cbkiyanda/AR/Documents/Capstone 2017-18/Design Proposal and Feasibility Study/12 MINI_PDM_V1.pdf

CAPSTONE MiniPDM | Page 1 of 1
Year | 2017
Team | Group #9
Device | AR Headset
| | | | | CASH | CASH | CAPCOIN | CAPCOIN | SPONSOR
CODE | Item Description | Drawing#/Part# | MNF/OEM/SPL | QTY | Material [$] | Labour [$] | CODE | Capcoin$ | In Kind
1 | Screen | SC-01 | | 1 | | - | - | - | Dr. Kiyanda
2 | Adafruit BNO 055 (motion sensor) | MS-01 | | 1 | | - | - | - | Dr. Kiyanda
3 | Intel realsense camera R200 | IR-01 | TO BE PURCHASED | 1 | 100 | - | - | -
4 | Odroid XU4 | XU4-01 | TO BE PURCHASED | 1 | 107 | - | - | -
5 | Headset | HS-01 | STUDENT (3D PRINT) | 1 | | - | - | -
6 | Top cover | TC-01 | STUDENT (3D PRINT) | 1 | | - | - | -
7 | Back cover | BC-01 | STUDENT (3D PRINT) | 1 | | - | - | -
8 | Back piece | BP-01 | STUDENT (3D PRINT) | 1 | | - | - | -
9 | Screen viewer | SV-01 | | 1 | | - | - | -
10
SUBTOTALS | 207 | 0 | 0 | 0 | 0

CON-M490-295.20/09/2012
