cbkiyanda/AR/Documents/Capstone 2017-18/FFF/TSPCD  (1).pdf

CAPSTONE TEST SPECIFICATION | Page 1 of 1 TEAM xx
Team | #9
Device | Augmented Reality Headset
Test date | TBD | | VERSION
Location | Concordia University | Program Manager | 1.0
Test LEAD | Faraz Yunus | Professor
Test co-lead | Nicholas Cierson
Test STAFF | TBD

Observers

## ENGINEERING VALIDATION TESTS

## HAZARD and MISHAP ANALYSIS

Hazard types
(ref 2)
Name of analysis | Description of test | Expected | Observed | Date | Movement | stored energy sharp edges electricity substancesradiation physical agents | Severity Probability Corrective or Control ActionAction verified Implementation Date
VAL1 | Drop Test | Drop the AR headset at different heights and observe whether device failure
| occurs
No Failure Occurs | No | Yes | Yes | No | No | No | Danger of flying objects | Medium | High | Proper protective equipment worn during test. Fire extinguisher is nearby.
| No | No | Yes | No | No | No | Danger of Fire | Medium | Low
| No | No | Yes | No | No | No | Danger of flying objects and burning yourself | Medium | Low
No Hardware comes Loose | No | No | Yes | No | No | No | Danger of flying objects | Medium | Medium
VAL2 | Thermal Test Part A | The AR headset will be run to its maximum capacity to demonstrate its baseline temperature
VAL3 | Thermal Test Part B | The AR headset will be placed in the wind tunnel to find the optimal air speed required to bring the temperature to 30C
VAL4 | Vibration Test | Vibrate the AR headset in a vibration machine and observe whether the
harware comes loose

## PREOPERATION CHECKS FOR VAL 1

SAFETY
Name of Task | Description | Checked | Initials | Date
SFT1 | Test Brief | Inform everyone of the test taking place
SFT2 | Personal Protective Equipment | Ensure all test personnel are wearing the appropriate protective equipment (Safety Glasses)
SFT3 | Projectile | Ensure a barrier is placed to limit the movement of projectiles

DEVICE INTEGRITY

DEV1 | Structural | Ensure that the AR headset is free from structural damage
DEV2 | Assembly - BOM | Assembly is complete - no missing components.

INSPECTION

INS1 | Device Inspection | Engineer or Staff signature :

## PREOPERATION CHECKS FOR VAL 2

SAFETY
Name of Task | Description | Checked | Initials | Date
SFT1 | Test Brief | Inform everyone of the test taking place
SFT2 | Fire | Ensure a fire extinguisher is near by in case of a fire

DEVICE INTEGRITY

DEV1 | Structural | Ensure that the AR headset is free from structural damage
DEV2 | Assembly - BOM | Assembly is complete - no missing components.

SYSTEM INTEGRITY

SYS1 | Temperature | Ensure a thermocouple is placed inside of the AR headset

INSPECTION
INS1 | Device Inspection | Engineer or Staff signature :

## PREOPERATION CHECKS FOR VAL 3

SAFETY
Name of Task | Description | Checked | Initials | Date
SFT1 | Test Brief | Inform everyone of the test taking place

DEVICE INTEGRITY

DEV1 | Structural | Ensure that the AR headset is free from structural damage
DEV2 | Assembly - BOM | Assembly is complete - no missing components.
DEV3 | Fasteners | Ensure that the AR headset is properly fastened to the windtunnel

SYSTEM INTEGRITY

SYS1 | Temperature | Ensure a thermocouple is placed inside of the AR headset
SYS2 | Wind Tunnel | Ensure that the Wind tunnel is working
SYS3 | Kill Switch | Ensure that the kill switch for the wind tunnel is free of obstruction and operational. TEST

INSPECTION
INS1 | Device Inspection | Engineer or Staff signature :

## PREOPERATION CHECKS FOR VAL 4

SAFETY
Name of Task | Description | Checked | Initials | Date
SFT1 | Test Brief | Inform everyone of the test taking place
SFT2 | Personal protective equipment | Ensure all test personnel are wearing the appropriate protective equipment (Safety Glasses)

DEVICE INTEGRITY

DEV1 | Structural | Ensure that the AR headset is free from structural damage
DEV2 | Assembly - BOM | Assembly is complete - no missing components.
DEV3 | Fasteners | Ensure that the AR headset is properly fastened to the vibration machine

SYSTEM INTEGRITY

SYS1 | Vibration | Ensure that the vibration machine is woking
SYS2 | Kill Switch | Ensure that the kill switch for the vibration machine is free of obstruction and operational. TEST

INSPECTION
INS1 | Device Inspection | Engineer or Staff signature :

## PRE-TEST

Objective | Description of Test | Checked | Initials | Date
OPS1 | Baseline Temperature | Bring the AR headset to its baseline temperature, required for "Thermal Test
| Part B"

COMMENTS

References
1 | MIL-STD-882D
2 | Safey with Machinery, John Ridley and Dick Pearce, 2006

Approvals for testing

Description

CON M490-285.04/03/2014
