cbkiyanda/AR/Documents/Capstone 2017-18/Final Report/Final Gantt Chart.xlsx

AUGMENTED REALITY HEADSET
TEAM 9
 |  | September |  |  |  | October |  |  |  | November |  |  |  | December |  |  |  | January |  |  |  | February |  |  |  | March |  |  |  | April
TASK | ASSIGNED TO | 1899-12-31 | 1900-01-01 | 1900-01-02 | 1900-01-03 | 1899-12-31 | 1900-01-01 | 1900-01-02 | 1900-01-03 | 1899-12-31 | 1900-01-01 | 1900-01-02 | 1900-01-03 | 1899-12-31 | 1900-01-01 | 1900-01-02 | 1900-01-03 | 1899-12-31 | 1900-01-01 | 1900-01-02 | 1900-01-03 | 1899-12-31 | 1900-01-01 | 1900-01-02 | 1900-01-03 | 1899-12-31 | 1900-01-01 | 1900-01-02 | 1900-01-03 | 1899-12-31 | 1900-01-01 | 1900-01-02 | 1900-01-03
Preliminary Design Ideas, Brainstorming and Planning
Project Choice | All
Project Planning and Deadline Setting | Rahul
Initial Capstone Professor Meeting | All
Setting Design Criterias and Scope of Project | Rahul
Letter of Intent/Team Engineering | All
Audit 1 | All
Conceptual Design
Initial Design (V1) | Amir
Updating Design Revisions (V2-5) | Amir, Michael
Design Proposal and Feasibility Study | All
Audit 2 | All
FFF Completion | All
Manufacturing, Sourcing and Assembly
3D Printing Revisions 1-5 | Haseb
Component Sourcing | Kostas
Audit 3 | All
Audit 4 Package | Rahul
Midterm Progress Report + Pres | All
Final Manufacturing Drawing | All
Hardware/Software Integration
BNO055 Integration | Nicholas
Libreal Sense Integration | Nicholas
Pyreal Sense Integration | Nicholas
Coding Demos | Nicholas
Debugging | Nicholas
Testing and Engineering Analysis (FEA)
TSPCD | Faraz, Rahul
Steady force and Impact Test | Haseb, Faraz
Thermal and Vibration Test | Michael, Haseb
Screen Angle Test | Michael, Haseb
Drop Test | Kostas
FEA Engineering Analysis (Structural, Drop, Thermal) | Amir, Rahul
Final Project Documentation and Presentation
Prototype Demonstration Preparation | All
Audit 5 Preparation | All
Workbook and Doc Control | All
Final Capstone Report | All
Poster Session Preperation | All
