cbkiyanda/AR/Documents/Capstone 2017-18/Audit 4/IMG_3721.JPG

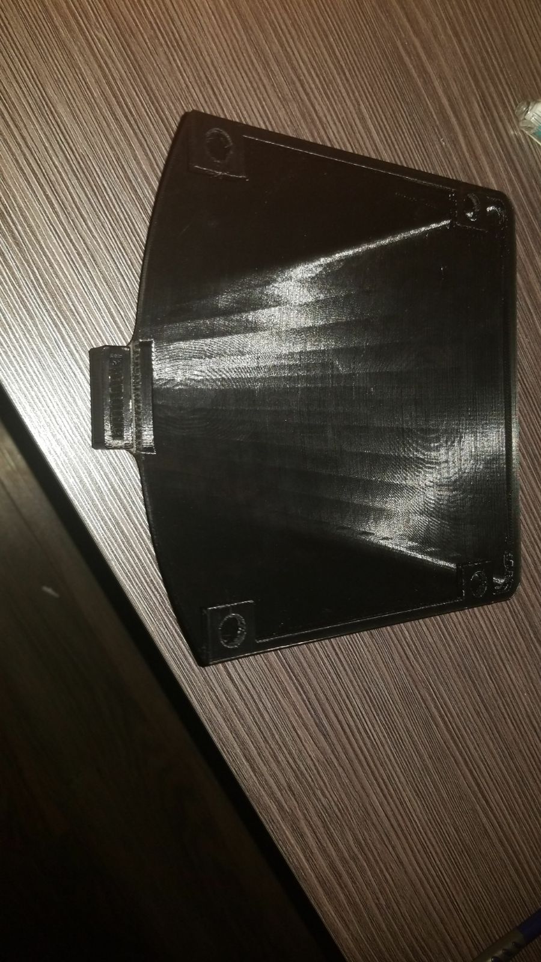
Documents/Capstone 2017-18/Audit 4/IMG_3721.JPG
