cbkiyanda/AR/Documents/Capstone 2017-18/Engineering Drawings/V5/Screenshot 1.png

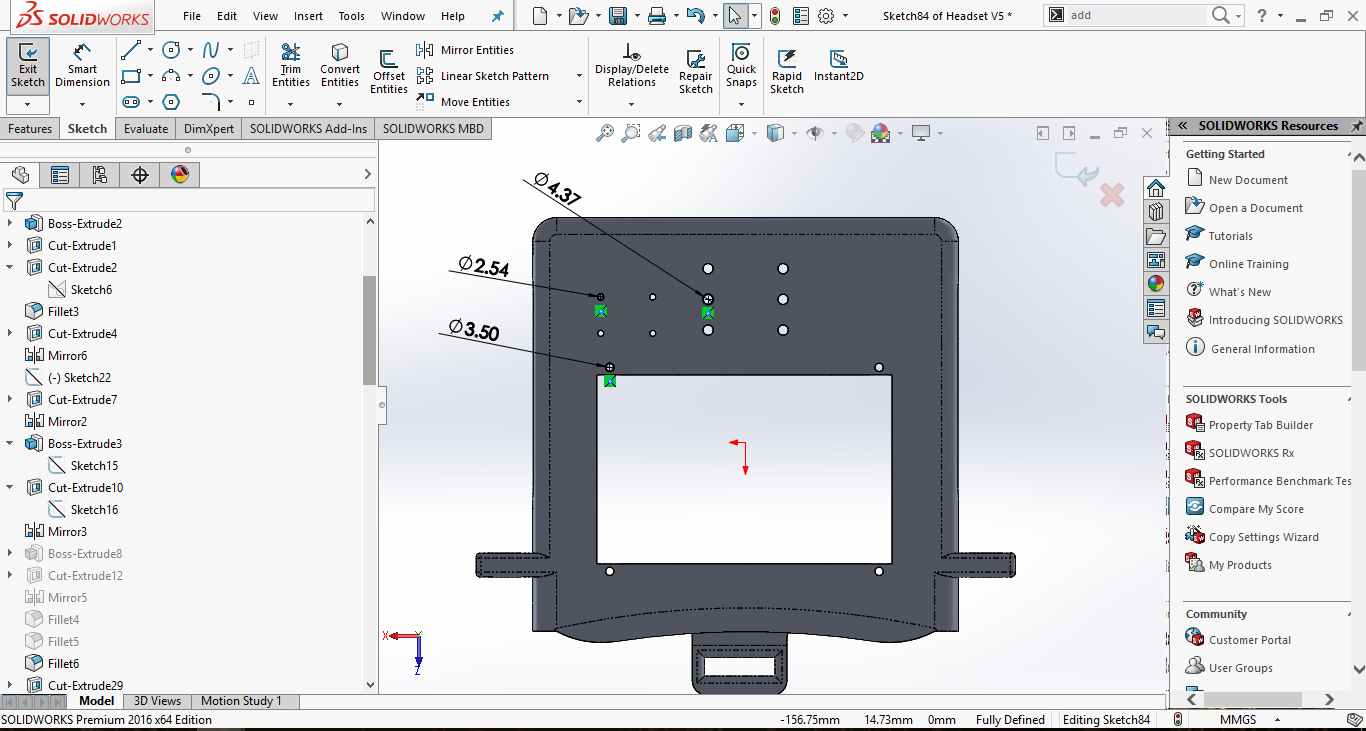
Documents/Capstone 2017-18/Engineering Drawings/V5/Screenshot 1.png
