cbkiyanda/AR/Documents/Capstone 2017-18/Engineering Drawings/V5/Screenshot 2.png

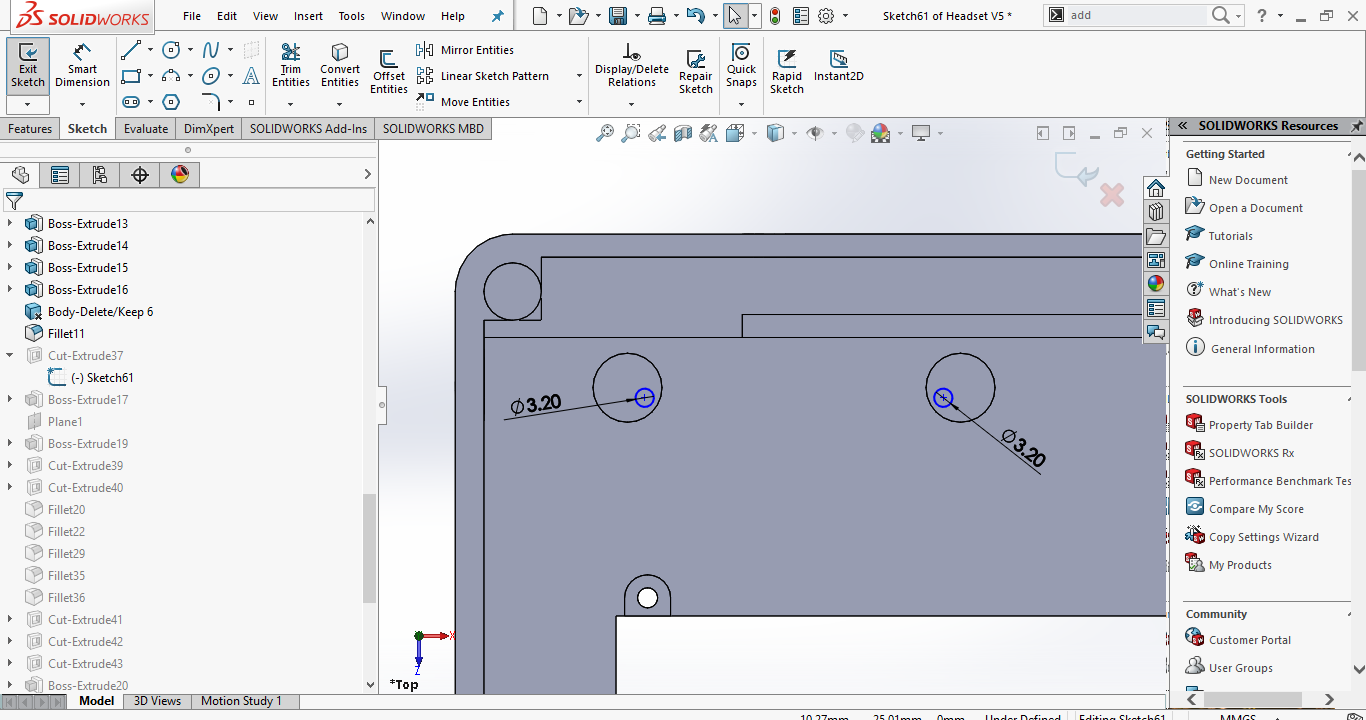
Documents/Capstone 2017-18/Engineering Drawings/V5/Screenshot 2.png
