cbkiyanda/AR/Documents/Capstone 2017-18/Final Report/4a936c2b-bbe0-454d-a4c9-a7ad5c63fba5.jpg

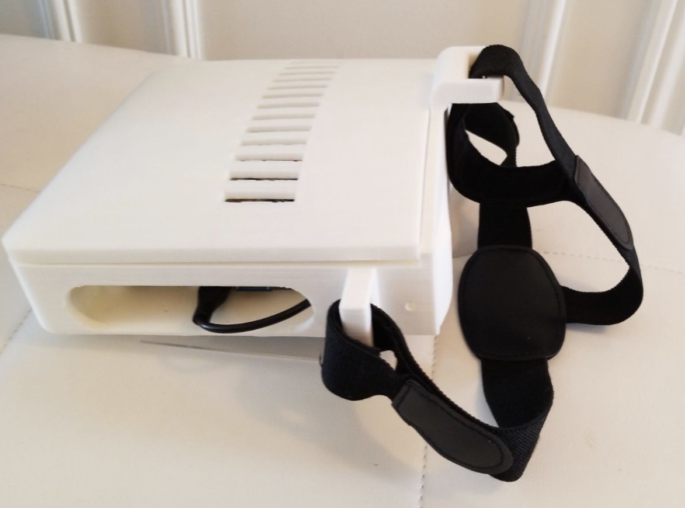
Documents/Capstone 2017-18/Final Report/4a936c2b-bbe0-454d-a4c9-a7ad5c63fba5.jpg
