cbkiyanda/AR/Documents/Capstone 2017-18/Final Report/4e1723fa-922e-4120-b9d4-401a825bd13e.jpg

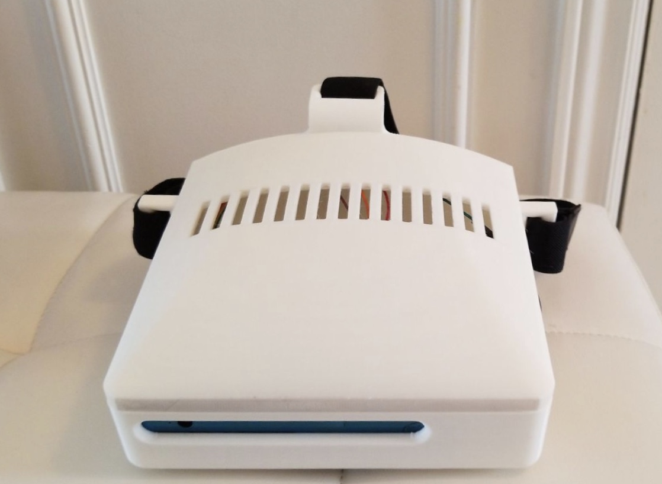
Documents/Capstone 2017-18/Final Report/4e1723fa-922e-4120-b9d4-401a825bd13e.jpg
