cbkiyanda/AR/Documents/Capstone 2017-18/Final Report/cc905d96-fdc8-4c7b-92a6-f9114a60a53a.jpg

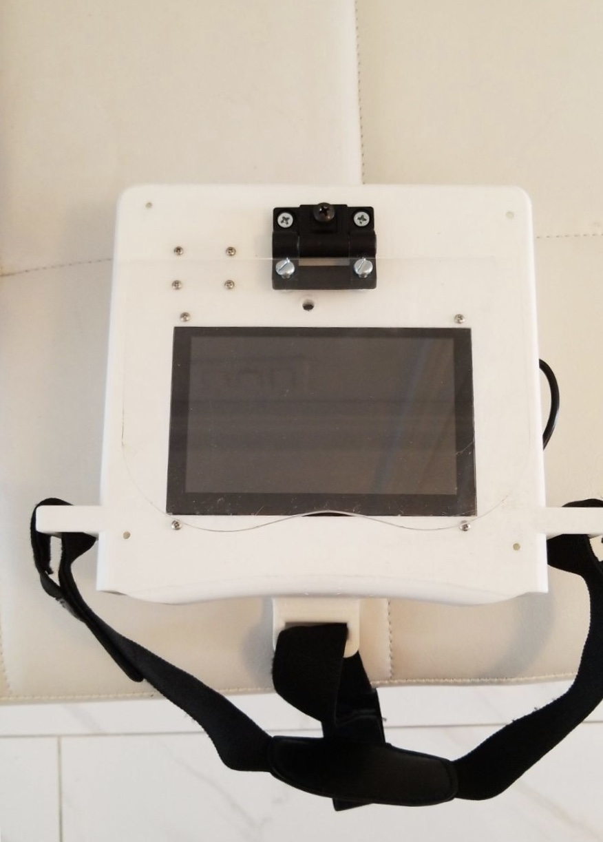
Documents/Capstone 2017-18/Final Report/cc905d96-fdc8-4c7b-92a6-f9114a60a53a.jpg
