cbkiyanda/AR/Documents/Capstone 2017-18/Final Report/cost analysis-V7.xlsx

AR Headset Cost Analysis
Itemized Components | Purchased/Manufactured/Sponsor | Labour Hours | Cost ($)
Display
5 in HDMI screen | Purchased |  | 100.46
Heads Up Display | Sponsor
Heads Up Display Hinge | Purchased |  | 36.83
Headset
Headset | Manufactured - External |  | 35.5
Headband cushion and padding | Sponsor
Headstrap | Sponsor
Headset top cover | Manufactured - External |  | 20.84
Sensors
Adafruit BNO055 Orientation sensor | Purchased |  | 63.74
Intel RealSense R200 Depth Sensor | Purchased |  | 153.36
Processors
Raspberry pi 3 | Sponsor
Odroid - XU4 (Heat sink + Fan incl.) | Purchased |  | 163.02
Hardware
Pan Head Phillips, #8-32 Thread, 1/2" LG, Zinc-Pltd Stl | Purchased |  | 4.07
Pan Head Phillips, #8-32 Thread, 7/8" LG, Zinc-Pltd Stl | Purchased |  | 6.46
Flat Head Phillips, #2-56 Thread, 1/2" LG, Zinc-Pltd Stl | Purchased |  | 5.78
Flat Head Phillips, #6-32 Thread, 5/8" LG, Zinc-Pltd Stl | Purchased |  | 4.97
Flat Head Phillips, #4-48 Thread, 3/8"LG, 18-8 SS | Purchased |  | 18.1
#8-32 Hex Nut, Low-Strength Steel | Purchased |  | 2.07
#2-56 Hex Nut, Low-Strength Steel | Purchased |  | 1.26
#6-32 Hex Nut, Low-Strength Steel | Purchased |  | 1.61
Power and Connectivity
Odroid Wifi Module Adapter | Purchased |  | 26.68
Four Port USB 3.0 Hub | Purchased |  | 42.56
MicroSD 16GB USH-1 | Purchased |  | 12.64
Male 90 degree USB Connector | Purchased |  | 8.97
90 degree 0.2m HDMI Cable | Purchased |  | 11.38
Other
 |  | Total Cost ($) | 720.3
