cbkiyanda/AR/Documents/Capstone 2017-18/MiniPDM/CON-M490-295_MiniPDM_TEAM9 _Version4_v2cad.xlsx

Sheet: GENERIC
 |  |  |  |  |  |  |  |  |  | Year | 2017
 |  |  |  |  |  |  |  |  |  | Team | Group #9
 |  |  |  |  |  |  |  |  |  | Device | AR Headset
 |  |  |  |  |  | CASH | CASH | TIME | CAPCOIN | CAPCOIN | SPONSOR
CODE | Item | Description | Drawing#/Part# | MNF/OEM/SPL | QTY | Material [$] | Labour [$] | Time[hr] | CODE | Capcoin$ | In Kind
 | 1 | HEADSET V2 | 11709101 | EXTERNAL - 3D HUB | 1 | 44.9 | - |  | - | -
 | 2 | TOP COVER V2 | 11709102 | EXTERNAL - 3D HUB | 1 | 24.07 | - |  | - | -
 | 3 | BACK COVER V2 | 11709103 | EXTERNAL - 3D HUB | 1 | 8.32 | - |  | - | -
 | 4 | BACK PIECE | 11709104 | STUDENT - Kostas - 3D print | 1 |  | - |  | - | -
 | 5 | HEAD STRAP | 11709105 |  | 2 |  | - |  | - | -
 | 6 | SCREEN V3 | 11709201 |  | 1 |  | - |  | - | - | Dr. Charles Kiyanda
 | 7 | ADAFRUIT BNO 055 (motion sensor) V2 | ADA2472 |  | 1 |  | - |  | - | - | Dr. Charles Kiyanda
 | 8 | INTEL REALSENSE CAMERA R200 | MM#939143 | INTEL REALSENSE | 1 | 153.36 | - |  | - | -
 | 9 | ODROID XU4 | 0007A | AMERIDROID.COM | 1 | 120.57 | - |  | - | -
 | 10 | FASTENER, FLAT, M3.5 X 0.6mm | 91420A173 | MCMASTER | 100 | 3.02 | - |  | - | -
 | 11 | FASTENER, FLAT, M2.5 X 0.45mm | 92010A016 | MCMASTER | 100 | 4.99 | - |  | - | -
 | 12 | HEX NUT, M3.5 | 90592A010 | MCMASTER | 100 | 2.28 | - |  | - | -
 | 13 | HEX NUT, M2.5 | 90592A006 | MCMASTER | 100 | 1.37 | - |  | - | -
 |  | SUBTOTALS |  |  |  | 362.88 | 0 |  | 0 | 0 | 0

Sheet: EXPLANATIONS
 |  |  |  |  |  |  |  |  |  | Presenting year | 9999
 |  |  |  |  |  |  |  |  |  | Team | 55
 |  |  |  |  |  |  |  |  |  | Device | WIDGET THING
 |  |  |  |  |  | CASH | CASH | CAPCOIN | CAPCOIN | SPONSOR
code | Item | Description | Drawing#/Part# | MNF/OEM/SPL | QTY | Material [$] | Labour [$] | CODE | Capcoin$ | In Kind
999955 | 1 | BRACKET | 11215001 | STUDENT | 1 | 5 |  | MIKEY1 | 50
999955 | 2 | CASING | 11215002 | EDML A | 2 | 50 |  | JALFR2 | 200
999955 | 3 | GEAR, DRIVE, CUSTOM | 11215003 | MMINUTE GEARMAKER INC | 4 | 200 | 450
999955 | 4.1 | GEAR, 18 PA, 18 PD, 24 TOOTH | BR2342tnG-243 | BOSTON GEAR | 4 | 200
999955 | 4.2 | GEAR, DRIVEN, CUSTOM | 11215004 | STUDENT |  |  |  | MIKEY1 | 150
999955 | 4.3 |  | 11215004 | EDML A |  |  |  | JALFR1 | 200
999955 | 5.1 | GEAR, 18 PA, 18 PD, 24 TOOTH | BR2342tnG-243 | BOSTON GEAR | 3 | 150
999955 | 5.2 |  | 11215005 | EDML A |  |  |  | JALFR1 | 125
999955 | 6 | MOD, CLAMP | 23452623 | MCMASTER / STUDENT | 3 | 50 |  | MIKEY1 | 75
999955 | 7 | PAINT RED | BEHR 345123 | EDML C | 1 | 25 |  | EDMLC | 25
999955 | 8 | MOTOR, DC, 0.5 HP | MM23452 | EDML C | 1 |  |  |  |  | 250
999955 | 9 | MOTOR, AC, 1 HP | SDFJK125 | BROWNING |  |  |  |  |  | 500
 |  | SUBTOTALS |  |  |  | 680 | 450 |  | 825 | 750
 | 1 | You design a part and expect to manufacture it yourself in EDML B - material from EDML
 | 2 | You design a part and expect EDML A [juan] to manufacture it for you
 | 3 | You design a part and expect to have it manufactured externally
 | 4 | Your part will take multiple manufacturers to produce
 | 5 | Modification of OEM
 | 6 | Modification of Supplier
 | 7 | Process after assembly
 | 8 | oem part supplied by EDML
 | 9 | oem part sponsored by BROWNING
