cbkiyanda/AR/Documents/Capstone 2017-18/MiniPDM/MiniPDM_TEAM9 _Version5_v3cadnotprinted.xlsx

Sheet: GENERIC
 |  |  |  |  |  |  |  |  |  |  | Year | 2017
 |  |  |  |  |  |  |  |  |  |  | Team | Group #9
 |  |  |  |  |  |  |  |  |  |  | Device | AR Headset
 |  |  |  |  |  |  | CASH | CASH | TIME | CAPCOIN | CAPCOIN | SPONSOR
CODE | Item | Description | Drawing#/Part# | MNF/OEM/SPL | QTY | Volume [in3] | Material [$] | Labour [$] | Time[hr] | CODE | Capcoin$ | In Kind
 |  | VERSION 3
 | 1 | HEADSET | 11709001 | EXTERNAL | 1 | 17.16
 | 2 | TOP COVER | 11709002 | EXTERNAL | 1 | 7.1
 | 3 | BACK COVER | 11709003 | EXTERNAL | 1 | 3.94
 | 4 | BACK PIECE | 11709004 | STUDENT - Kostas - 3D print | 1 | 1.39
 | 5 | HEAD STRAP | 11709005 | STUDENT - Kostas | 2
 | 6 | HEADS UP DISPLAY | 11709006 | AMAZON | 1
 | 7 | HEADS UP DISPLAY HINGE | 11709007 | EXTERNAL | 1
 | 8 | SCREEN | 11709011 | AMERIDROID.COM | 1
 | 9 | ADAFRUIT BNO 055 MOTION SENSOR | ADA2472 | ADAFRUIT | 1
 | 10 | INTEL REALSENSE CAMERA R200 | MM#939143 | INTEL REALSENSE | 1 |  | 153.36
 | 11 | ODROID XU4 | 0007A | AMERIDROID.COM | 1 |  | 120.57
 | 12 | PAN HEAD PHILLIPS, #6-32 THREAD | 90272A152 | MCMASTER | 4
 | 13 | ROUND HEAD PHILLIPS, #4-40 THREAD | 90279A108 | MCMASTER | 4
 | 14 | ROUND HEAD PHILLIPS, 1/4"-20 THREAD | 90279A542 | MCMASTER | 2
 | 15 | ROUND HEAD PHILLIPS, #6-32 THREAD | 91773A146 | MCMASTER | 4
 | 16 | HEX NUT, #4-40 THREAD | 90480A005 | MCMASTER | 4
 | 17 | HEX NUT, #6-32 THREAD | 90480A007 | MCMASTER | 8
 | 18 | NARROW HEX NUT, #6-32 THREAD | 90760A007 | MCMASTER | 2
 | 19 | CAP NUT, 1/4"-20 THREAD, 1/4" THREAD DEPTH | 91875A130 | MCMASTER | 2
 | 20 | THREADED STUD, 6-32 THREAD | 95475A244 | MCMASTER | 1
 | 21 | MALE 90 DEGREE RIGHT ANGLE CABLE CORD |  | AMAZON | 1 |  | 8.97
 | 22 | LARRITS 0.5M HIGH SPEED V2.0 HDMI CABLE |  | AMAZON | 1 |  | 8.39
 | 23 | SanDisk ULTRA 32GB microSDHC |  | AMAZON | 1 |  | 19.98
 | 24 | HEADS-UP DISPLAY - ACRYLIC SHEET |  |  |  |  |  |  |  |  |  | TECHNOLOGY SANDBOX
 |  | VERSION 2
 | 1 | HEADSET V2 | 11709101 | EXTERNAL - 3D HUB | 1 | 20.97 | 44.9 | - |  | - | -
 | 2 | TOP COVER V2 | 11709102 | EXTERNAL - 3D HUB | 1 | 8.17 | 24.07 | - |  | - | -
 | 3 | BACK COVER V2 | 11709103 | EXTERNAL - 3D HUB | 1 | 3.85 | 8.32 | - |  | - | -
 | 4 | BACK PIECE | 11709104 | STUDENT - Kostas - 3D print | 1 | 1.39 |  | - |  | - | -
 | 5 | HEAD STRAP | 11709105 |  | 2 |  |  | - |  | - | -
 | 6 | SCREEN V3 | 11709201 |  | 1 |  |  | - |  | - | -
 | 7 | ADAFRUIT BNO 055 (motion sensor) V2 | ADA2472 |  | 1 |  |  | - |  | - | -
 | 8 | INTEL REALSENSE CAMERA R200 | MM#939143 | INTEL REALSENSE | 1 |  |  | - |  | - | -
 | 9 | ODROID XU4 | 0007A | AMERIDROID.COM | 1 |  |  | - |  | - | -
 | 10 | FASTENER, FLAT, M3.5 X 0.6mm | 91420A173 | MCMASTER | 100 |  |  | - |  | - | -
 | 11 | FASTENER, FLAT, M2.5 X 0.45mm | 92010A016 | MCMASTER | 100 |  |  | - |  | - | -
 | 12 | HEX NUT, M3.5 | 90592A010 | MCMASTER | 100 |  |  | - |  | - | -
 | 13 | HEX NUT, M2.5 | 90592A006 | MCMASTER | 100 |  |  | - |  | - | -
 |  | VERSION 1
 | 1 | HEADSET V1 | HS-01 | EXTERNAL - 3D HUB | 1 |  | 22
 | 2 | TOP COVER V1 | TC-01 | TECHNOLOGY SANDBOX | 2
 | 3 | BACK COVER V1 | BC-01 | STUDENT - Kostas | 1
 | 4 | BACK PIECE | BP-02 | STUDENT - Kostas | 1
 | 5 | SCREEN V1 | SC-01 |  | 1 |  |  |  |  |  |  | Dr. Charles Kiyanda
 | 6 | ADAFRUIT BNO 055 (motion sensor) V1 | MS-01 |  | 1 |  |  |  |  |  |  | Dr. Charles Kiyanda
 | 7 | INTEL REALSENSE CAMERA R200 | MM#939143 | INTEL REALSENSE | 1
 | 8 | ODRIOID XU4 | 0007A | AMERIDROID.COM | 1
 |  | SUBTOTALS |  |  |  |  | 410.56 | 0 |  | 0 | 0 | 0

Sheet: EXPLANATIONS
 |  |  |  |  |  |  |  |  |  | Presenting year | 9999
 |  |  |  |  |  |  |  |  |  | Team | 55
 |  |  |  |  |  |  |  |  |  | Device | WIDGET THING
 |  |  |  |  |  | CASH | CASH | CAPCOIN | CAPCOIN | SPONSOR
code | Item | Description | Drawing#/Part# | MNF/OEM/SPL | QTY | Material [$] | Labour [$] | CODE | Capcoin$ | In Kind
999955 | 1 | BRACKET | 11215001 | STUDENT | 1 | 5 |  | MIKEY1 | 50
999955 | 2 | CASING | 11215002 | EDML A | 2 | 50 |  | JALFR2 | 200
999955 | 3 | GEAR, DRIVE, CUSTOM | 11215003 | MMINUTE GEARMAKER INC | 4 | 200 | 450
999955 | 4.1 | GEAR, 18 PA, 18 PD, 24 TOOTH | BR2342tnG-243 | BOSTON GEAR | 4 | 200
999955 | 4.2 | GEAR, DRIVEN, CUSTOM | 11215004 | STUDENT |  |  |  | MIKEY1 | 150
999955 | 4.3 |  | 11215004 | EDML A |  |  |  | JALFR1 | 200
999955 | 5.1 | GEAR, 18 PA, 18 PD, 24 TOOTH | BR2342tnG-243 | BOSTON GEAR | 3 | 150
999955 | 5.2 |  | 11215005 | EDML A |  |  |  | JALFR1 | 125
999955 | 6 | MOD, CLAMP | 23452623 | MCMASTER / STUDENT | 3 | 50 |  | MIKEY1 | 75
999955 | 7 | PAINT RED | BEHR 345123 | EDML C | 1 | 25 |  | EDMLC | 25
999955 | 8 | MOTOR, DC, 0.5 HP | MM23452 | EDML C | 1 |  |  |  |  | 250
999955 | 9 | MOTOR, AC, 1 HP | SDFJK125 | BROWNING |  |  |  |  |  | 500
 |  | SUBTOTALS |  |  |  | 680 | 450 |  | 825 | 750
 | 1 | You design a part and expect to manufacture it yourself in EDML B - material from EDML
 | 2 | You design a part and expect EDML A [juan] to manufacture it for you
 | 3 | You design a part and expect to have it manufactured externally
 | 4 | Your part will take multiple manufacturers to produce
 | 5 | Modification of OEM
 | 6 | Modification of Supplier
 | 7 | Process after assembly
 | 8 | oem part supplied by EDML
 | 9 | oem part sponsored by BROWNING
