cbkiyanda/AR/Documents/Capstone 2017-18/MiniPDM/MiniPDM_TEAM9 _Version7_v5cad.xlsx

Sheet: GENERIC
 |  |  |  |  |  |  |  |  |  |  | Year | 2018
 |  |  |  |  |  |  |  |  |  |  | Team | Group #9
 |  |  |  |  |  |  |  |  |  |  | Device | AR Headset
 |  |  |  |  |  |  | CASH | CASH | TIME | CAPCOIN | CAPCOIN | SPONSOR | SPONSOR
CODE | Item | Description | Drawing#/Part# | MNF/OEM/SPL | QTY | Volume [in3] | Material [$] | Labour [$] | Time[hr] | CODE | Capcoin$ | In Kind | Amount [$/pack]
 |  | VERSION 5
 | 1 | HEADSET | 11809001 | EXTERNAL - 3D HUBS | 1 | 18.169 | 35.5
 | 2 | TOP COVER | 11809002 | EXTERNAL - 3D HUBS | 1 | 8.07 | 21.27
 |  | *STARTUP COST |  |  |  |  | 1
 |  | *BULK DISCOUNT |  |  |  |  | -1.43
 | 3 | HEAD STRAP | 11809005 | STUDENT - Amir | 1 |  |  |  |  |  |  | STUDENT - Amir Shawwa
 | 4 | HEADS-UP DISPLAY | 11809006 | STUDENT - Kostas | 3 |  |  |  |  |  |  | STUDENT - Kostas Zoitakis
 | 5 | ADJUSTABLE-FRICTION HINGE | 1791A440 | MCMASTER | 2 |  | 36.83
 | 6 | ODROID V5 - SCREEN | 11809011 | AMAZON | 1
 | 7 | ADAFRUIT BNO 055 MOTION SENSOR | ADA 2472 | ADAFRUIT | 1
 | 8 | INTEL REALSENSE CAMERA R200 | MM#939143 | INTEL REALSENSE | 1
 | 9 | ORDOID XU4 -V2 | 0007A | AMERIDROID.COM | 1
 | 10 | PAN HEAD PHILLIPS, #8-32 THREAD, 1/2" LG, ZINC-PLTD STL | 90272A194 | MCMASTER | 2 |  |  |  |  |  |  | STUDENT - Kostas Zoitakis | $4.07/100
 | 11 | PAN HEAD PHILLIPS, #8-32 THREAD, 7/8" LG, ZINC-PLTD STL | 90272A198 | MCMASTER | 2 |  |  |  |  |  |  | STUDENT - Kostas Zoitakis | $6.46/100
 | 12 | FLAT HEAD PHILLIPS, #2-56 THREAD, 1/2" LG, ZINC-PLTD STL | 90273A070 | MCMASTER | 4 |  |  |  |  |  |  | STUDENT - Kostas Zoitakis | $5.78/100
 | 13 | FLAT HEAD PHILLIPS, #6-32 THREAD, 5/8" LG, ZINC-PLTD STL | 90273A150 | MCMASTER | 4 |  |  |  |  |  |  | STUDENT - Kostas Zoitakis | $4.97/100
 | 14 | FLAT HEAD PHILLIPS, #4-48 THREAD, 3/8"LG, 18-8 SS | 91771A742 | MCMASTER | 2 |  |  |  |  |  |  | STUDENT - Kostas Zoitakis | $18.10/100
 | 15 | #8-32 HEX NUT, LOW-STRENGTH STEEL | 90480A009 | MCMASTER | 4 |  |  |  |  |  |  | STUDENT - Kostas Zoitakis | $2.07/100
 | 16 | #2-56 HEX NUT, LOW-STRENGTH STEEL | 90480A003 | MCMASTER | 4 |  |  |  |  |  |  | STUDENT - Kostas Zoitakis | $1.26/100
 | 17 | #6-32 HEX NUT, LOW-STRENGTH STEEL | 90480A007 | MCMASTER | 4 |  |  |  |  |  |  | STUDENT - Kostas Zoitakis | $1.61/100
 |  | VERSION 4
 | 1 | HEADSET | 11809001 | EXTERNAL - 3D HUBS | 1 | 13.51 | 25.17
 | 2 | TOP COVER | 11809002 | EXTERNAL - 3D HUBS | 1 | 10.76 | 22.36
 | 3 | BACK COVER | 11809003 | EXTERNAL - 3D HUBS | 1 | 3.51 | 6.3
 |  | *STARTUP COST |  |  |  |  | 1
 |  | *BULK DISCOUNT |  |  |  |  | -1.34
 | 4 | BACK PIECE | 11709004 | STUDENT - Kostas - 3D print | 1
 | 5 | HEAD STRAP | 11709005 | STUDENT - Kostas | 2
 | 6 | HEADS UP DISPLAY - ACRYLIC SHEET |  | STUDENT - Kostas | 1
 | 7 | HEADS UP DISPLAY HINGE |  | STUDENT - Amir | 1
 | 8 | ODROID V5 - SCREEN | 11809011 | AMAZON | 1 |  | 100.46
 | 9 | ADAFRUIT BNO 055 MOTION SENSOR | ADA 2472 | ADAFRUIT | 1 |  | 63.74
 | 10 | INTEL REALSENSE CAMERA R200 | MM#939143 | INTEL REALSENSE | 1
 | 11 | ODROID XU4 - V2 | 0007A | AMERIDROID.COM | 1 |  | 163.02
 | 12 | ROUND HEAD PHILIPS #4-40 THREAD, 3/8" LONG | 90279A108 | MCMASTER | 4
 | 13 | HEX NUT #4-40 THREAD | 90480A005 | MCMASTER | 4
 | 14 | HEX NUT #6-32 THREAD | 90480A007 | MCMASTER | 4
 | 15 | PAN HEAD PHILIPS #6-32 THREAD, 9/16" LONG | 91772A162 | MCMASTER | 4
 | 16 | PAN HEAD PHILIPS #6-32 THREAD, 7/16" LONG | 91772A149 | MCMASTER | 2
 | 17 | ODROID WIFI MODULE |  | DIIGIIT ROBOTICS | 1 |  | 26.68
 | 18 | 4 PORT USB HUB |  | AMAZON | 1 |  | 42.56
 | 19 | 16GB microSD |  | AMAZON | 1 |  | 12.64
 | 20 | 9V Battery - Pile Energizer |  | PHARMAPRIX | 1 |  | 8.15
 |  | VERSION 3
 | 1 | HEADSET | 11709001 | EXTERNAL | 1 | 17.16
 | 2 | TOP COVER | 11709002 | EXTERNAL | 1 | 7.1
 | 3 | BACK COVER | 11709003 | EXTERNAL | 1 | 3.94
 | 4 | BACK PIECE | 11709004 | STUDENT - Kostas - 3D print | 1 | 1.39
 | 5 | HEAD STRAP | 11709005 | STUDENT - Kostas | 2
 | 6 | HEADS UP DISPLAY | 11709006 | AMAZON | 1
 | 7 | HEADS UP DISPLAY HINGE | 11709007 | EXTERNAL | 1
 | 8 | SCREEN | 11709011 | AMERIDROID.COM | 1
 | 9 | ADAFRUIT BNO 055 MOTION SENSOR | ADA2472 | ADAFRUIT | 1
 | 10 | INTEL REALSENSE CAMERA R200 | MM#939143 | INTEL REALSENSE | 1 |  | 153.36
 | 11 | ODROID XU4 | 0007A | AMERIDROID.COM | 1 |  | 120.57
 | 12 | PAN HEAD PHILLIPS, #6-32 THREAD | 90272A152 | MCMASTER | 4
 | 13 | ROUND HEAD PHILLIPS, #4-40 THREAD | 90279A108 | MCMASTER | 4
 | 14 | ROUND HEAD PHILLIPS, 1/4"-20 THREAD | 90279A542 | MCMASTER | 2
 | 15 | ROUND HEAD PHILLIPS, #6-32 THREAD | 91773A146 | MCMASTER | 4
 | 16 | HEX NUT, #4-40 THREAD | 90480A005 | MCMASTER | 4
 | 17 | HEX NUT, #6-32 THREAD | 90480A007 | MCMASTER | 8
 | 18 | NARROW HEX NUT, #6-32 THREAD | 90760A007 | MCMASTER | 2
 | 19 | CAP NUT, 1/4"-20 THREAD, 1/4" THREAD DEPTH | 91875A130 | MCMASTER | 2
 | 20 | THREADED STUD, 6-32 THREAD | 95475A244 | MCMASTER | 1
 | 21 | MALE 90 DEGREE RIGHT ANGLE CABLE CORD |  | AMAZON | 1 |  | 8.97
 | 22 | LARRITS 0.5M HIGH SPEED V2.0 HDMI CABLE |  | AMAZON | 1 |  | 11.38
 | 23 | SanDisk ULTRA 32GB microSDHC |  | AMAZON | 1 |  | 19.98
 | 24 | HEADS-UP DISPLAY - ACRYLIC SHEET |  |  |  |  |  |  |  |  |  | TECHNOLOGY SANDBOX
 |  | VERSION 2
 | 1 | HEADSET V2 | 11709101 | EXTERNAL - 3D HUB | 1 | 20.97 | 44.9 | - |  | - | -
 | 2 | TOP COVER V2 | 11709102 | EXTERNAL - 3D HUB | 1 | 8.17 | 24.07 | - |  | - | -
 | 3 | BACK COVER V2 | 11709103 | EXTERNAL - 3D HUB | 1 | 3.85 | 8.32 | - |  | - | -
 |  | *STARTUP COST |  |  |  |  | 1
 |  | *BULK DISCOUNT |  |  |  |  | -10.24
 | 4 | BACK PIECE | 11709104 | STUDENT - Kostas - 3D print | 1 | 1.39 |  | - |  | - | -
 | 5 | HEAD STRAP | 11709105 |  | 2 |  |  | - |  | - | -
 | 6 | SCREEN V3 | 11709201 |  | 1 |  |  | - |  | - | -
 | 7 | ADAFRUIT BNO 055 (motion sensor) V2 | ADA2472 |  | 1 |  |  | - |  | - | -
 | 8 | INTEL REALSENSE CAMERA R200 | MM#939143 | INTEL REALSENSE | 1 |  |  | - |  | - | -
 | 9 | ODROID XU4 | 0007A | AMERIDROID.COM | 1 |  |  | - |  | - | -
 | 10 | FASTENER, FLAT, M3.5 X 0.6mm | 91420A173 | MCMASTER | 100 |  |  | - |  | - | -
 | 11 | FASTENER, FLAT, M2.5 X 0.45mm | 92010A016 | MCMASTER | 100 |  |  | - |  | - | -
 | 12 | HEX NUT, M3.5 | 90592A010 | MCMASTER | 100 |  |  | - |  | - | -
 | 13 | HEX NUT, M2.5 | 90592A006 | MCMASTER | 100 |  |  | - |  | - | -
 |  | VERSION 1
 | 1 | HEADSET V1 | HS-01 | EXTERNAL - 3D HUB | 1 |  | 24.2
 | 2 | TOP COVER V1 | TC-01 | TECHNOLOGY SANDBOX | 2
 | 3 | BACK COVER V1 | BC-01 | STUDENT - Kostas | 1
 |  | *STARTUP COST |  |  |  |  | 1
 |  | *BULK DISCOUNT |  |  |  |  | -2.28
 | 4 | BACK PIECE | BP-02 | STUDENT - Kostas | 1
 | 5 | SCREEN V1 | SC-01 |  | 1 |  |  |  |  |  |  | Dr. Charles Kiyanda
 | 6 | ADAFRUIT BNO 055 (motion sensor) V1 | MS-01 |  | 1 |  |  |  |  |  |  | Dr. Charles Kiyanda
 | 7 | INTEL REALSENSE CAMERA R200 | MM#939143 | INTEL REALSENSE | 1
 | 8 | ODRIOID XU4 | 0007A | AMERIDROID.COM | 1
 |  | SUBTOTALS |  |  |  |  | 969.14 | 0 |  | 0 | 0 | 0

Sheet: EXPLANATIONS
 |  |  |  |  |  |  |  |  |  | Presenting year | 9999
 |  |  |  |  |  |  |  |  |  | Team | 55
 |  |  |  |  |  |  |  |  |  | Device | WIDGET THING
 |  |  |  |  |  | CASH | CASH | CAPCOIN | CAPCOIN | SPONSOR
code | Item | Description | Drawing#/Part# | MNF/OEM/SPL | QTY | Material [$] | Labour [$] | CODE | Capcoin$ | In Kind
999955 | 1 | BRACKET | 11215001 | STUDENT | 1 | 5 |  | MIKEY1 | 50
999955 | 2 | CASING | 11215002 | EDML A | 2 | 50 |  | JALFR2 | 200
999955 | 3 | GEAR, DRIVE, CUSTOM | 11215003 | MMINUTE GEARMAKER INC | 4 | 200 | 450
999955 | 4.1 | GEAR, 18 PA, 18 PD, 24 TOOTH | BR2342tnG-243 | BOSTON GEAR | 4 | 200
999955 | 4.2 | GEAR, DRIVEN, CUSTOM | 11215004 | STUDENT |  |  |  | MIKEY1 | 150
999955 | 4.3 |  | 11215004 | EDML A |  |  |  | JALFR1 | 200
999955 | 5.1 | GEAR, 18 PA, 18 PD, 24 TOOTH | BR2342tnG-243 | BOSTON GEAR | 3 | 150
999955 | 5.2 |  | 11215005 | EDML A |  |  |  | JALFR1 | 125
999955 | 6 | MOD, CLAMP | 23452623 | MCMASTER / STUDENT | 3 | 50 |  | MIKEY1 | 75
999955 | 7 | PAINT RED | BEHR 345123 | EDML C | 1 | 25 |  | EDMLC | 25
999955 | 8 | MOTOR, DC, 0.5 HP | MM23452 | EDML C | 1 |  |  |  |  | 250
999955 | 9 | MOTOR, AC, 1 HP | SDFJK125 | BROWNING |  |  |  |  |  | 500
 |  | SUBTOTALS |  |  |  | 680 | 450 |  | 825 | 750
 | 1 | You design a part and expect to manufacture it yourself in EDML B - material from EDML
 | 2 | You design a part and expect EDML A [juan] to manufacture it for you
 | 3 | You design a part and expect to have it manufactured externally
 | 4 | Your part will take multiple manufacturers to produce
 | 5 | Modification of OEM
 | 6 | Modification of Supplier
 | 7 | Process after assembly
 | 8 | oem part supplied by EDML
 | 9 | oem part sponsored by BROWNING
