cbkiyanda/AR/Documents/Capstone 2017-18/Engineering Drawings/V5/Assembly V5.SLDASM

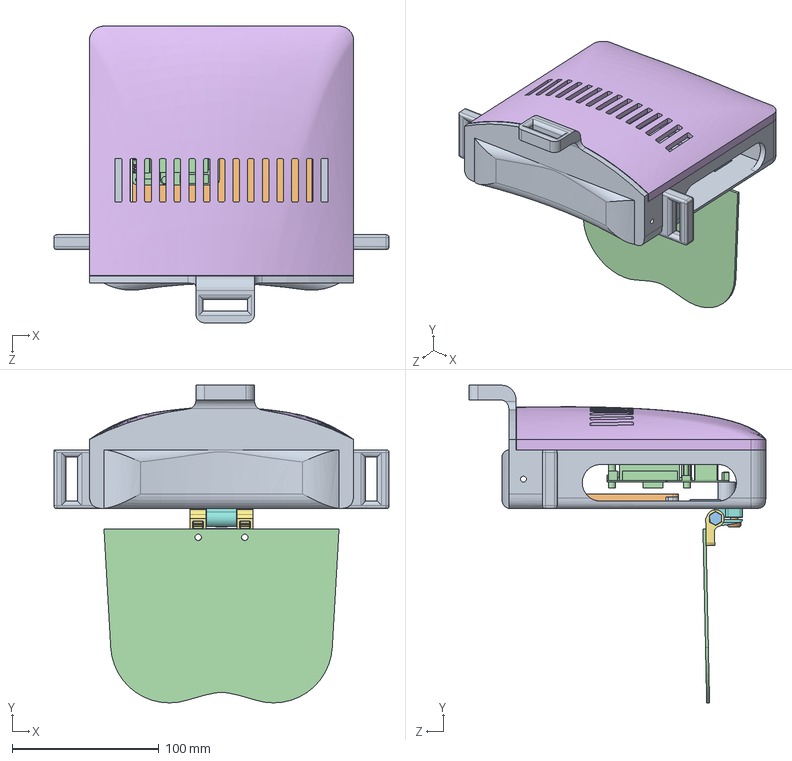
[picture p203: CAD file, 2018-04-01]
Documents/Capstone 2017-18/Engineering Drawings/V5/Assembly V5.SLDASM
228.0 x 216.3 x 202.0 mm
Headset V5
Screen V4
Adafruit BNO055 motion sensor v2
Intel real sense camera R200
Top Cover V5
DeleteFace7
E6_300_SERIES_ADJUSTMENT_NUT_FREE_RUNNING_CLF1-1-solid1
E6_STANDARD_PAN_HEAD_SCREW_CLF1-1-solid1
HUD
