cbkiyanda/AR/Documents/Capstone 2017-18/Engineering Drawings/V5/V5 FINAL Assembly _Report/Hinge.SLDASM

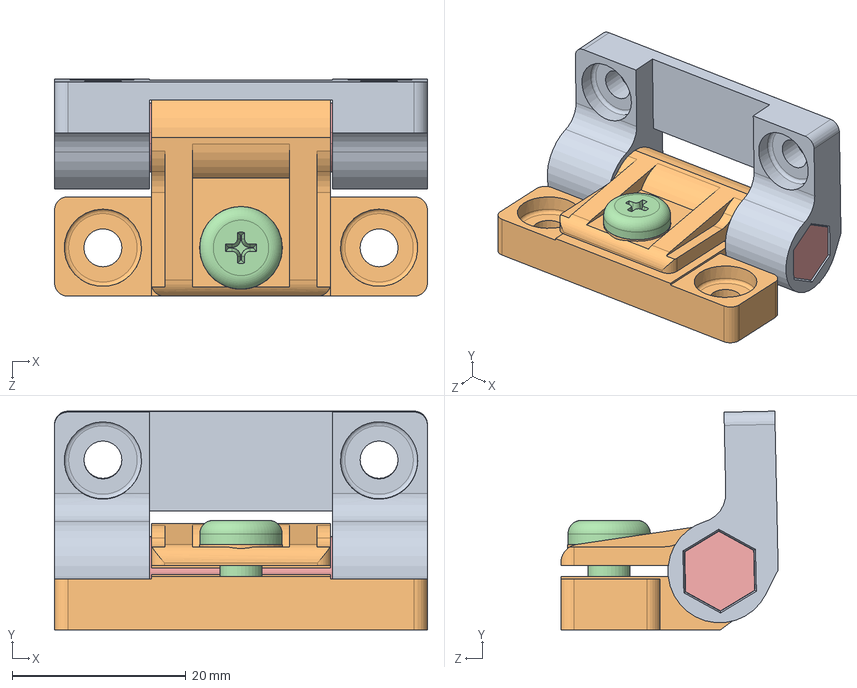
[picture p204: CAD file, 2018-04-01]
Documents/Capstone 2017-18/Engineering Drawings/V5/V5 FINAL Assembly _Report/Hinge.SLDASM
42.9 x 25.1 x 25.0 mm
DeleteFace7
E6_300_SERIES_ADJUSTMENT_NUT_FREE_RUNNING_CLF1-1-solid1
E6_STANDARD_PAN_HEAD_SCREW_CLF1-1-solid1
