cbkiyanda/AR/Documents/Capstone 2017-18/Engineering Drawings/V5/Top Cover V5.SLDPRT

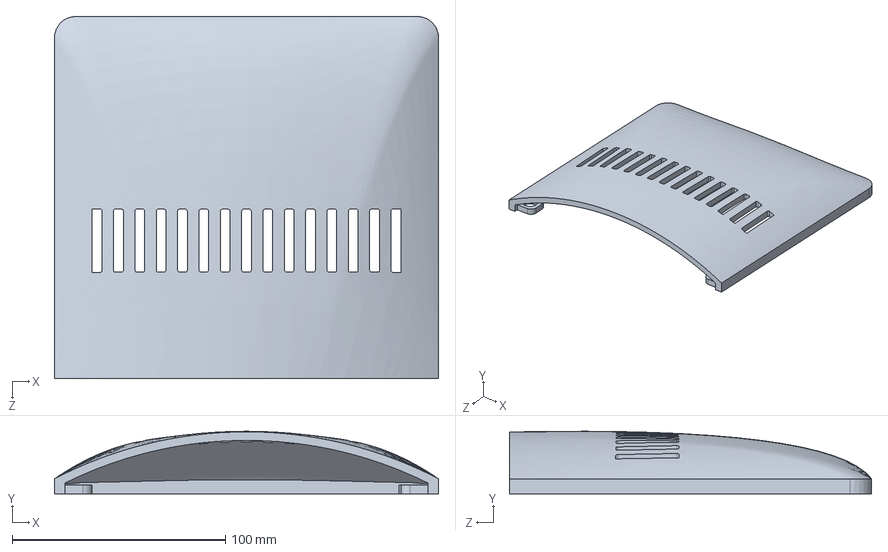
[picture p205: CAD file, 2018-04-01]
Documents/Capstone 2017-18/Engineering Drawings/V5/Top Cover V5.SLDPRT
180.0 x 29.3 x 169.6 mm
