cbkiyanda/AR/Documents/Capstone 2017-18/Engineering Drawings/V5/V5 FINAL Assembly _Report/Hinge components/Body1.sldprt

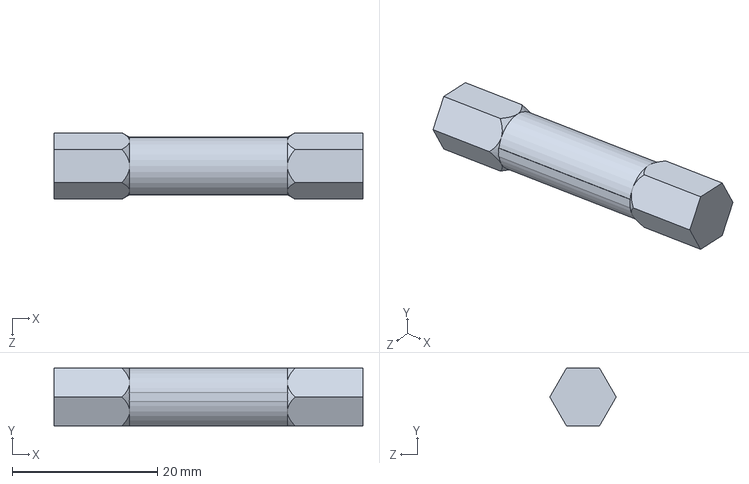
[picture p206: CAD file, 2018-04-01]
Documents/Capstone 2017-18/Engineering Drawings/V5/V5 FINAL Assembly _Report/Hinge components/Body1.sldprt
42.5 x 7.92 x 9.15 mm
