cbkiyanda/AR/Documents/Capstone 2017-18/Engineering Drawings/V5/HUD.SLDPRT

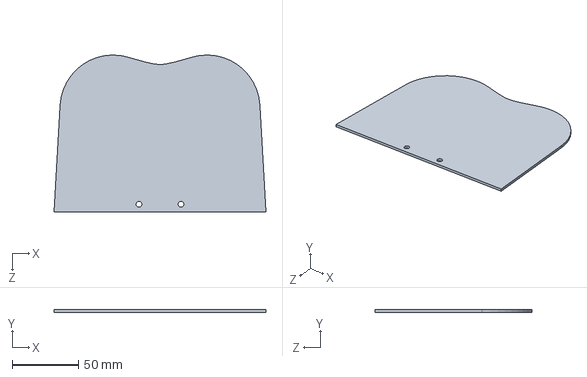
[picture p207: CAD file, 2018-04-01]
Documents/Capstone 2017-18/Engineering Drawings/V5/HUD.SLDPRT
160.0 x 2.00 x 118.5 mm
