cbkiyanda/AR/Documents/Capstone 2017-18/Engineering Drawings/V5/Headset V5.SLDPRT

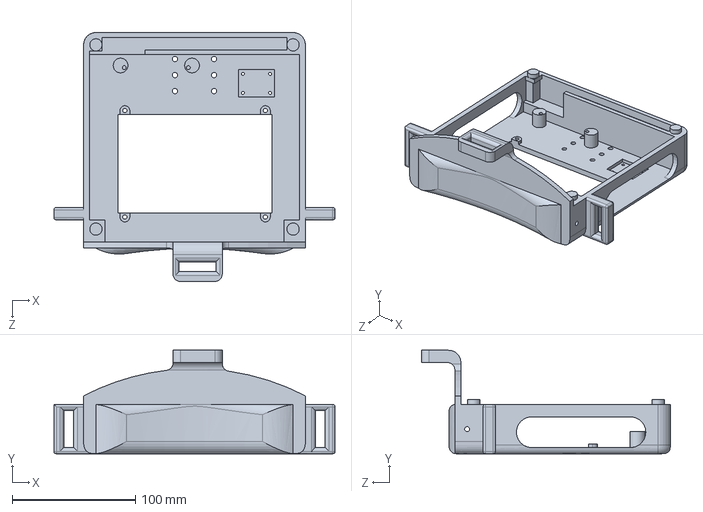
[picture p208: CAD file, 2018-04-01]
Documents/Capstone 2017-18/Engineering Drawings/V5/Headset V5.SLDPRT
228.0 x 84.0 x 202.0 mm
