cbkiyanda/AR/Documents/Capstone 2017-18/Engineering Drawings/V5/V5 FINAL Assembly _Report/11809301_Assembly V5.SLDASM

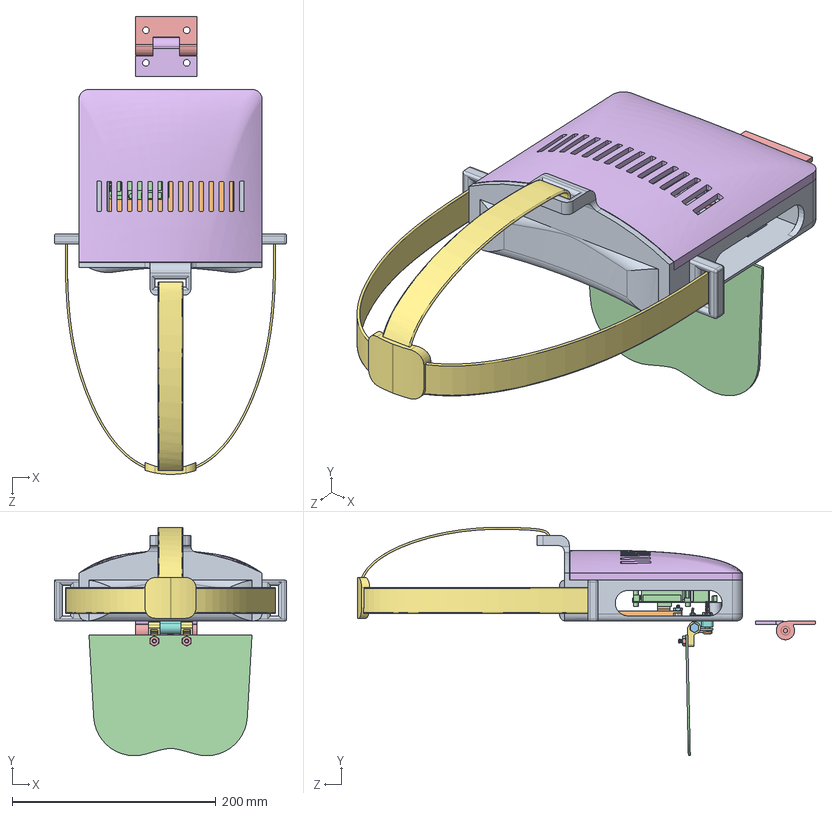
[picture p209: CAD file, 2018-04-01]
Documents/Capstone 2017-18/Engineering Drawings/V5/V5 FINAL Assembly _Report/11809301_Assembly V5.SLDASM
228.0 x 224.3 x 449.5 mm
Headset V5
Screen V4
Adafruit BNO055 motion sensor v2
Odroid XU4
Intel real sense camera R200
Top Cover V5
DeleteFace7
E6_300_SERIES_ADJUSTMENT_NUT_FREE_RUNNING_CLF1-1-solid1
E6_STANDARD_PAN_HEAD_SCREW_CLF1-1-solid1
HUD
90273A150_ZINC-PLATED STL FLAT HEAD PHIL MACHINE SCREW x 4
90480A007_LOW-STRENGTH STEEL HEX NUT (1) x 4
91771A742_18-8 SS FLAT HEAD PHILLIPS MACHINE SCREW x 2
90273A070_ZINC-PLATED STL FLAT HEAD PHIL MACHINE SCREW x 4
90480A003_LOW-STRENGTH STEEL HEX NUT x 4
90272A198_ZINC-PLTD STL PAN HEAD PHILLIPS MACHINE SCREW x 2
90480A009_LOW-STRENGTH STEEL HEX NUT x 4
90272A194_ZINC-PLTD STL PAN HEAD PHILLIPS MACHINE SCREW x 2
Head Strap
