cbkiyanda/AR/Documents/Capstone 2017-18/Engineering Drawings/V5/V5 FINAL Assembly _Report/11809011_Screen V4.SLDPRT

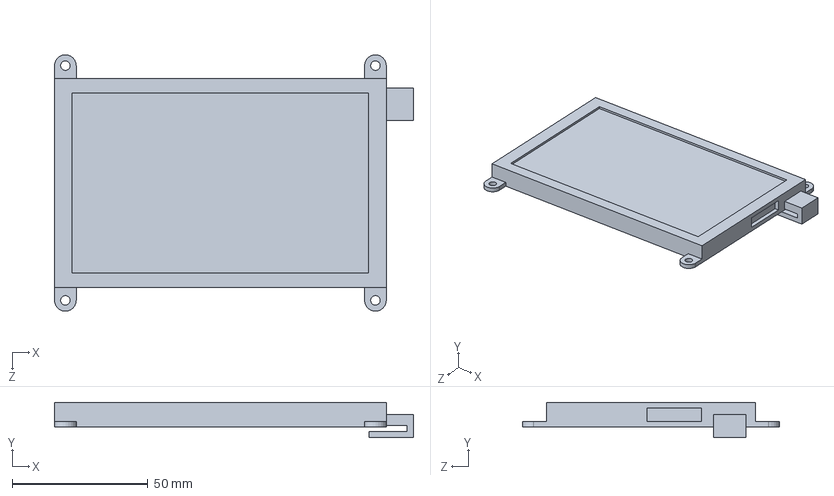
[picture p210: CAD file, 2018-04-01]
Documents/Capstone 2017-18/Engineering Drawings/V5/V5 FINAL Assembly _Report/11809011_Screen V4.SLDPRT
132.0 x 13.0 x 94.3 mm
