cbkiyanda/AR/Documents/Capstone 2017-18/Engineering Drawings/V5/V5 FINAL Assembly _Report/Fasteners/90273A150_ZINC-PLATED STL FLAT HEAD PHIL MACHINE SCREW.SLDPRT

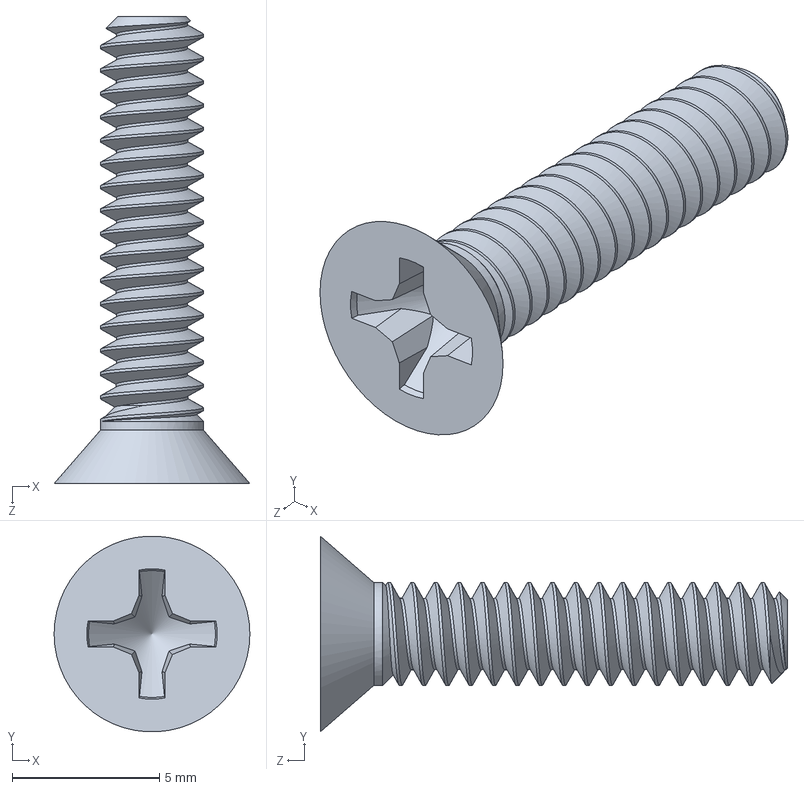
[picture p211: CAD file, 2018-04-01]
Documents/Capstone 2017-18/Engineering Drawings/V5/V5 FINAL Assembly _Report/Fasteners/90273A150_ZINC-PLATED STL FLAT HEAD PHIL MACHINE SCREW.SLDPRT
6.65 x 6.64 x 15.9 mm
