cbkiyanda/AR/Documents/Capstone 2017-18/Engineering Drawings/V5/V5 FINAL Assembly _Report/11809005_Head Strap V5.SLDPRT

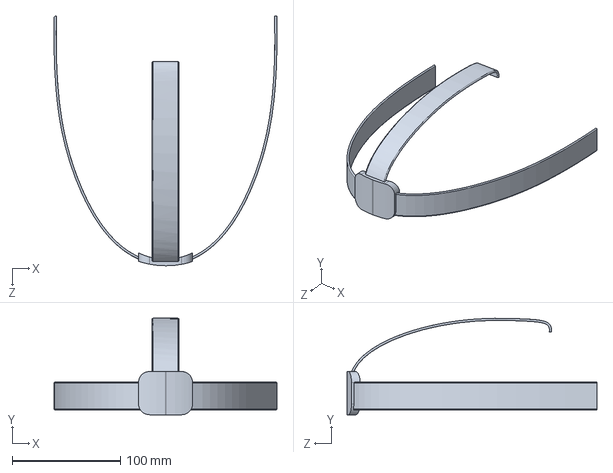
[picture p212: CAD file, 2018-04-01]
Documents/Capstone 2017-18/Engineering Drawings/V5/V5 FINAL Assembly _Report/11809005_Head Strap V5.SLDPRT
206.4 x 89.3 x 231.0 mm
