cbkiyanda/AR/Documents/Capstone 2017-18/Engineering Drawings/V5/V5 FINAL Assembly _Report/Fasteners/90272A198_ZINC-PLTD STL PAN HEAD PHILLIPS MACHINE SCREW.SLDPRT

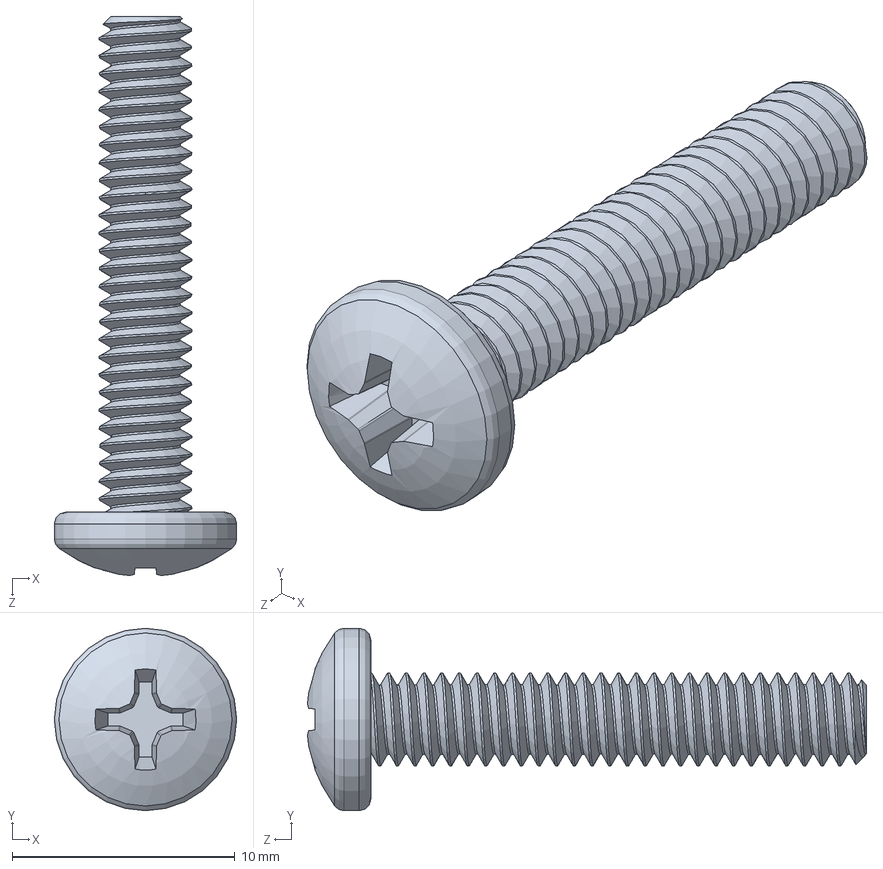
[picture p213: CAD file, 2018-04-01]
Documents/Capstone 2017-18/Engineering Drawings/V5/V5 FINAL Assembly _Report/Fasteners/90272A198_ZINC-PLTD STL PAN HEAD PHILLIPS MACHINE SCREW.SLDPRT
8.18 x 8.18 x 25.1 mm
