cbkiyanda/AR/Documents/Capstone 2017-18/Engineering Drawings/V5/V5 FINAL Assembly _Report/Fasteners/90480A003_LOW-STRENGTH STEEL HEX NUT.SLDPRT

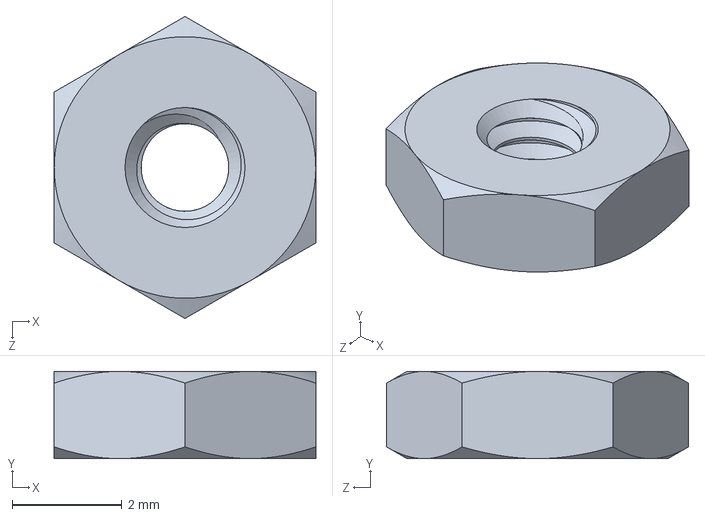
[picture p214: CAD file, 2018-04-01]
Documents/Capstone 2017-18/Engineering Drawings/V5/V5 FINAL Assembly _Report/Fasteners/90480A003_LOW-STRENGTH STEEL HEX NUT.SLDPRT
4.76 x 1.59 x 5.50 mm
