cbkiyanda/AR/(list of files, cad)

Other CAD files:
Documents/Capstone 2017-18/Engineering Drawings/V5/V5 FINAL Assembly _Report/Hinge components/Body5.sldprt
Documents/Capstone 2017-18/Engineering Drawings/V5/V5 FINAL Assembly _Report/Hinge components/DeleteFace7.sldprt
Documents/Capstone 2017-18/Engineering Drawings/V5/V5 FINAL Assembly _Report/Hinge components/E6_300_SERIES_ADJUSTMENT_NUT_FREE_RUNNING_CLF1-1-solid1.sldprt
Documents/Capstone 2017-18/Engineering Drawings/V5/V5 FINAL Assembly _Report/Hinge components/E6_STANDARD_PAN_HEAD_SCREW_CLF1-1-solid1.sldprt
Documents/Capstone 2017-18/Engineering Drawings/V5/V5 FINAL Assembly _Report/11809001_Headset V5.SLDPRT
Documents/Capstone 2017-18/Engineering Drawings/V5/V5 FINAL Assembly _Report/11809002_Top Cover V5.SLDPRT
Documents/Capstone 2017-18/Engineering Drawings/V1/STL/V1/Back Cover V2.SLDPRT
Documents/Capstone 2017-18/Engineering Drawings/V1/STL/V1/Back Cover V2.STL
Documents/Capstone 2017-18/Engineering Drawings/V1/STL/V1/Back piece.SLDPRT
Documents/Capstone 2017-18/Engineering Drawings/V1/STL/V1/Back piece.STL
Documents/Capstone 2017-18/Engineering Drawings/V1/STL/V1/Copy of Back Cover V2.STL
Documents/Capstone 2017-18/Engineering Drawings/V1/STL/V1/Headset.SLDPRT
Documents/Capstone 2017-18/Engineering Drawings/V1/STL/V1/Headset.STL
Documents/Capstone 2017-18/Engineering Drawings/V1/STL/V1/Top Cover V2.SLDPRT
Documents/Capstone 2017-18/Engineering Drawings/V1/STL/V1/Top Cover V2.STL
Documents/Capstone 2017-18/Engineering Drawings/V1/STL/V1/V1.2/Headset1.STL
Documents/Capstone 2017-18/Engineering Drawings/V1/STL/V1/V1.2/Headset2.STL
Documents/Capstone 2017-18/Engineering Drawings/V1/V0/AR_Headset_BottomPart.SLDPRT
Documents/Capstone 2017-18/Engineering Drawings/V1/V0/Amber tinted visor for the SIMPSON CARBON VUDO PRO HELMET.SLDPRT
Documents/Capstone 2017-18/Engineering Drawings/V1/V0/Headset bottom part v1 v1.step
Documents/Capstone 2017-18/Engineering Drawings/V1/V0/Intel real sense camera R200.SLDPRT
Documents/Capstone 2017-18/Engineering Drawings/V1/V0/Part1.SLDPRT
Documents/Capstone 2017-18/Engineering Drawings/V1/V0/Screen viewer.SLDPRT
Documents/Capstone 2017-18/Engineering Drawings/V1/V0/Screen.SLDPRT
Documents/Capstone 2017-18/Engineering Drawings/V1/V1.1/Adafruit BNO055 motion sensor.SLDPRT
Documents/Capstone 2017-18/Engineering Drawings/V1/V1.1/Back Cover.SLDPRT
Documents/Capstone 2017-18/Engineering Drawings/V1/V1.1/Back piece.SLDPRT
Documents/Capstone 2017-18/Engineering Drawings/V1/V1.1/DRAWINGS/Adafruit BNO055 motion sensor.SLDDRW
Documents/Capstone 2017-18/Engineering Drawings/V1/V1.1/DRAWINGS/Back Cover.SLDDRW
Documents/Capstone 2017-18/Engineering Drawings/V1/V1.1/DRAWINGS/Back piece.SLDDRW
Documents/Capstone 2017-18/Engineering Drawings/V1/V1.1/DRAWINGS/Headset Assembly.SLDDRW
Documents/Capstone 2017-18/Engineering Drawings/V1/V1.1/DRAWINGS/Headset.SLDDRW
Documents/Capstone 2017-18/Engineering Drawings/V1/V1.1/DRAWINGS/Intel real sense camera R200.SLDDRW
Documents/Capstone 2017-18/Engineering Drawings/V1/V1.1/DRAWINGS/Odroid XU4.SLDDRW
Documents/Capstone 2017-18/Engineering Drawings/V1/V1.1/DRAWINGS/Screen viewer.SLDDRW
Documents/Capstone 2017-18/Engineering Drawings/V1/V1.1/DRAWINGS/Screen.SLDDRW
Documents/Capstone 2017-18/Engineering Drawings/V1/V1.1/DRAWINGS/Top Cover.SLDDRW
Documents/Capstone 2017-18/Engineering Drawings/V1/V1.1/Headset Assembly.SLDASM
Documents/Capstone 2017-18/Engineering Drawings/V1/V1.1/Headset.SLDPRT
Documents/Capstone 2017-18/Engineering Drawings/V1/V1.1/Intel real sense camera R200.SLDPRT
Documents/Capstone 2017-18/Engineering Drawings/V1/V1.1/Odroid XU4.SLDPRT
Documents/Capstone 2017-18/Engineering Drawings/V1/V1.1/Screen viewer.SLDPRT
Documents/Capstone 2017-18/Engineering Drawings/V1/V1.1/Screen.SLDPRT
Documents/Capstone 2017-18/Engineering Drawings/V1/V1.1/Top Cover.SLDPRT
Documents/Capstone 2017-18/Engineering Drawings/V1/V1.3/Adafruit BNO055 motion sensor.SLDPRT
Documents/Capstone 2017-18/Engineering Drawings/V1/V1.3/Assembly V3.SLDASM
Documents/Capstone 2017-18/Engineering Drawings/V1/V1.3/Back Cover V2.SLDPRT
Documents/Capstone 2017-18/Engineering Drawings/V1/V1.3/Back piece.SLDPRT
Documents/Capstone 2017-18/Engineering Drawings/V1/V1.3/Drawings/Adafruit BNO055 motion sensor.SLDDRW
Documents/Capstone 2017-18/Engineering Drawings/V1/V1.3/Drawings/Assembly V3+BOM.SLDDRW
Documents/Capstone 2017-18/Engineering Drawings/V1/V1.3/Drawings/Assembly V3.SLDDRW
Documents/Capstone 2017-18/Engineering Drawings/V1/V1.3/Drawings/Back Cover V2.SLDDRW
Documents/Capstone 2017-18/Engineering Drawings/V1/V1.3/Drawings/Back piece.SLDDRW
Documents/Capstone 2017-18/Engineering Drawings/V1/V1.3/Drawings/Headset.SLDDRW
Documents/Capstone 2017-18/Engineering Drawings/V1/V1.3/Drawings/Intel real sense camera R200.SLDDRW
Documents/Capstone 2017-18/Engineering Drawings/V1/V1.3/Drawings/Odroid XU4.SLDDRW
Documents/Capstone 2017-18/Engineering Drawings/V1/V1.3/Drawings/Screen v2.SLDDRW
Documents/Capstone 2017-18/Engineering Drawings/V1/V1.3/Drawings/Screen viewer.SLDDRW
Documents/Capstone 2017-18/Engineering Drawings/V1/V1.3/Drawings/Strap v1.SLDDRW
Documents/Capstone 2017-18/Engineering Drawings/V1/V1.3/Drawings/Top Cover V3.SLDDRW
Documents/Capstone 2017-18/Engineering Drawings/V1/V1.3/Headset.SLDPRT
Documents/Capstone 2017-18/Engineering Drawings/V1/V1.3/Intel real sense camera R200.SLDPRT
Documents/Capstone 2017-18/Engineering Drawings/V1/V1.3/Odroid XU4.SLDPRT
Documents/Capstone 2017-18/Engineering Drawings/V1/V1.3/Screen v2.SLDPRT
Documents/Capstone 2017-18/Engineering Drawings/V1/V1.3/Screen viewer.SLDPRT
Documents/Capstone 2017-18/Engineering Drawings/V1/V1.3/Screen.SLDPRT
Documents/Capstone 2017-18/Engineering Drawings/V1/V1.3/Strap v1.SLDPRT
Documents/Capstone 2017-18/Engineering Drawings/V1/V1.3/Top Cover V3.SLDPRT
Documents/Capstone 2017-18/Engineering Drawings/V1/V1.3/Top Strap v1.SLDPRT
Documents/Capstone 2017-18/Engineering Drawings/V2/Adafruit BNO055 motion sensor v2.SLDPRT
Documents/Capstone 2017-18/Engineering Drawings/V2/AssemblyV2.SLDASM
Documents/Capstone 2017-18/Engineering Drawings/V2/Back Cover V2.SLDPRT
Documents/Capstone 2017-18/Engineering Drawings/V2/DRAWINGS (1)/Adafruit BNO055 motion sensor v2.SLDDRW
Documents/Capstone 2017-18/Engineering Drawings/V2/DRAWINGS (1)/Back Cover V2.SLDDRW
Documents/Capstone 2017-18/Engineering Drawings/V2/DRAWINGS (1)/Back piece.SLDDRW
Documents/Capstone 2017-18/Engineering Drawings/V2/DRAWINGS (1)/Headset V2.SLDDRW
Documents/Capstone 2017-18/Engineering Drawings/V2/DRAWINGS (1)/Intel real sense camera R200.SLDDRW
Documents/Capstone 2017-18/Engineering Drawings/V2/DRAWINGS (1)/Odroid XU4.SLDDRW
Documents/Capstone 2017-18/Engineering Drawings/V2/DRAWINGS (1)/Screen v3.SLDDRW
Documents/Capstone 2017-18/Engineering Drawings/V2/DRAWINGS (1)/Strap v1.SLDDRW
Documents/Capstone 2017-18/Engineering Drawings/V2/DRAWINGS (1)/Top Cover V2.SLDDRW
Documents/Capstone 2017-18/Engineering Drawings/V2/Headset V2.SLDPRT
Documents/Capstone 2017-18/Engineering Drawings/V2/STL/Back Cover V2.STL
Documents/Capstone 2017-18/Engineering Drawings/V2/STL/Headset V2.STL
Documents/Capstone 2017-18/Engineering Drawings/V2/STL/Top Cover V2.STL
Documents/Capstone 2017-18/Engineering Drawings/V2/Screen v3.SLDPRT
Documents/Capstone 2017-18/Engineering Drawings/V2/Top Cover V2.SLDPRT
Documents/Capstone 2017-18/Engineering Drawings/V3/Back Cover V3.SLDPRT
Documents/Capstone 2017-18/Engineering Drawings/V3/DRWS/Back Cover V3.SLDDRW
Documents/Capstone 2017-18/Engineering Drawings/V3/DRWS/FINAL DRAWINGS/Adafruit BNO055 motion sensor v2.SLDDRW
Documents/Capstone 2017-18/Engineering Drawings/V3/DRWS/FINAL DRAWINGS/Assembly (balloon + BOM) V3.SLDDRW
Documents/Capstone 2017-18/Engineering Drawings/V3/DRWS/FINAL DRAWINGS/Assembly V3.SLDDRW
Documents/Capstone 2017-18/Engineering Drawings/V3/DRWS/FINAL DRAWINGS/Back Cover V3.SLDDRW
Documents/Capstone 2017-18/Engineering Drawings/V3/DRWS/FINAL DRAWINGS/Back piece.SLDDRW
Documents/Capstone 2017-18/Engineering Drawings/V3/DRWS/FINAL DRAWINGS/Headset V3.SLDDRW
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
