cbkiyanda/AR/Documents/Capstone 2017-18/Experiment Videos and Pictures/Steady Force Test/Setup2.jpg

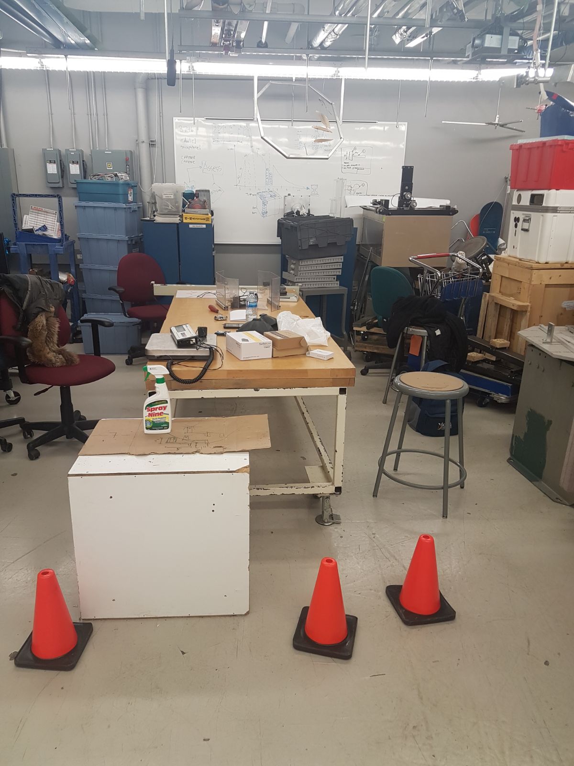
Documents/Capstone 2017-18/Experiment Videos and Pictures/Steady Force Test/Setup2.jpg
