cbkiyanda/AR/Documents/Capstone 2017-18/Experiment Videos and Pictures/Vibration Test/V4_12Hz_post-test.jpg

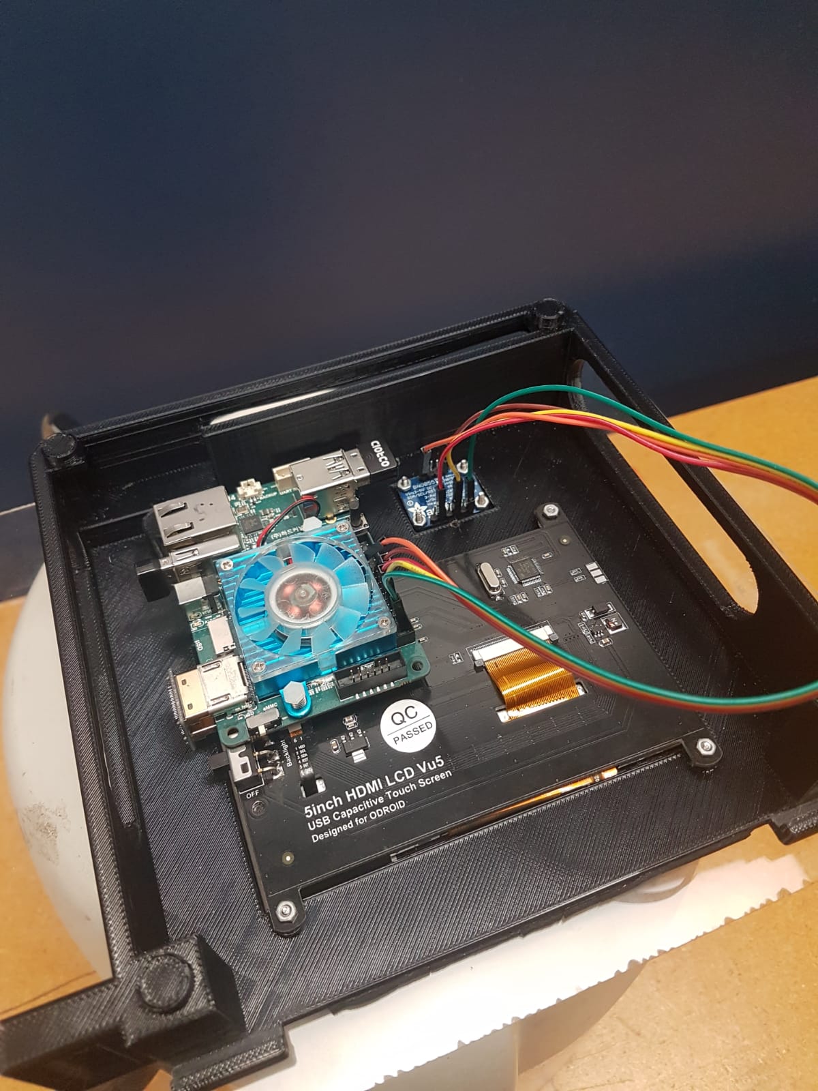
Documents/Capstone 2017-18/Experiment Videos and Pictures/Vibration Test/V4_12Hz_post-test.jpg
