cbkiyanda/AR/Documents/Capstone 2017-18/Final Report/Engineering Drawings.pdf

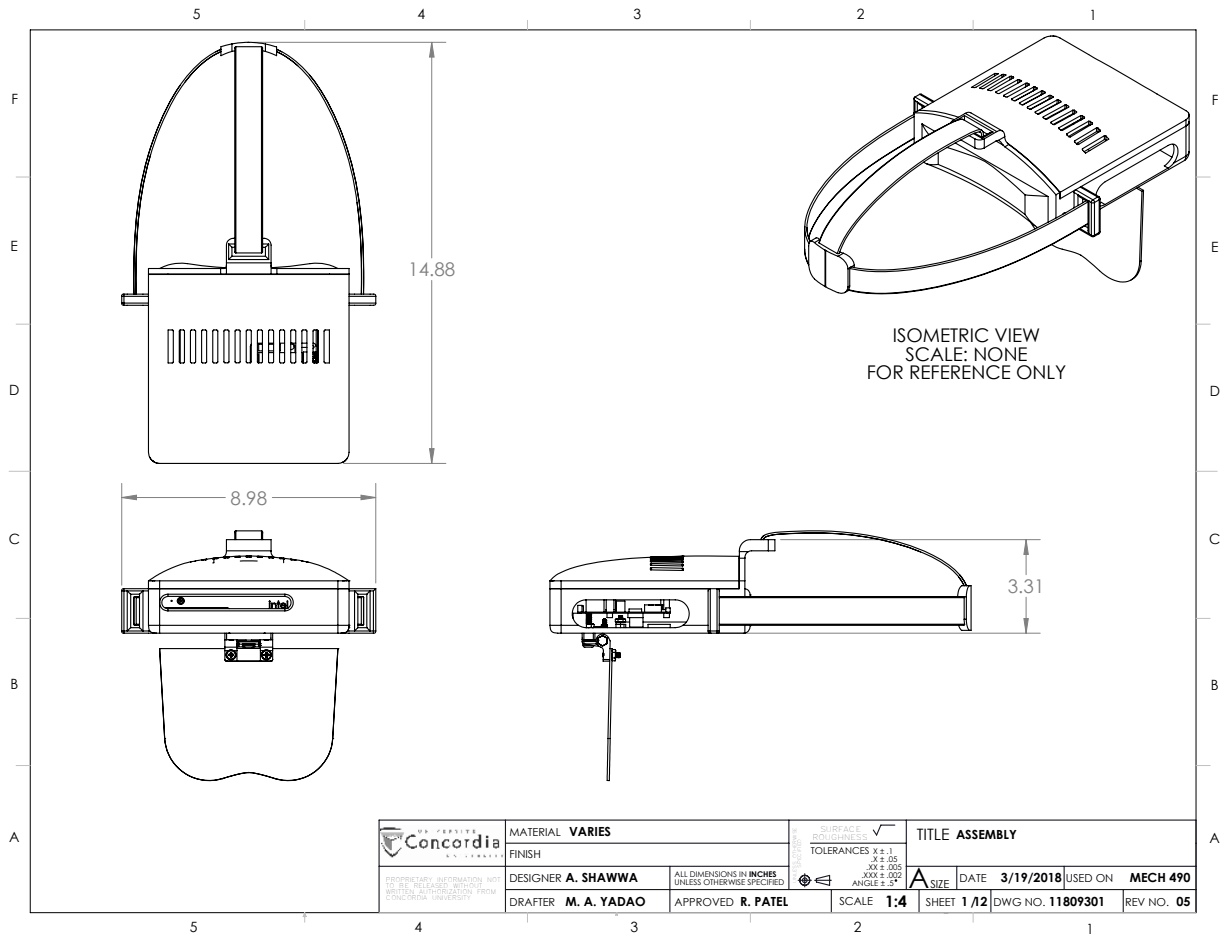
[picture p262: page 1]
M. A. YADAO; R. PATEL; PROPRIETARY INFORMATION NOT; A. SHAWWA TO BE RELEASED WITHOUT; VARIES; UNLESS OTHERWISE; SPECIFIED; SURFACE ROUGHNESS; DWG NO.; FINISH; ASIZE; TOLERANCES X ± .1 .X ± .05 .XX ± .005 .XXX ± .002 ANGLE ± .5; DRAFTER; APPROVED; SCALE 1:4; ASSEMBLY; SHEET 1 /12; REV NO.; DATE 3/19/2018; MATERIAL; DESIGNER; TITLE

ISOMETRIC VIEW
SCALE: NONE
FOR REFERENCE ONLY

ALL DIMENSIONS IN INCHES
UNLESS OTHERWISE SPECIFIED

USED ON MECH 490

WRITTEN AUTHORIZATION FROM
CONCORDIA UNIVERSITY

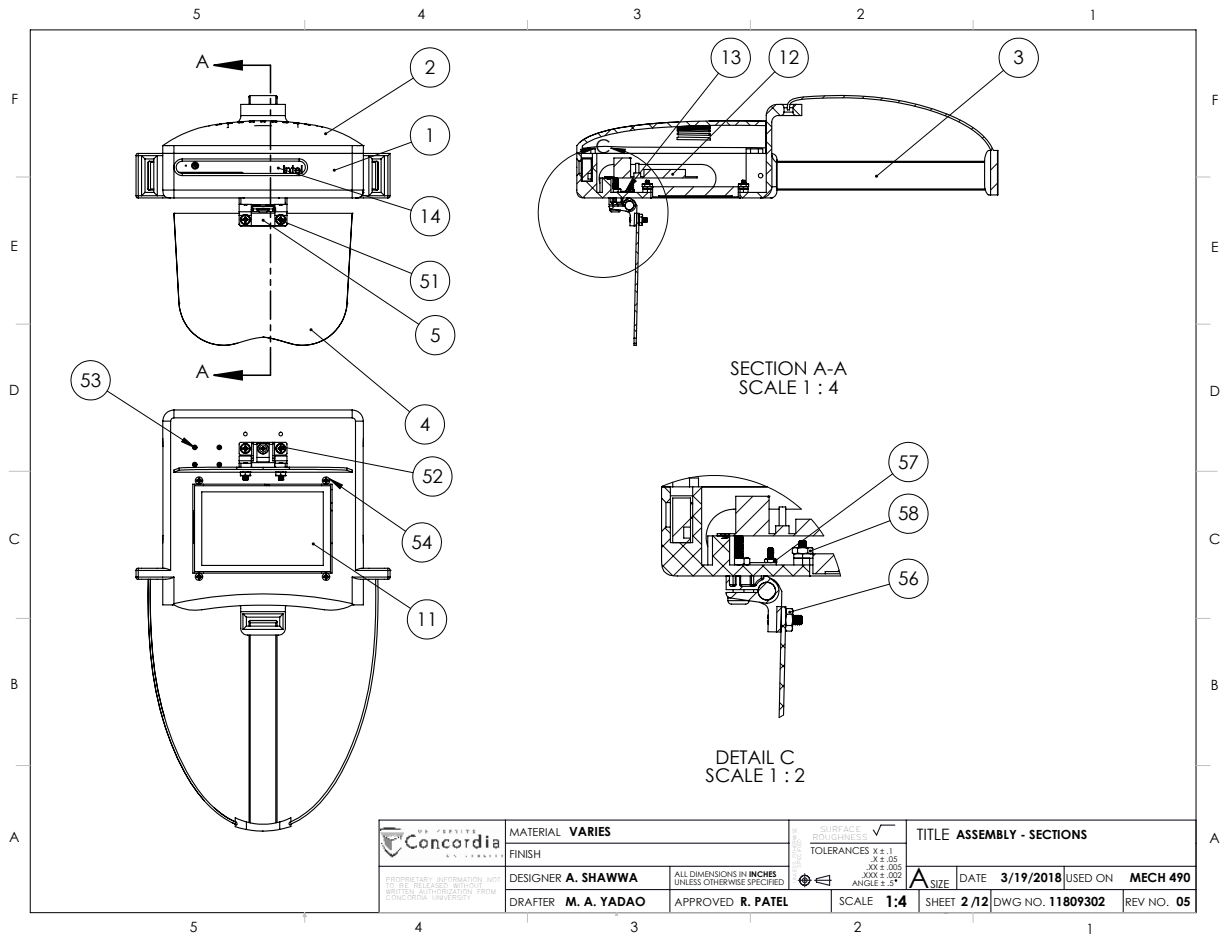
[picture p263: page 2]
SECTION A-A SCALE 1 : 4; DETAIL C SCALE 1 : 2; M. A. YADAO; R. PATEL; PROPRIETARY INFORMATION NOT; A. SHAWWA TO BE RELEASED WITHOUT; VARIES; UNLESS OTHERWISE; SPECIFIED; SURFACE ROUGHNESS; FINISH; ASIZE; TOLERANCES X ± .1 .X ± .05 .XX ± .005 .XXX ± .002; ASSEMBLY - SECTIONS; SHEET 2 /12; REV NO.; DATE 3/19/2018; MATERIAL; TITLE

ALL DIMENSIONS IN INCHES

USED ON MECH 490

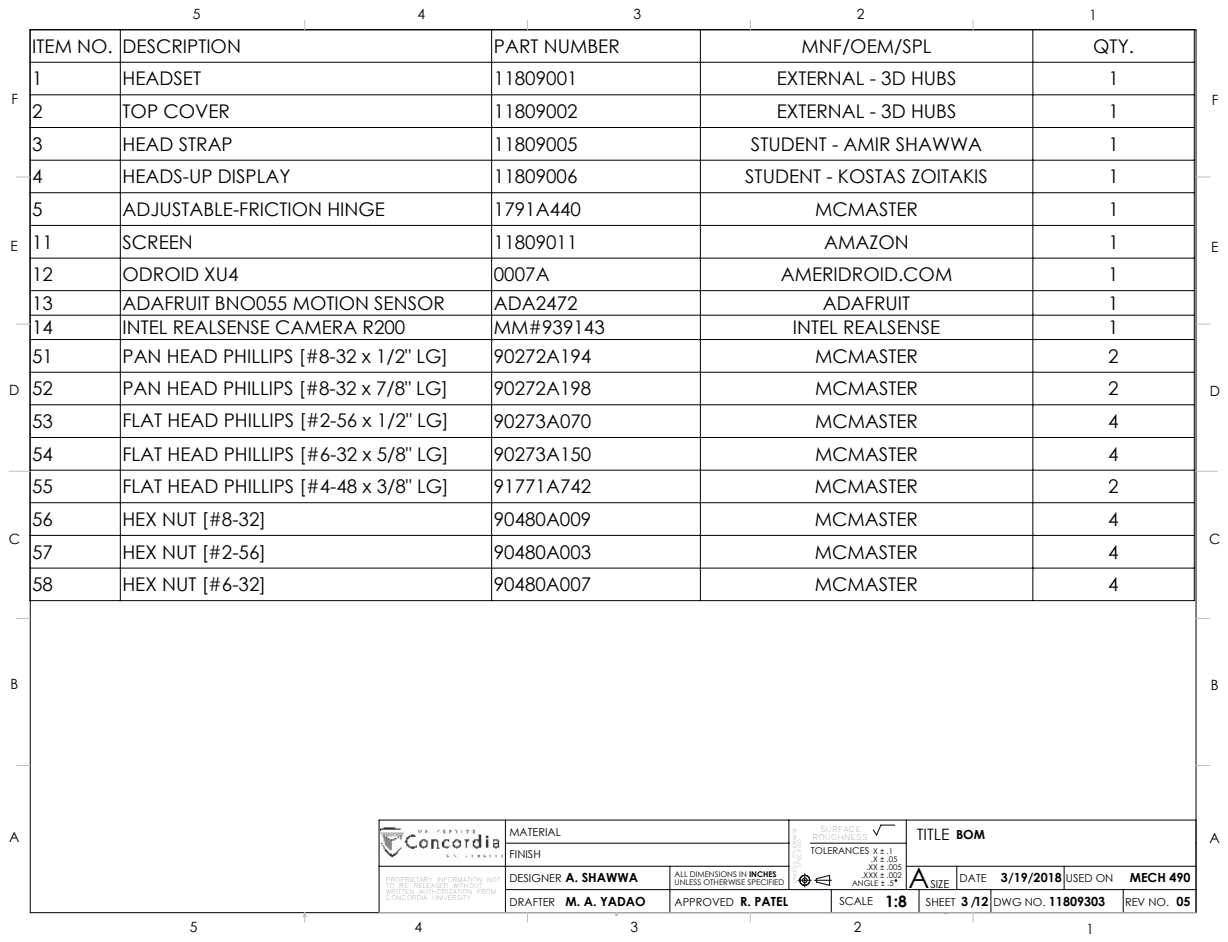
[picture p264: page 3]
M. A. YADAO; R. PATEL; PROPRIETARY INFORMATION NOT; A. SHAWWA TO BE RELEASED WITHOUT; UNLESS OTHERWISE; SPECIFIED; SURFACE ROUGHNESS; FINISH; ASIZE; TOLERANCES X ± .1 .X ± .05 .XX ± .005 .XXX ± .002; BOM; SHEET 3 /12; REV NO.; DATE 3/19/2018; MATERIAL; TITLE

ITEM NO. | DESCRIPTION | PART NUMBER | MNF/OEM/SPL | QTY.
1 | HEADSET | 11809001 | EXTERNAL - 3D HUBS | 1
2 | TOP COVER | 11809002 | EXTERNAL - 3D HUBS | 1
3 | HEAD STRAP | 11809005 | STUDENT - AMIR SHAWWA | 1
4 | HEADS-UP DISPLAY | 11809006 | STUDENT - KOSTAS ZOITAKIS | 1
5 | ADJUSTABLE-FRICTION HINGE | 1791A440 | MCMASTER | 1
11 | SCREEN | 11809011 | AMAZON | 1
12 | ODROID XU4 | 0007A | AMERIDROID.COM | 1
13 | ADAFRUIT BNO055 MOTION SENSOR | ADA2472 | ADAFRUIT | 1
14 | INTEL REALSENSE CAMERA R200 | MM#939143 | INTEL REALSENSE | 1
51 | PAN HEAD PHILLIPS [#8-32 x 1/2" LG] | 90272A194 | MCMASTER | 2
52 | PAN HEAD PHILLIPS [#8-32 x 7/8" LG] | 90272A198 | MCMASTER | 2
53 | FLAT HEAD PHILLIPS [#2-56 x 1/2" LG] | 90273A070 | MCMASTER | 4
54 | FLAT HEAD PHILLIPS [#6-32 x 5/8" LG] | 90273A150 | MCMASTER | 4
55 | FLAT HEAD PHILLIPS [#4-48 x 3/8" LG] | 91771A742 | MCMASTER | 2
56 | HEX NUT [#8-32] | 90480A009 | MCMASTER | 4
57 | HEX NUT [#2-56] | 90480A003 | MCMASTER | 4
58 | HEX NUT [#6-32] | 90480A007 | MCMASTER | 4

ALL DIMENSIONS IN INCHES

USED ON MECH 490

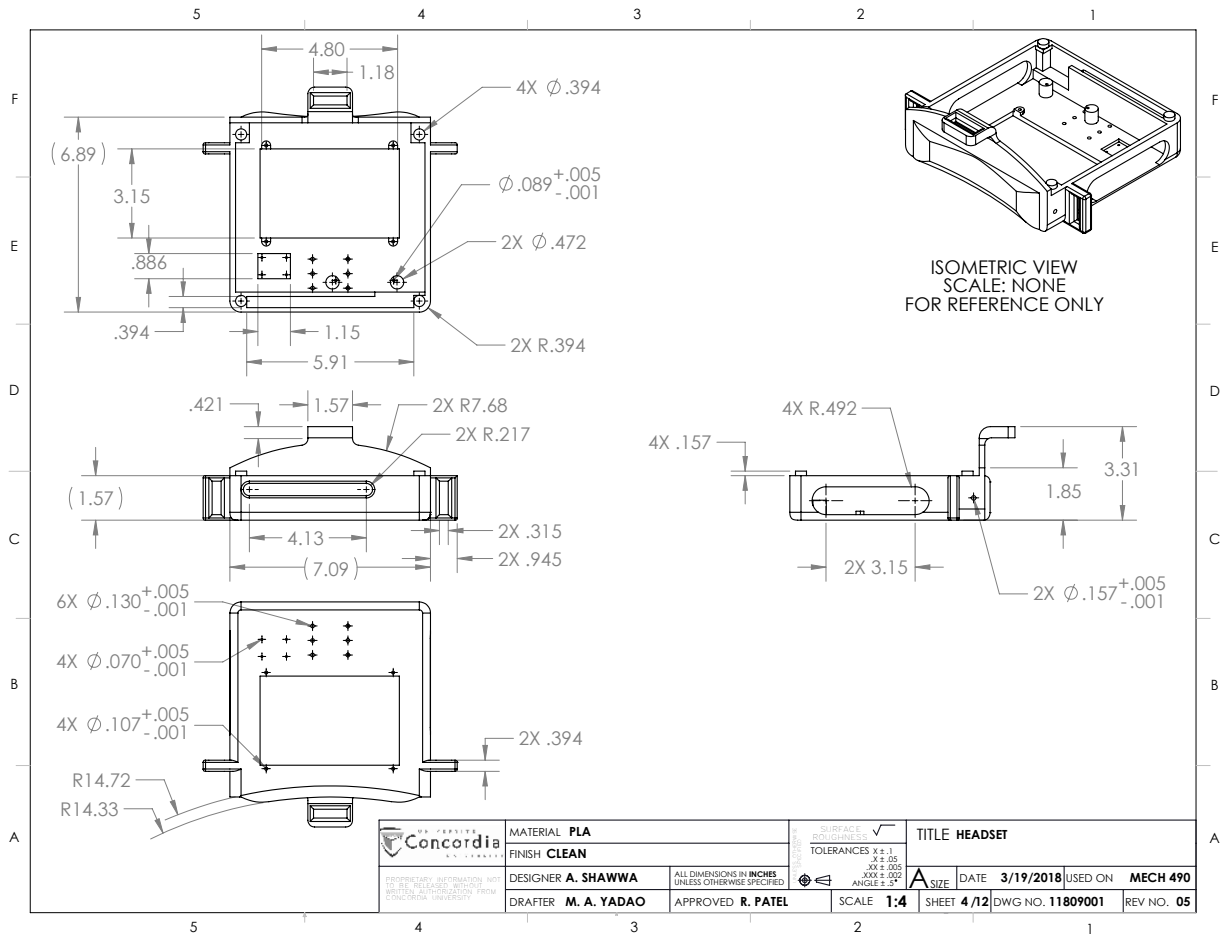
[picture p265: page 4]
M. A. YADAO; R. PATEL; PROPRIETARY INFORMATION NOT; A. SHAWWA TO BE RELEASED WITHOUT; CLEAN; PLA; UNLESS OTHERWISE; SPECIFIED; SURFACE ROUGHNESS; FINISH; ASIZE; TOLERANCES X ± .1 .X ± .05 .XX ± .005 .XXX ± .002; HEADSET; SHEET 4 /12; REV NO.; DATE 3/19/2018; MATERIAL; TITLE

ISOMETRIC VIEW
SCALE: NONE
FOR REFERENCE ONLY

ALL DIMENSIONS IN INCHES

USED ON MECH 490

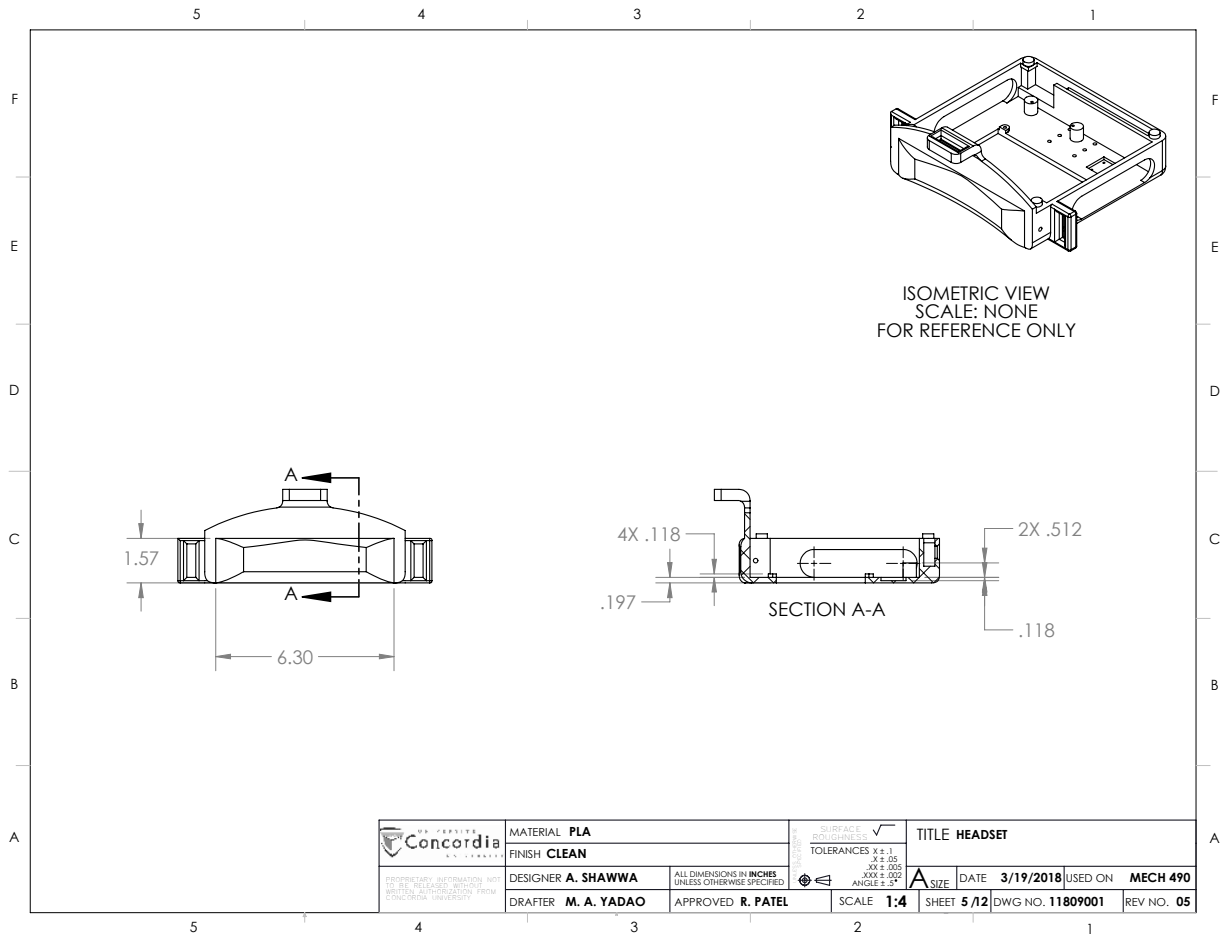
[picture p266: page 5]
SECTION A-A; M. A. YADAO; R. PATEL; PROPRIETARY INFORMATION NOT; A. SHAWWA TO BE RELEASED WITHOUT; CLEAN; PLA; UNLESS OTHERWISE; SPECIFIED; SURFACE ROUGHNESS; FINISH; ASIZE; TOLERANCES X ± .1 .X ± .05 .XX ± .005 .XXX ± .002; HEADSET; SHEET 5 /12; REV NO.; DATE 3/19/2018; MATERIAL; TITLE

ISOMETRIC VIEW
SCALE: NONE
FOR REFERENCE ONLY

ALL DIMENSIONS IN INCHES

USED ON MECH 490

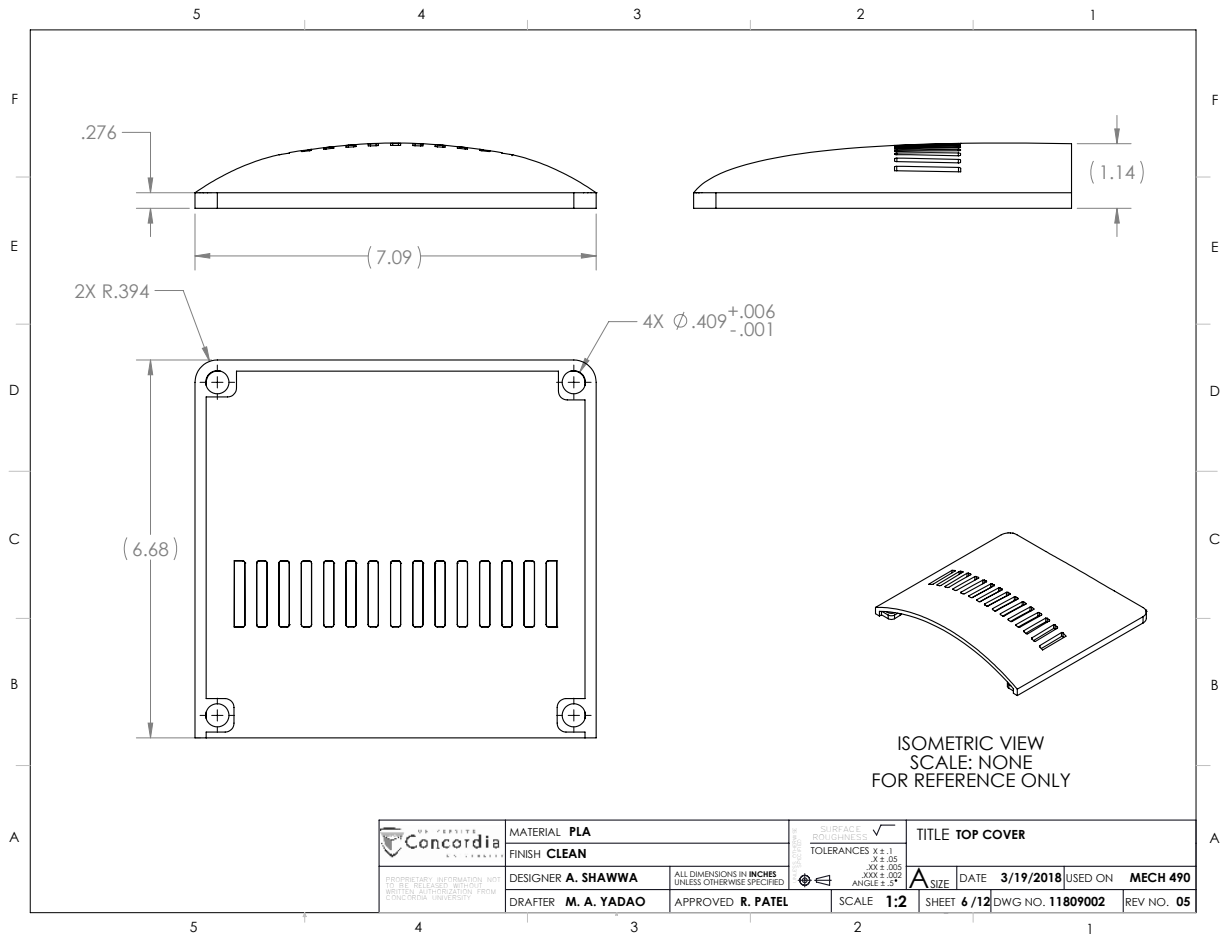
[picture p267: page 6]
M. A. YADAO; R. PATEL; PROPRIETARY INFORMATION NOT; A. SHAWWA TO BE RELEASED WITHOUT; CLEAN; PLA; UNLESS OTHERWISE; SPECIFIED; SURFACE ROUGHNESS; FINISH; ASIZE; TOLERANCES X ± .1 .X ± .05 .XX ± .005 .XXX ± .002; TOP COVER; SHEET 6 / 12; REV NO.; DATE 3/19/2018; MATERIAL; TITLE

ISOMETRIC VIEW
SCALE: NONE
FOR REFERENCE ONLY

ALL DIMENSIONS IN INCHES

USED ON MECH 490

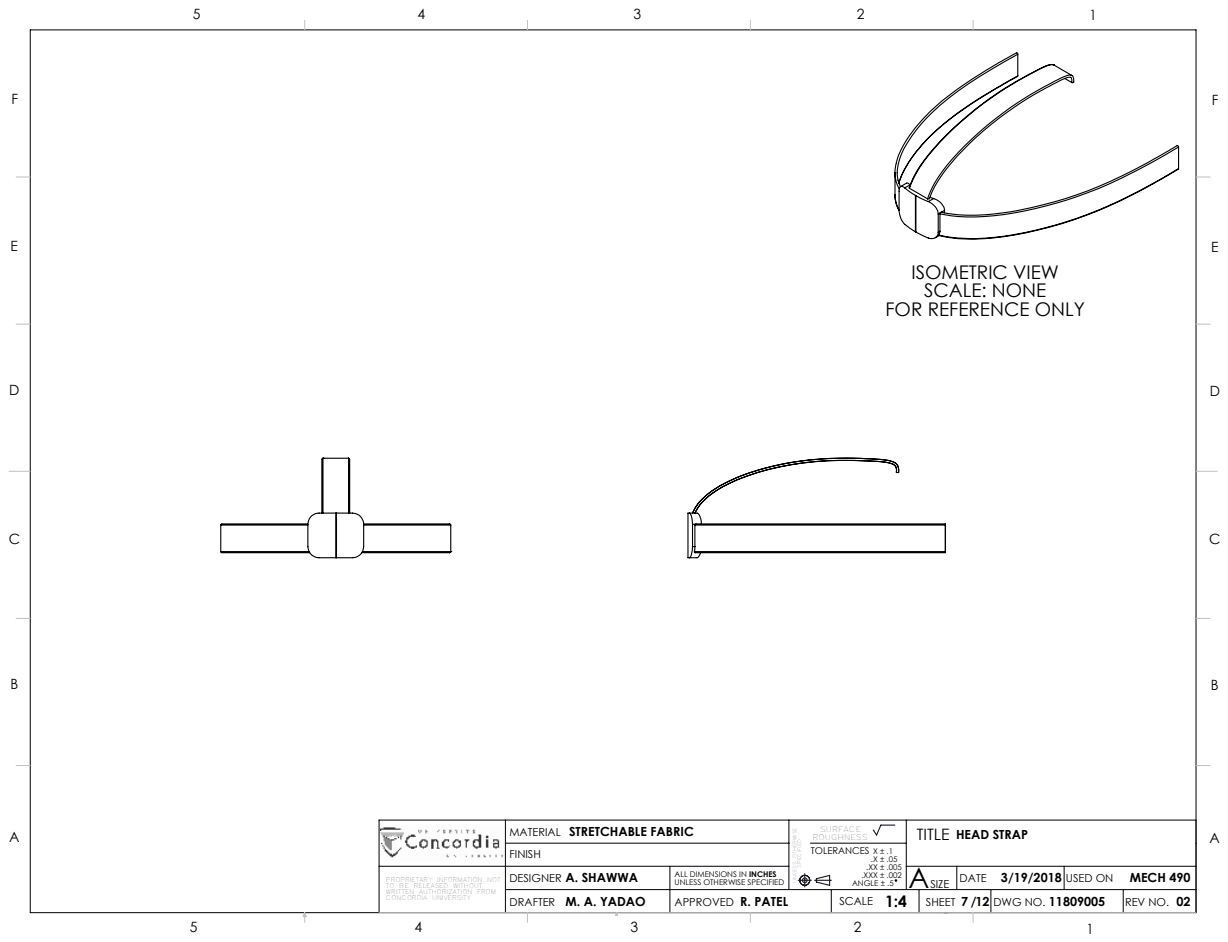
[picture p268: page 7]
M. A. YADAO; R. PATEL; PROPRIETARY INFORMATION NOT; A. SHAWWA TO BE RELEASED WITHOUT; STRETCHABLE FABRIC; UNLESS OTHERWISE; SPECIFIED; SURFACE ROUGHNESS; FINISH; ASIZE; TOLERANCES X ± .1 .X ± .05 .XX ± .005 .XXX ± .002; HEAD STRAP; SHEET 7 /12; REV NO.; DATE 3/19/2018; MATERIAL; TITLE

ISOMETRIC VIEW
SCALE: NONE
FOR REFERENCE ONLY

ALL DIMENSIONS IN INCHES

USED ON MECH 490

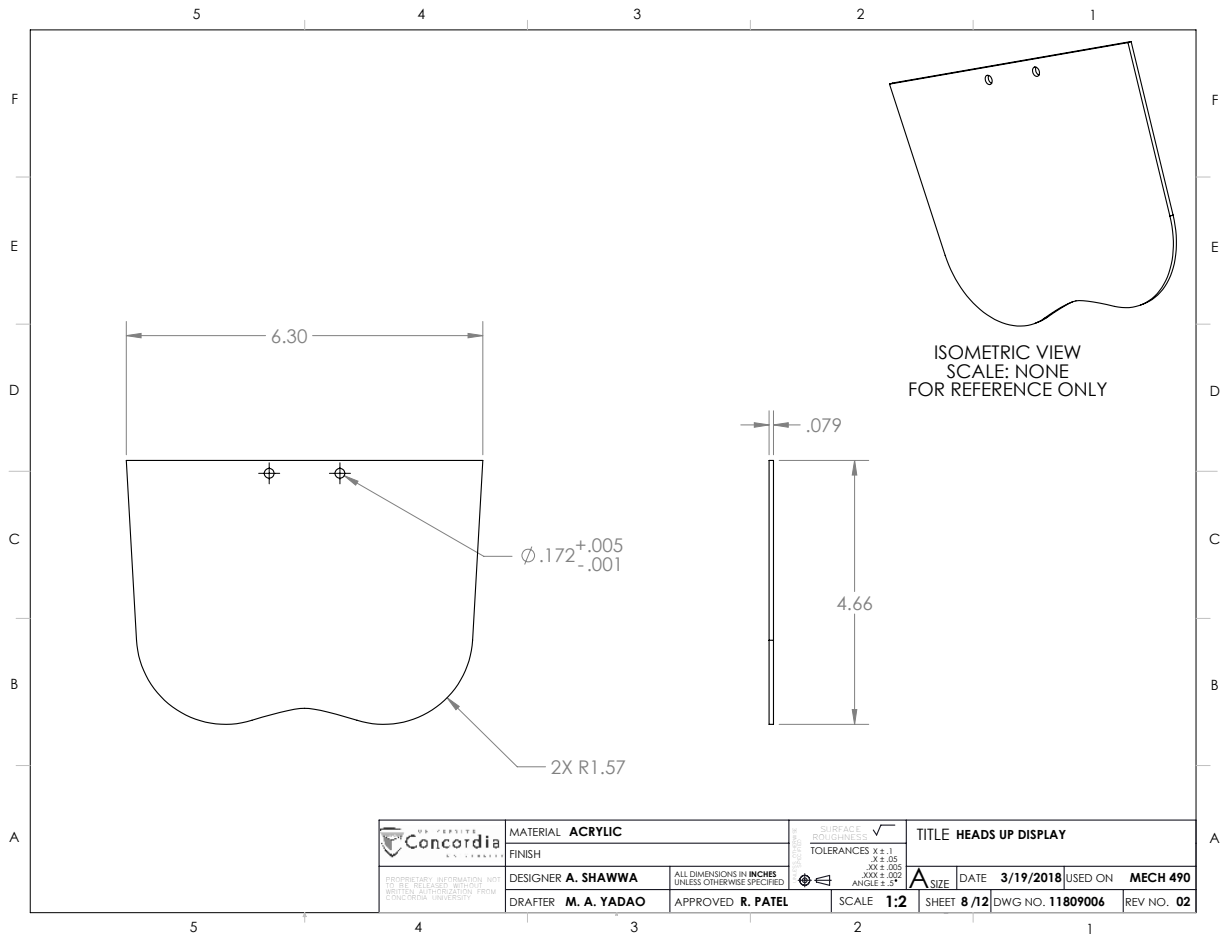
[picture p269: page 8]
M. A. YADAO; R. PATEL; PROPRIETARY INFORMATION NOT; A. SHAWWA TO BE RELEASED WITHOUT; ACRYLIC; UNLESS OTHERWISE; SPECIFIED; SURFACE ROUGHNESS; FINISH; ASIZE; TOLERANCES X ± .1 .X ± .05 .XX ± .005 .XXX ± .002; SHEET 8 /12; REV NO.; DATE 3/19/2018; MATERIAL

ISOMETRIC VIEW
SCALE: NONE
FOR REFERENCE ONLY

TITLE
HEADS UP DISPLAY

ALL DIMENSIONS IN INCHES

USED ON MECH 490

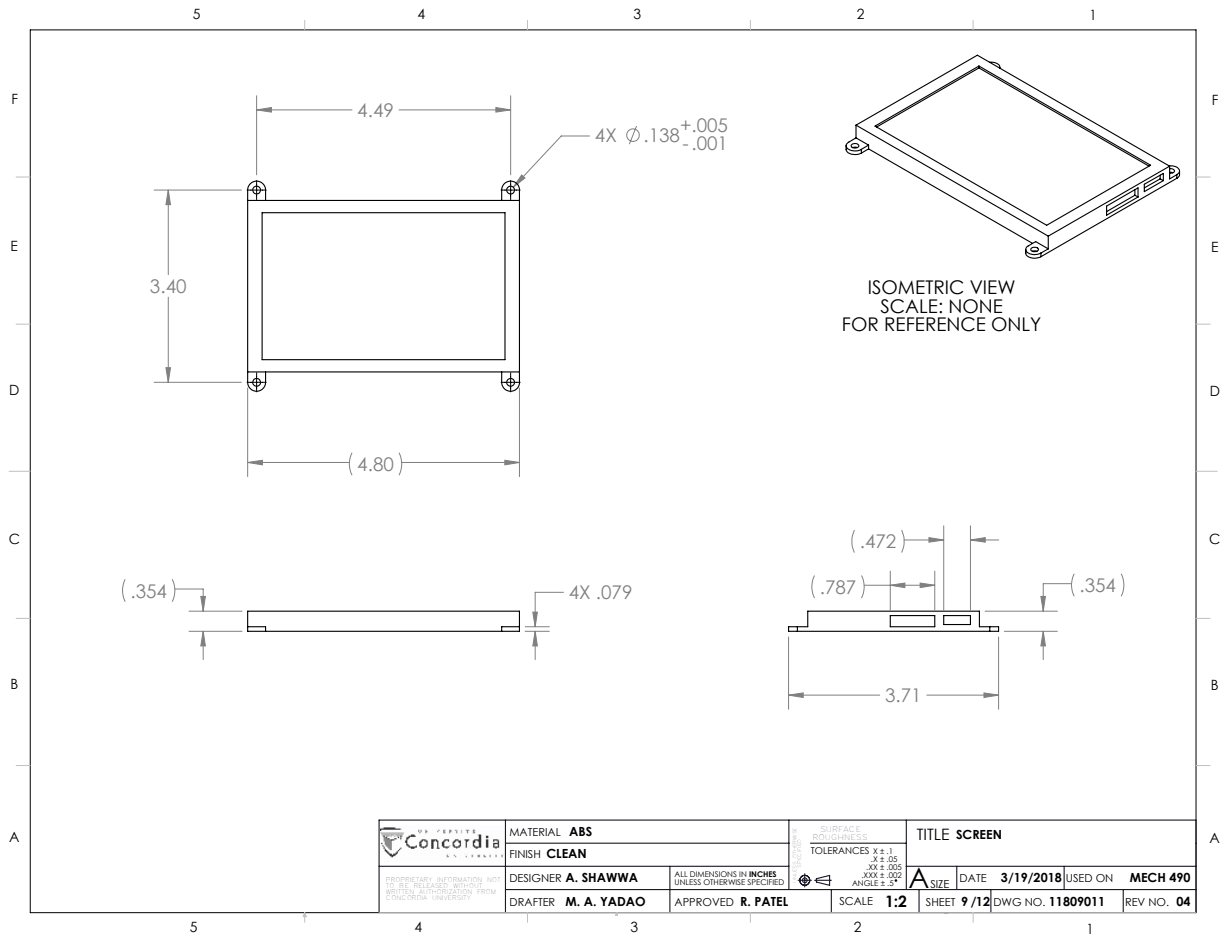
[picture p270: page 9]
M. A. YADAO; R. PATEL; PROPRIETARY INFORMATION NOT; A. SHAWWA TO BE RELEASED WITHOUT; CLEAN; ABS; UNLESS OTHERWISE; SPECIFIED; SURFACE ROUGHNESS; FINISH; ASIZE; TOLERANCES X ± .1 .X ± .05 .XX ± .005 .XXX ± .002; SCREEN; SHEET 9 /12; REV NO.; DATE 3/19/2018; MATERIAL; TITLE

ISOMETRIC VIEW
SCALE: NONE
FOR REFERENCE ONLY

ALL DIMENSIONS IN INCHES

USED ON MECH 490

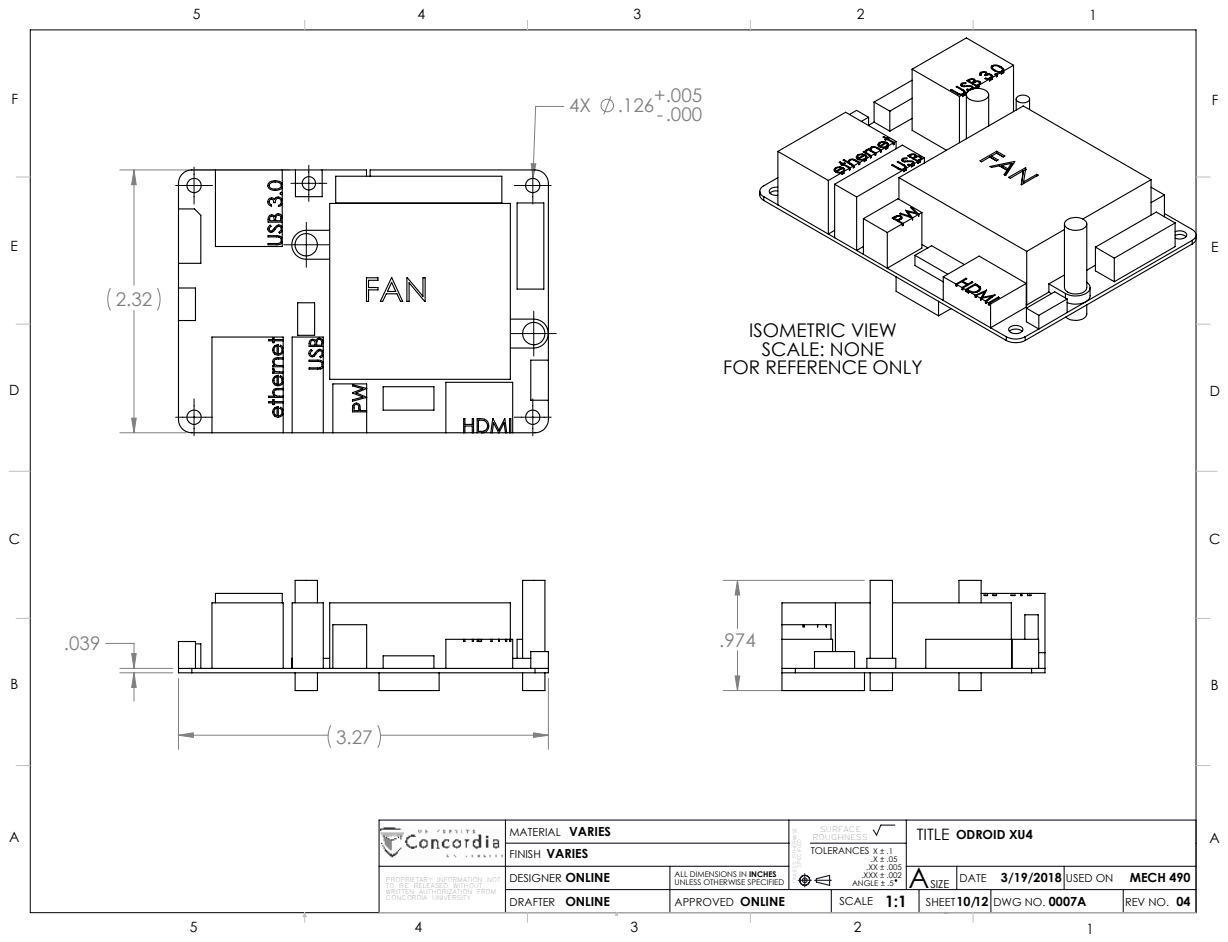
[picture p271: page 10]
ONLINE; PROPRIETARY INFORMATION NOT; ONLINE TO BE RELEASED WITHOUT; VARIES; UNLESS OTHERWISE; SPECIFIED; SURFACE ROUGHNESS; FINISH; ASIZE; TOLERANCES X ± .1 .X ± .05 .XX ± .005 .XXX ± .002; ODROID XU4; SHEET10/12; REV NO.; DATE 3/19/2018; MATERIAL; TITLE

ISOMETRIC VIEW
SCALE: NONE
FOR REFERENCE ONLY

ALL DIMENSIONS IN INCHES

USED ON MECH 490

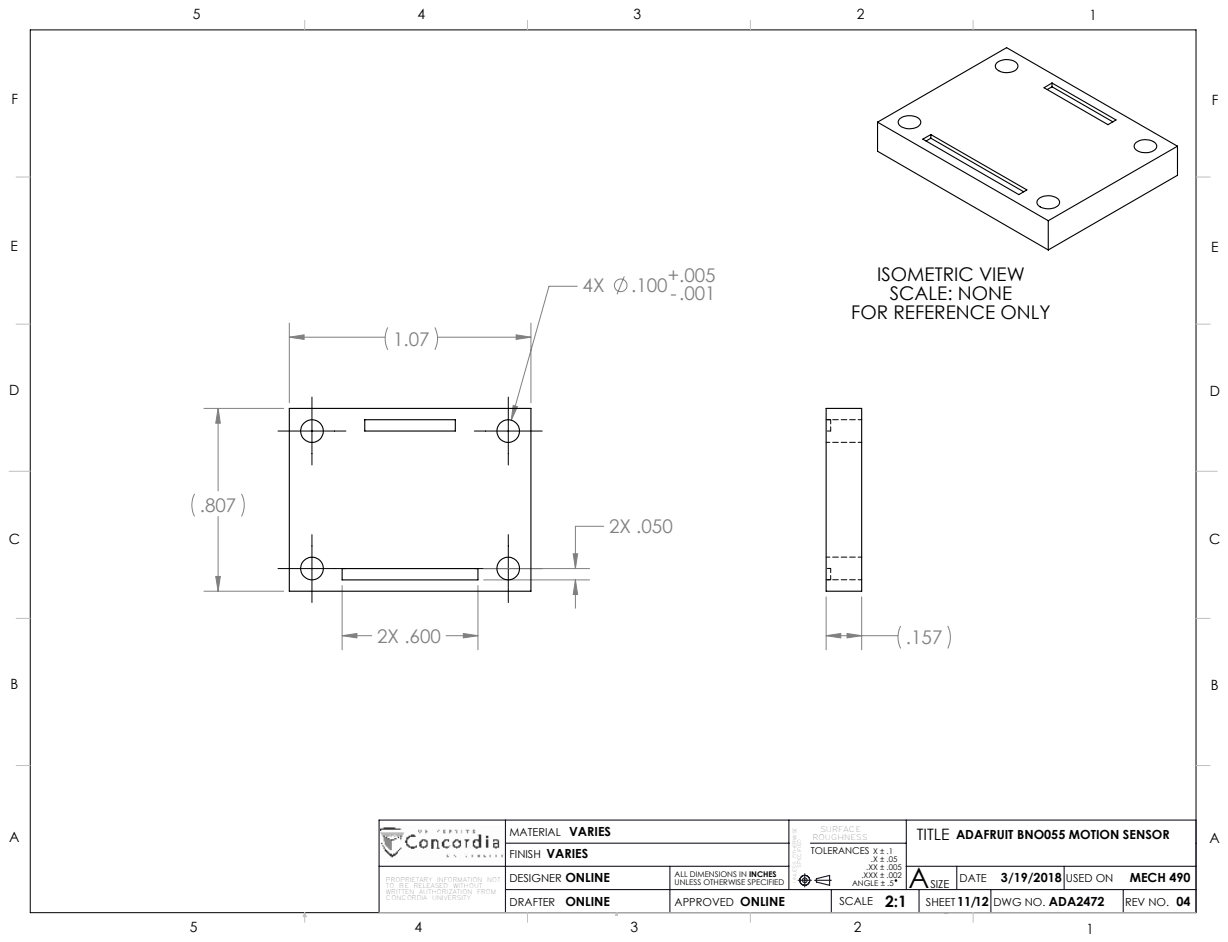
[picture p272: page 11]
ONLINE; ADA2472; PROPRIETARY INFORMATION NOT; ONLINE TO BE RELEASED WITHOUT; VARIES; UNLESS OTHERWISE; SPECIFIED; SURFACE ROUGHNESS; FINISH; ASIZE; TOLERANCES X ± .1 .X ± .05 .XX ± .005 .XXX ± .002; DRAFTER; APPROVED; SCALE 2:1; SHEET 11/12; REV NO.; DATE 3/19/2018; MATERIAL

ISOMETRIC VIEW
SCALE: NONE
FOR REFERENCE ONLY

TITLE
ADAFRUIT BNO055 MOTION SENSOR

ALL DIMENSIONS IN INCHES

USED ON MECH 490

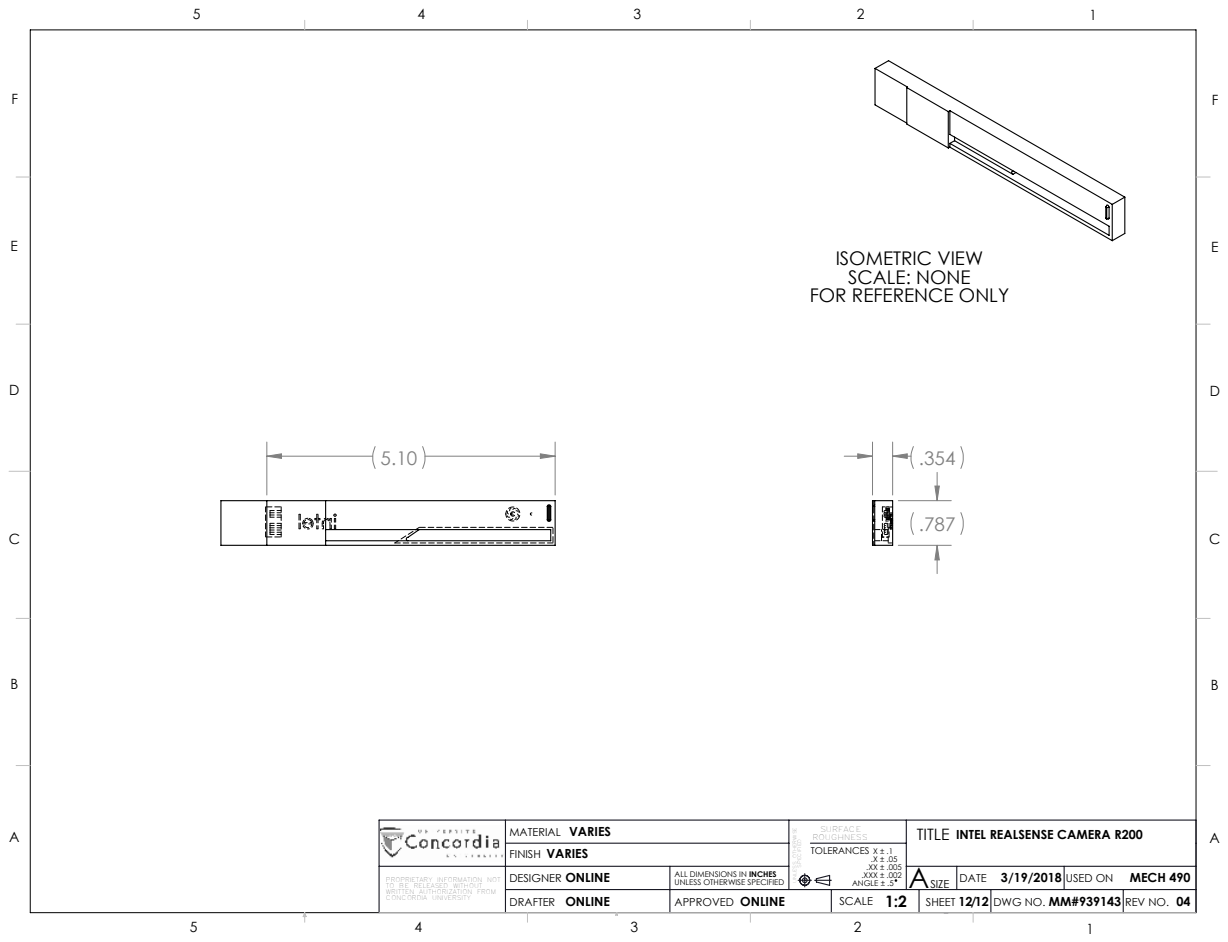
[picture p273: page 12]
ONLINE; PROPRIETARY INFORMATION NOT; ONLINE TO BE RELEASED WITHOUT; VARIES; UNLESS OTHERWISE; SPECIFIED; SURFACE ROUGHNESS; FINISH; ASIZE; TOLERANCES X ± .1 .X ± .05 .XX ± .005 .XXX ± .002; SHEET 12/12; REV NO.; DATE 3/19/2018; MATERIAL

ISOMETRIC VIEW
SCALE: NONE
FOR REFERENCE ONLY

TITLE
INTEL REALSENSE CAMERA R200

ALL DIMENSIONS IN INCHES

USED ON MECH 490

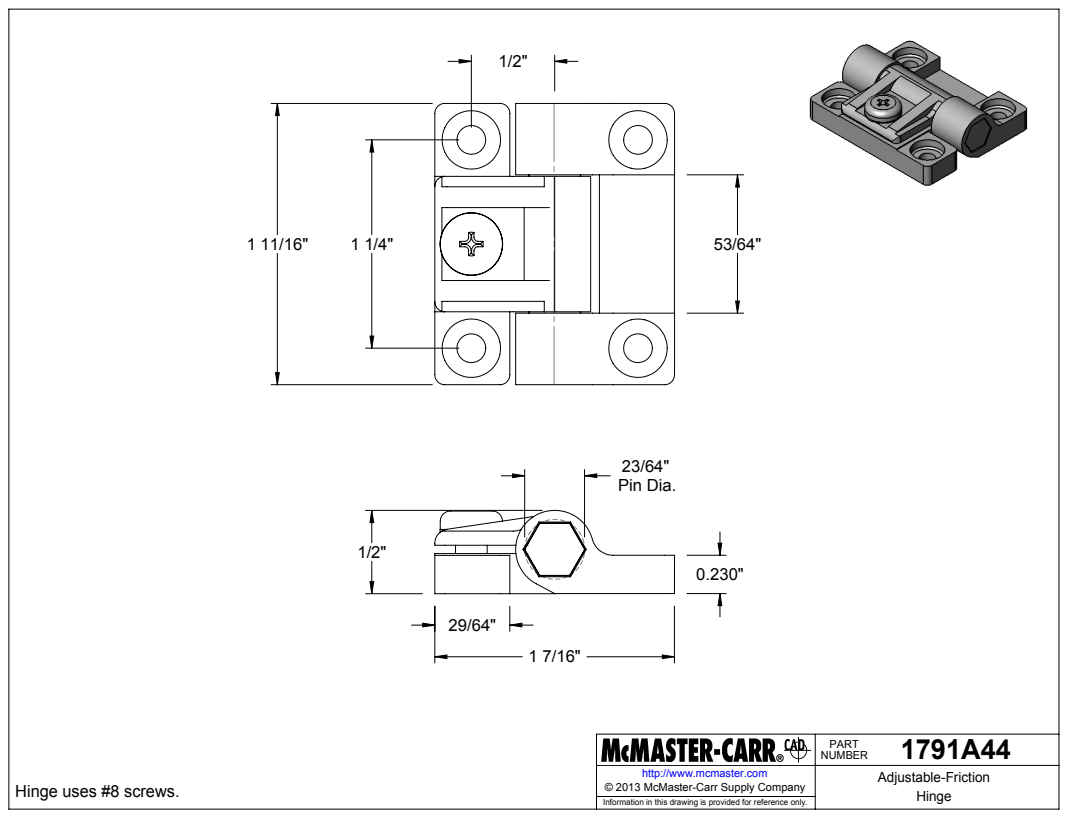
[picture p274: page 13]
23/64" Pin Dia.; Hinge uses #8 screws.; Hinge © 2013 McMaster-Carr Supply Company

1791A44 PART NUMBER

http://www.mcmaster.com | Adjustable-Friction

Information in this drawing is provided for reference only.

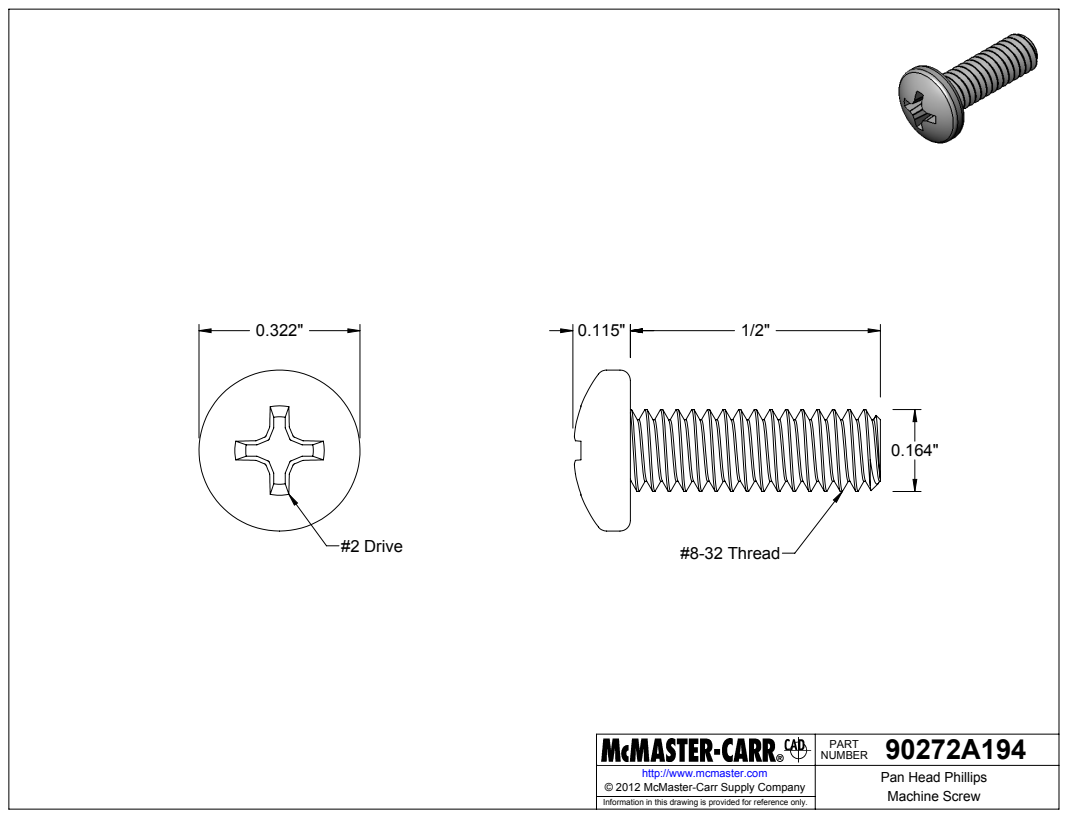
[picture p275: page 14]
#2 Drive; #8-32 Thread

90272A194 PART NUMBER

Pan Head Phillips Machine Screw © 2012 McMaster-Carr Supply Company

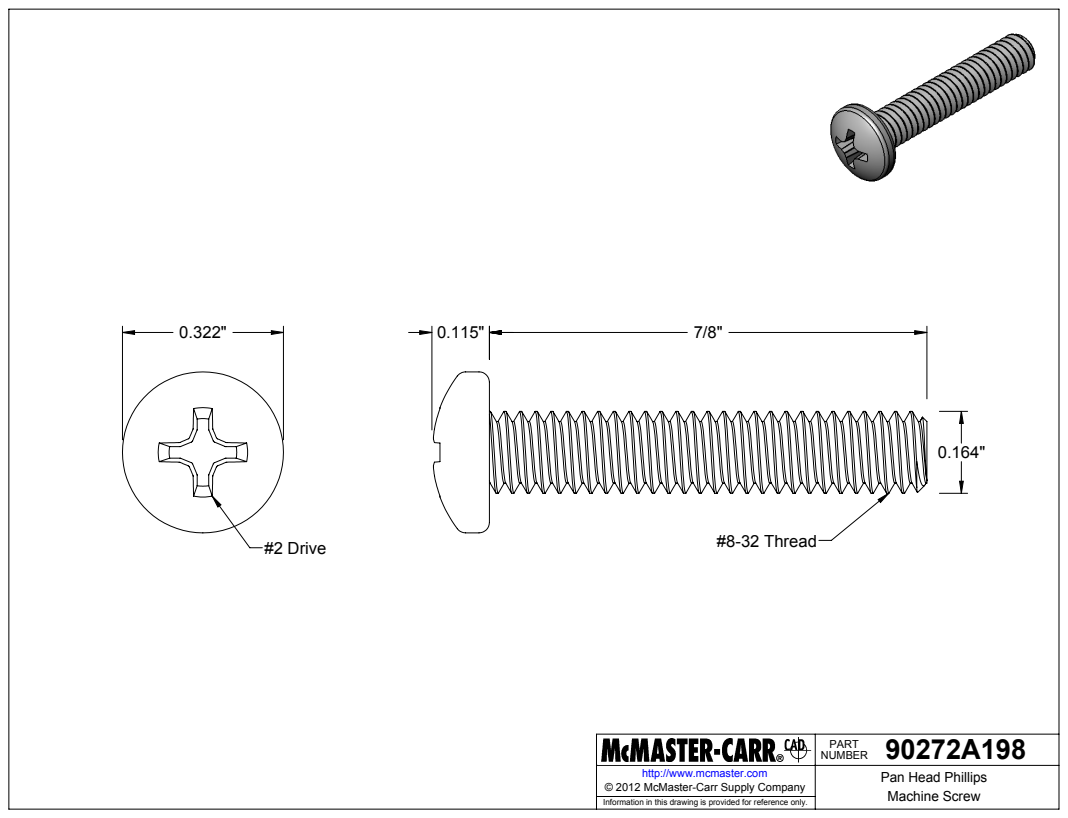
[picture p276: page 15]
#2 Drive; #8-32 Thread

90272A198 PART NUMBER

Pan Head Phillips Machine Screw © 2012 McMaster-Carr Supply Company

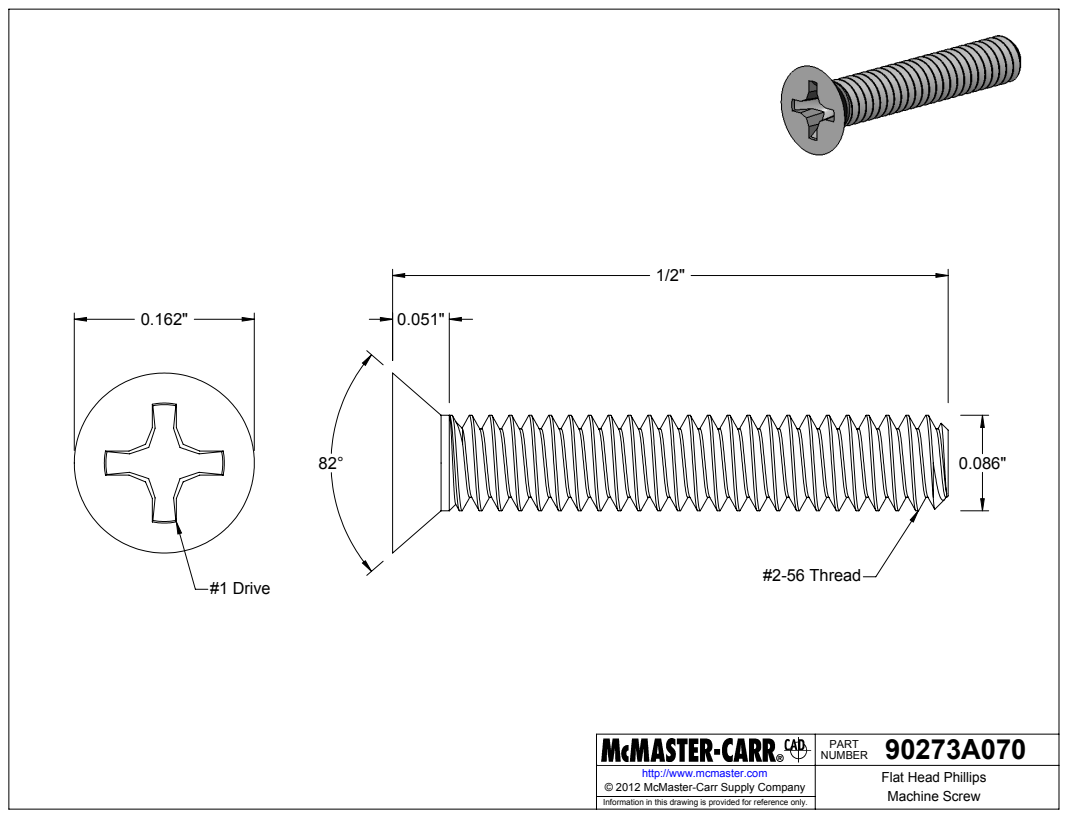
[picture p277: page 16]
#2-56 Thread; #1 Drive

90273A070 PART NUMBER

Flat Head Phillips Machine Screw © 2012 McMaster-Carr Supply Company

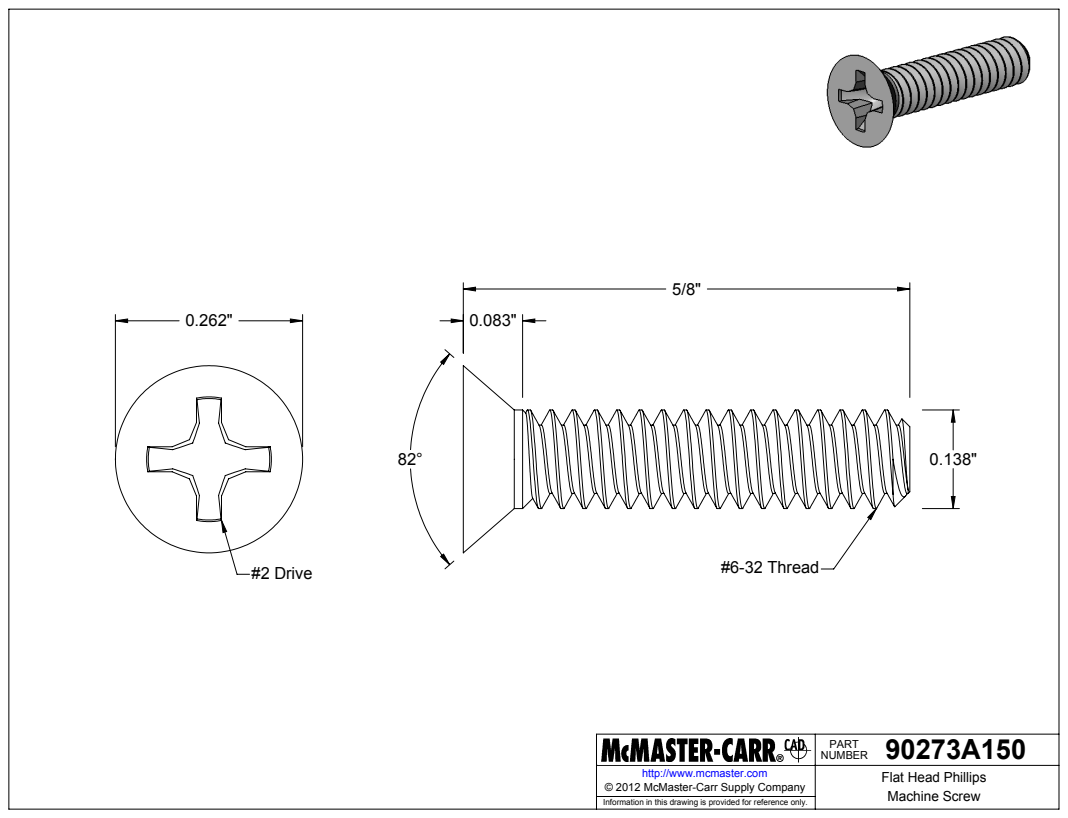
[picture p278: page 17]
#6-32 Thread; #2 Drive

90273A150 PART NUMBER

Flat Head Phillips Machine Screw © 2012 McMaster-Carr Supply Company

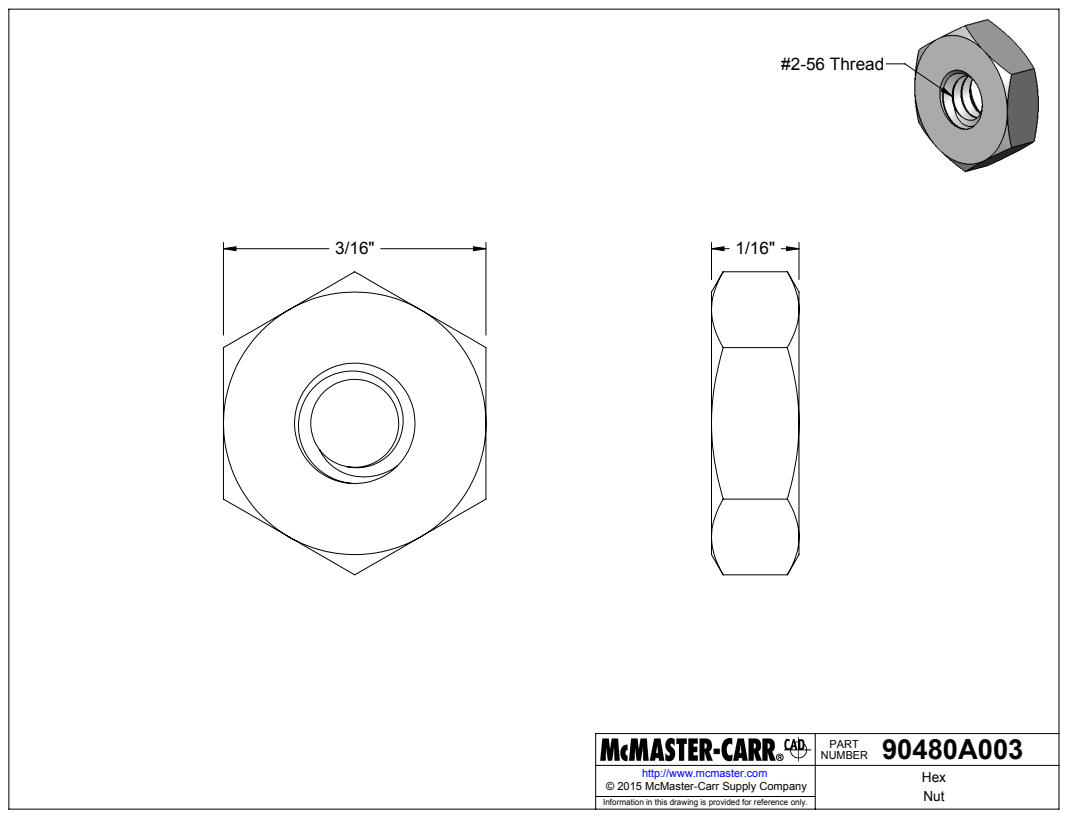
[picture p279: page 18]
#2-56 Thread

90480A003 PART NUMBER

Hex Nut © 2015 McMaster-Carr Supply Company

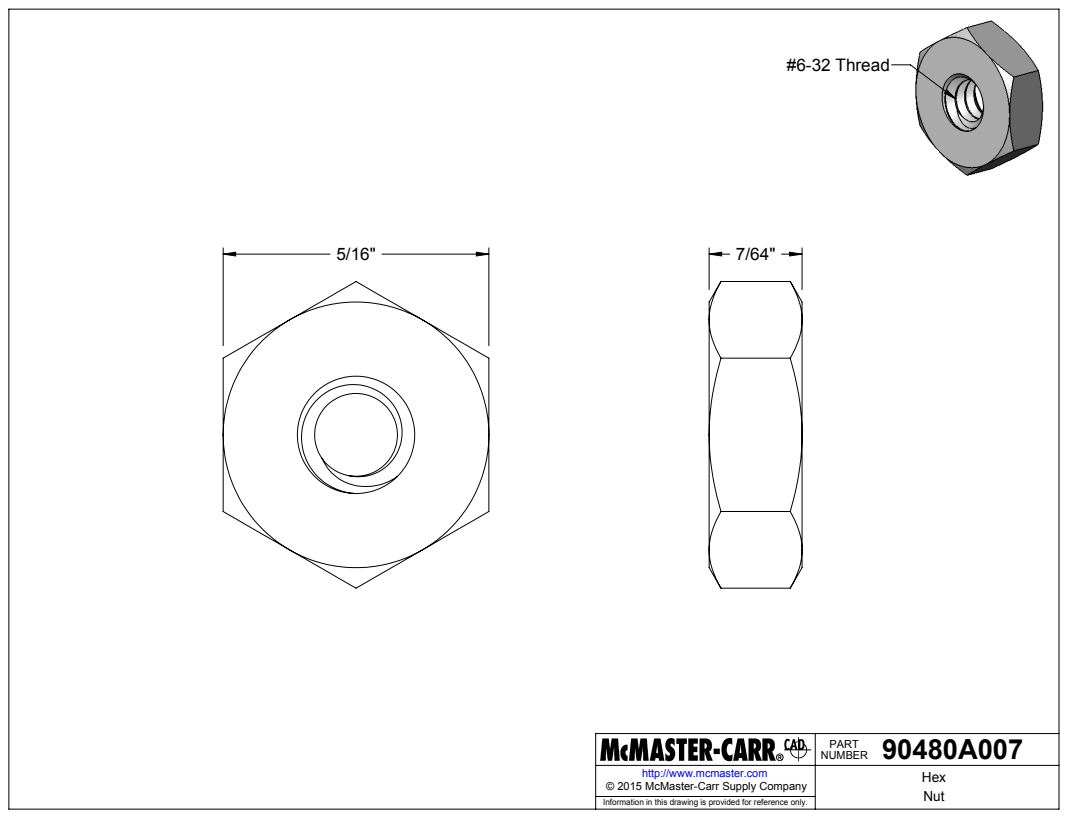
[picture p280: page 19]
#6-32 Thread

90480A007 PART NUMBER

Hex Nut © 2015 McMaster-Carr Supply Company

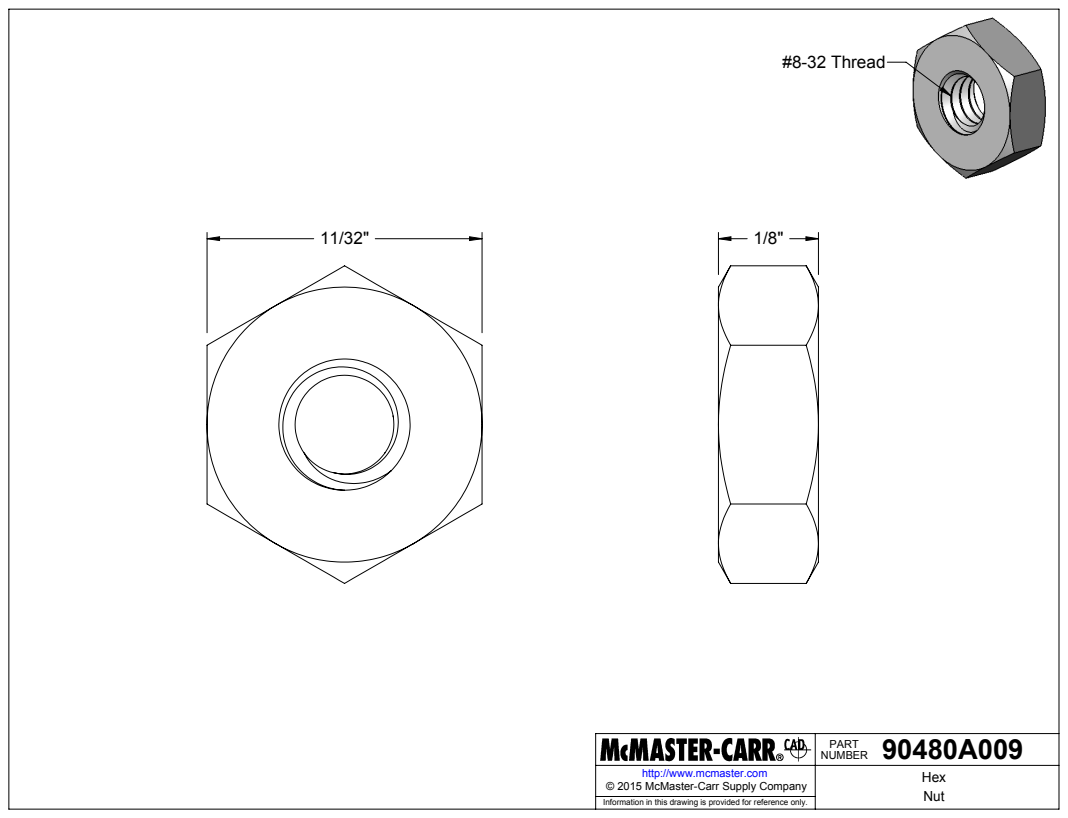
[picture p281: page 20]
#8-32 Thread

90480A009 PART NUMBER

Hex Nut © 2015 McMaster-Carr Supply Company

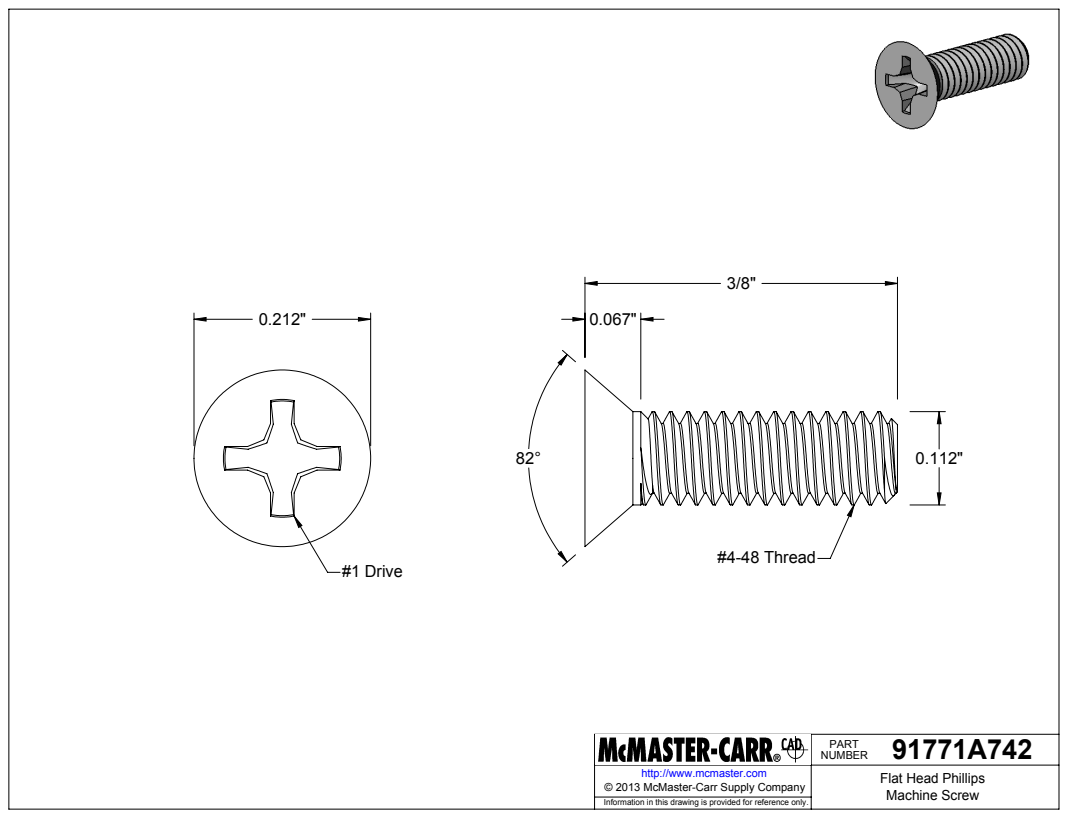
[picture p282: page 21]
#4-48 Thread; #1 Drive

91771A742 PART NUMBER

Flat Head Phillips Machine Screw © 2013 McMaster-Carr Supply Company

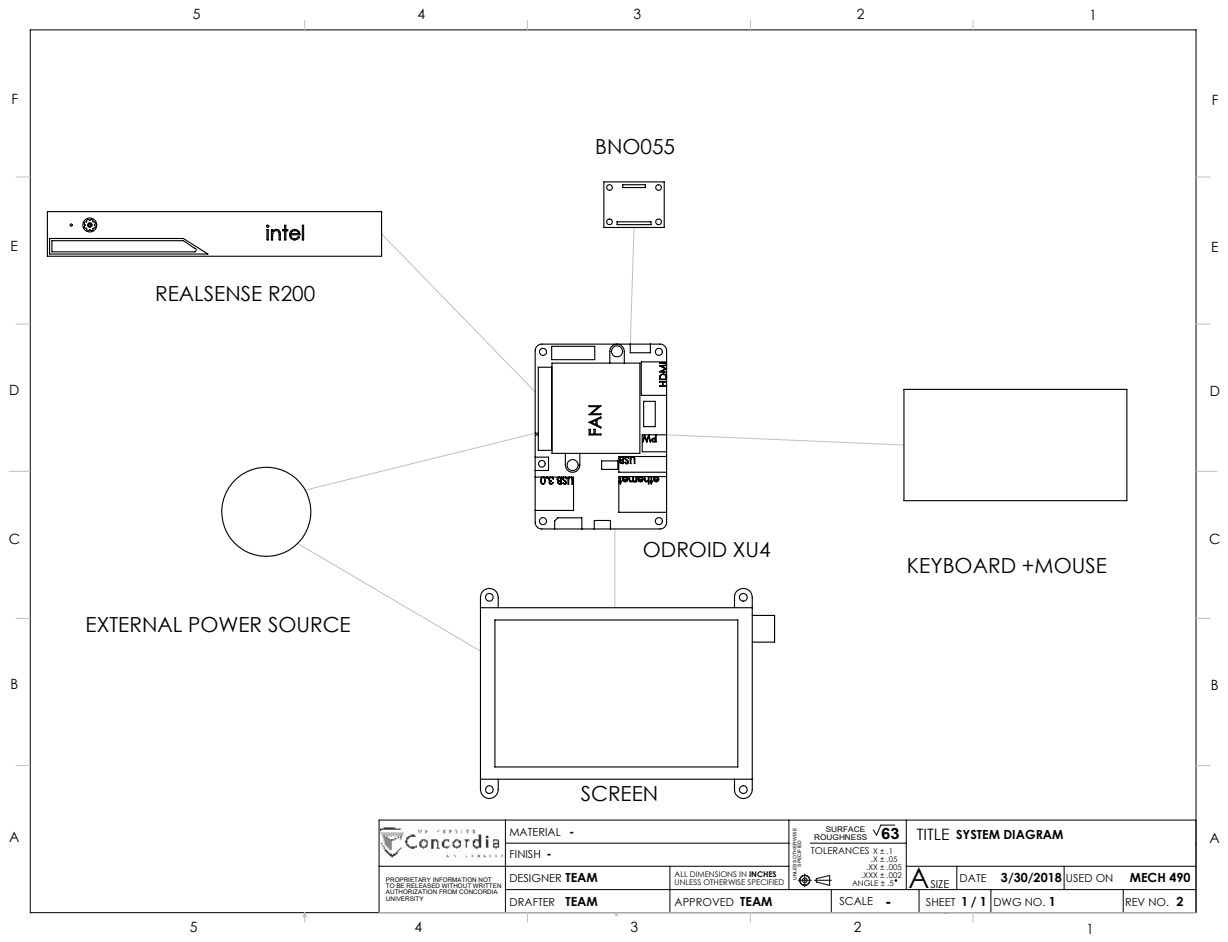
[picture p283: page 22]
SCREEN; ODROID XU4; REALSENSE R200; BNO055; KEYBOARD +MOUSE; TEAM; PROPRIETARY INFORMATION NOT; TEAM TO BE RELEASED WITHOUT WRITTEN; UNLESS OTHERWISE; SPECIFIED; SURFACE ROUGHNESS; FINISH; ASIZE; TOLERANCES X ± .1 .X ± .05 .XX ± .005 .XXX ± .002; DRAFTER; APPROVED; SCALE -; SYSTEM DIAGRAM; SHEET 1 / 1; REV NO.; DATE 3/30/2018; MATERIAL; TITLE

EXTERNAL POWER SOURCE

ALL DIMENSIONS IN INCHES

USED ON MECH 490

AUTHORIZATION FROM CONCORDIA
UNIVERSITY
