cbkiyanda/AR/Documents/Capstone 2017-18/Midterm Report/Copy of Combined Drawings.pdf

F

F

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

ALL DIMENSIONS IN mm
UNLESS OTHERWISE SPECIFIED

USED ON MECH 490

AUTHORIZATION FROM CONCORDIA
UNIVERSITY

5

2

A. SHAWWA; R. PATEL; BOM-02; PROPRIETARY INFORMATION NOT; A. SHAWWA TO BE RELEASED WITHOUT WRITTEN; UNLESS OTHERWISE; SPECIFIED; SURFACE ROUGHNESS; FINISH; ASIZE; TOLERANCES X ± .1 .X ± .05 .XX ± .005 .XXX ± .002; DATE 10/31/2017; MATERIAL

ITEM NO. | DRAWING NUMBER | DESCRIPTION | MANUFACTURED/ PURCHASED

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

TITLE
HEADSET ASSEMBLY + BOM

ALL DIMENSIONS IN mm

USED ON MECH 490

F

F

A. SHAWWA; R. PATEL; PROPRIETARY INFORMATION NOT; A. SHAWWA TO BE RELEASED WITHOUT WRITTEN; UNLESS OTHERWISE; SPECIFIED; SURFACE ROUGHNESS; ASIZE; TOLERANCES X ± .1 .X ± .05 .XX ± .005 .XXX ± .002; BACK COVER; DATE 10/31/2017; MATERIAL; TITLE

POLYLACTIC ACID (PLA -3D PRINT)
FINISH

ALL DIMENSIONS IN mm

USED ON MECH 490

85
F

M. A. YADAO; R. PATEL; PROPRIETARY INFORMATION NOT; N. CIERSON TO BE RELEASED WITHOUT WRITTEN; UNLESS OTHERWISE; SPECIFIED; SURFACE ROUGHNESS; ASIZE; TOLERANCES X ± .1 .X ± .05 .XX ± .005 .XXX ± .002; Back piece; DATE 10/8/2017; MATERIAL; TITLE

POLYLACTIC ACID (PLA - 3D PRINT)
FINISH

SOLIDWORKS Educational Product. For Instructional Use Only.

ALL DIMENSIONS IN METRIC

USED ON MECH 490

140
83

4X 3.20 THRU; SECTION A-A SCALE 1 : 2; M. A. YADAO; R. PATEL; PROPRIETARY INFORMATION NOT; A. SHAWWA TO BE RELEASED WITHOUT WRITTEN; UNLESS OTHERWISE; SPECIFIED; SURFACE ROUGHNESS; ASIZE; TOLERANCES X ± .1 .X ± .05 .XX ± .005 .XXX ± .002; Headset; DATE 10/8/2017; MATERIAL; TITLE

POLYLACTIC ACID (PLA - 3D PRINT)
FINISH

SOLIDWORKS Educational Product. For Instructional Use Only.

ALL DIMENSIONS IN METRIC

USED ON MECH 490

3

F

4X 10 THRU; A. SHAWWA; R. PATEL; PROPRIETARY INFORMATION NOT; A. SHAWWA TO BE RELEASED WITHOUT WRITTEN; UNLESS OTHERWISE; SPECIFIED; SURFACE ROUGHNESS; ASIZE; TOLERANCES X ± .1 .X ± .05 .XX ± .005 .XXX ± .002; TOP COVER; DATE 10/31/2017; MATERIAL; TITLE

POLYLACTIC ACID (PLA -3D PRINT)
FINISH

ALL DIMENSIONS IN mm

USED ON MECH 490

F

F

ONLINE; PROPRIETARY INFORMATION NOT; ONLINE TO BE RELEASED WITHOUT WRITTEN; UNLESS OTHERWISE; SPECIFIED; SURFACE ROUGHNESS; FINISH; ASIZE; TOLERANCES X ± .1 .X ± .05 .XX ± .005 .XXX ± .002; DATE 10/8/2017; MATERIAL

TITLE
Intel real sense camera R200

SOLIDWORKS Educational Product. For Instructional Use Only.

ALL DIMENSIONS IN METRIC

USED ON MECH 490

F

F

ONLINE; PROPRIETARY INFORMATION NOT; ONLINE TO BE RELEASED WITHOUT WRITTEN; UNLESS OTHERWISE; SPECIFIED; SURFACE ROUGHNESS; FINISH; ASIZE; TOLERANCES X ± .1 .X ± .05 .XX ± .005 .XXX ± .002; Odroid XU4; DATE 10/8/2017; MATERIAL; TITLE

SOLIDWORKS Educational Product. For Instructional Use Only.

ALL DIMENSIONS IN METRIC

USED ON MECH 490

F

F

A. SHAWWA; R. PATEL; PROPRIETARY INFORMATION NOT; ONLINE TO BE RELEASED WITHOUT WRITTEN; UNLESS OTHERWISE; SPECIFIED; SURFACE ROUGHNESS; FINISH; ASIZE; TOLERANCES X ± .1 .X ± .05 .XX ± .005 .XXX ± .002; SCREEN; DATE 10/31/2017; MATERIAL; TITLE

ALL DIMENSIONS IN mm

USED ON MECH 490

F

F

M. A. YADAO; R. PATEL; PROPRIETARY INFORMATION NOT; F. YUNUS TO BE RELEASED WITHOUT WRITTEN; UNLESS OTHERWISE; SPECIFIED; SURFACE ROUGHNESS; FINISH; ASIZE; TOLERANCES X ± .1 .X ± .05 .XX ± .005 .XXX ± .002; Screen viewer; DATE 10/8/2017; MATERIAL; TITLE

SOLIDWORKS Educational Product. For Instructional Use Only.

ALL DIMENSIONS IN METRIC

USED ON MECH 490

F

F

A.SHAWWA; R. PATEL; HST-01; PROPRIETARY INFORMATION NOT; A. SHAWWA TO BE RELEASED WITHOUT WRITTEN; VELCRO; UNLESS OTHERWISE; SPECIFIED; SURFACE ROUGHNESS; FINISH; ASIZE; TOLERANCES X ± .1 .X ± .05 .XX ± .005 .XXX ± .002; HEAD STRAP; DATE 10/31/2017; MATERIAL; TITLE

ALL DIMENSIONS IN mm

USED ON MECH 490

F

F

M. A. YADAO; R. PATEL; PROPRIETARY INFORMATION NOT; A. SHAWWA TO BE RELEASED WITHOUT WRITTEN; UNLESS OTHERWISE; SPECIFIED; SURFACE ROUGHNESS; FINISH; ASIZE; TOLERANCES X ± .1 .X ± .05 .XX ± .005 .XXX ± .002; DRAFTER; APPROVED; SCALE 2:1; DATE 10/8/2017; MATERIAL

TITLE
Adafruit BNO055 motion sensor

SOLIDWORKS Educational Product. For Instructional Use Only.

ALL DIMENSIONS IN METRIC

USED ON MECH 490
