cbkiyanda/AR/Documents/Capstone 2017-18/Engineering Drawings/V5/V5 FINAL Assembly _Report/Fasteners/90272A194_ZINC-PLTD STL PAN HEAD PHILLIPS MACHINE SCREW.PDF

#2 Drive; #8-32 Thread

90272A194 PART NUMBER

http://www.mcmaster.com | Pan Head Phillips Machine Screw © 2012 McMaster-Carr Supply Company

Information in this drawing is provided for reference only.
