cbkiyanda/AR/Documents/Capstone 2017-18/Engineering Drawings/V5/V5 FINAL Assembly _Report/Fasteners/90273A070_ZINC-PLATED STL FLAT HEAD PHIL MACHINE SCREW.PDF

#2-56 Thread; #1 Drive

90273A070 PART NUMBER

http://www.mcmaster.com | Flat Head Phillips Machine Screw © 2012 McMaster-Carr Supply Company

Information in this drawing is provided for reference only.
