cbkiyanda/AR/Documents/Capstone 2017-18/Engineering Drawings/V5/V5 FINAL Assembly _Report/Fasteners/90480A007_LOW-STRENGTH STEEL HEX NUT.PDF

#6-32 Thread

90480A007 PART NUMBER

http://www.mcmaster.com | Hex Nut © 2015 McMaster-Carr Supply Company

Information in this drawing is provided for reference only.
