cbkiyanda/AR/Documents/Capstone 2017-18/Engineering Drawings/V5/V5 FINAL Assembly _Report/Fasteners/91771A742_18-8 SS FLAT HEAD PHILLIPS MACHINE SCREW.PDF

#4-48 Thread; #1 Drive

91771A742 PART NUMBER

http://www.mcmaster.com | Flat Head Phillips Machine Screw © 2013 McMaster-Carr Supply Company

Information in this drawing is provided for reference only.
