cbkiyanda/AR/Documents/Capstone 2017-18/Audit 2/A02-1718-09-AR HEADSET.pdf

CAPSTONE MiniPDM | Page 1 of 1
Year | 2017
Team | Group #9
Device | AR Headset
CASH | CASH | CAPCOIN | CAPCOIN | SPONSOR
CODE | Item | Description | Drawing#/Part# | MNF/OEM/SPL | QTY | Material [$] | Labour [$] | CODE | Capcoin$ | In Kind
1 | Screen | SC-01 | | 1 | | - | - | - | Dr. Kiyanda
2 | Adafruit BNO 055 (motion sensor) | MS-01 | | 1 | | - | - | - | Dr. Kiyanda
3 | Intel realsense camera R200 | IR-01 | PURCHASED | 1 | 153.36 | - | - | -
4 | Odroid XU4 | XU4-01 | PURCHASED | 1 | 120.57 | - | - | -
5 | Headset | HS-01 | STUDENT (3D PRINT) | 2 | | - | - | -
6 | Top cover | TC-01 | STUDENT (3D PRINT) | 2 | | - | - | -
7 | Back cover | BC-01 | STUDENT (3D PRINT) | 2 | | - | - | -
8 | Back piece | BP-01 | STUDENT (3D PRINT) | 2 | | - | - | -
9 | Screen viewer | SV-01 | | | | - | - | -
10
SUBTOTALS | 273.93 | 0 | 0 | 0 | 0

CON-M490-295.20/09/2012

2

ITEM NO. | DRAWING NUMBER | DESCRIPTION | MANUFACTURED / PURCHASED

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

6 | MS-01 | Adafruit BNO055 motion sensor | PURCHASED

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

TITLE
Headset Assembly+ BOM

ALL DIMENSIONS IN METRIC
UNLESS OTHERWISE SPECIFIED

USED ON MECH 490

AUTHORIZATION FROM CONCORDIA
UNIVERSITY

F

F

M. A. YADAO; R. PATEL; PROPRIETARY INFORMATION NOT; A. SHAWWA TO BE RELEASED WITHOUT WRITTEN; UNLESS OTHERWISE; SPECIFIED; SURFACE ROUGHNESS; FINISH; ASIZE; TOLERANCES X ± .1 .X ± .05 .XX ± .005 .XXX ± .002; Headset Assembly; DATE 10/8/2017; MATERIAL; TITLE

SOLIDWORKS Educational Product. For Instructional Use Only.

ALL DIMENSIONS IN METRIC

USED ON MECH 490

11

15

4X 10 THRU; M. A. YADAO; R. PATEL; PROPRIETARY INFORMATION NOT; A. SHAWWA TO BE RELEASED WITHOUT WRITTEN; UNLESS OTHERWISE; SPECIFIED; SURFACE ROUGHNESS; ASIZE; TOLERANCES X ± .1 .X ± .05 .XX ± .005 .XXX ± .002; Top Cover; DATE 10/8/2017; MATERIAL; TITLE

POLYLACTIC ACID (PLA - 3D PRINT)
FINISH

SOLIDWORKS Educational Product. For Instructional Use Only.

ALL DIMENSIONS IN METRIC

USED ON MECH 490

85
F

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

POLYLACTIC ACID (PLA - 3D PRINT)
FINISH

SOLIDWORKS Educational Product. For Instructional Use Only.

ALL DIMENSIONS IN METRIC

USED ON MECH 490

140
83

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

POLYLACTIC ACID (PLA - 3D PRINT)
FINISH

SOLIDWORKS Educational Product. For Instructional Use Only.

ALL DIMENSIONS IN METRIC

USED ON MECH 490

F

F

M. A. YADAO; R. PATEL; PROPRIETARY INFORMATION NOT; A. SHAWWA TO BE RELEASED WITHOUT WRITTEN; UNLESS OTHERWISE; SPECIFIED; SURFACE ROUGHNESS; ASIZE; TOLERANCES X ± .1 .X ± .05 .XX ± .005 .XXX ± .002; Back Cover; DATE 10/8/2017; MATERIAL; TITLE

POLYLACTIC ACID (PLA - 3D PRINT)
FINISH

SOLIDWORKS Educational Product. For Instructional Use Only.

ALL DIMENSIONS IN METRIC

USED ON MECH 490

F

F

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

SOLIDWORKS Educational Product. For Instructional Use Only.

ALL DIMENSIONS IN METRIC

USED ON MECH 490

F

F

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

TITLE
Intel real sense camera R200

SOLIDWORKS Educational Product. For Instructional Use Only.

ALL DIMENSIONS IN METRIC

USED ON MECH 490

F

F

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

SOLIDWORKS Educational Product. For Instructional Use Only.

ALL DIMENSIONS IN METRIC

USED ON MECH 490

F

F

M. A. YADAO; R. PATEL; PROPRIETARY INFORMATION NOT; A. SHAWWA TO BE RELEASED WITHOUT WRITTEN; UNLESS OTHERWISE; SPECIFIED; SURFACE ROUGHNESS; FINISH; ASIZE; TOLERANCES X ± .1 .X ± .05 .XX ± .005 .XXX ± .002; Screen; DATE 10/8/2017; MATERIAL; TITLE

SOLIDWORKS Educational Product. For Instructional Use Only.

ALL DIMENSIONS IN METRIC

USED ON MECH 490

F

F

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

TITLE
Adafruit BNO055 motion sensor

SOLIDWORKS Educational Product. For Instructional Use Only.

ALL DIMENSIONS IN METRIC

USED ON MECH 490

1

A

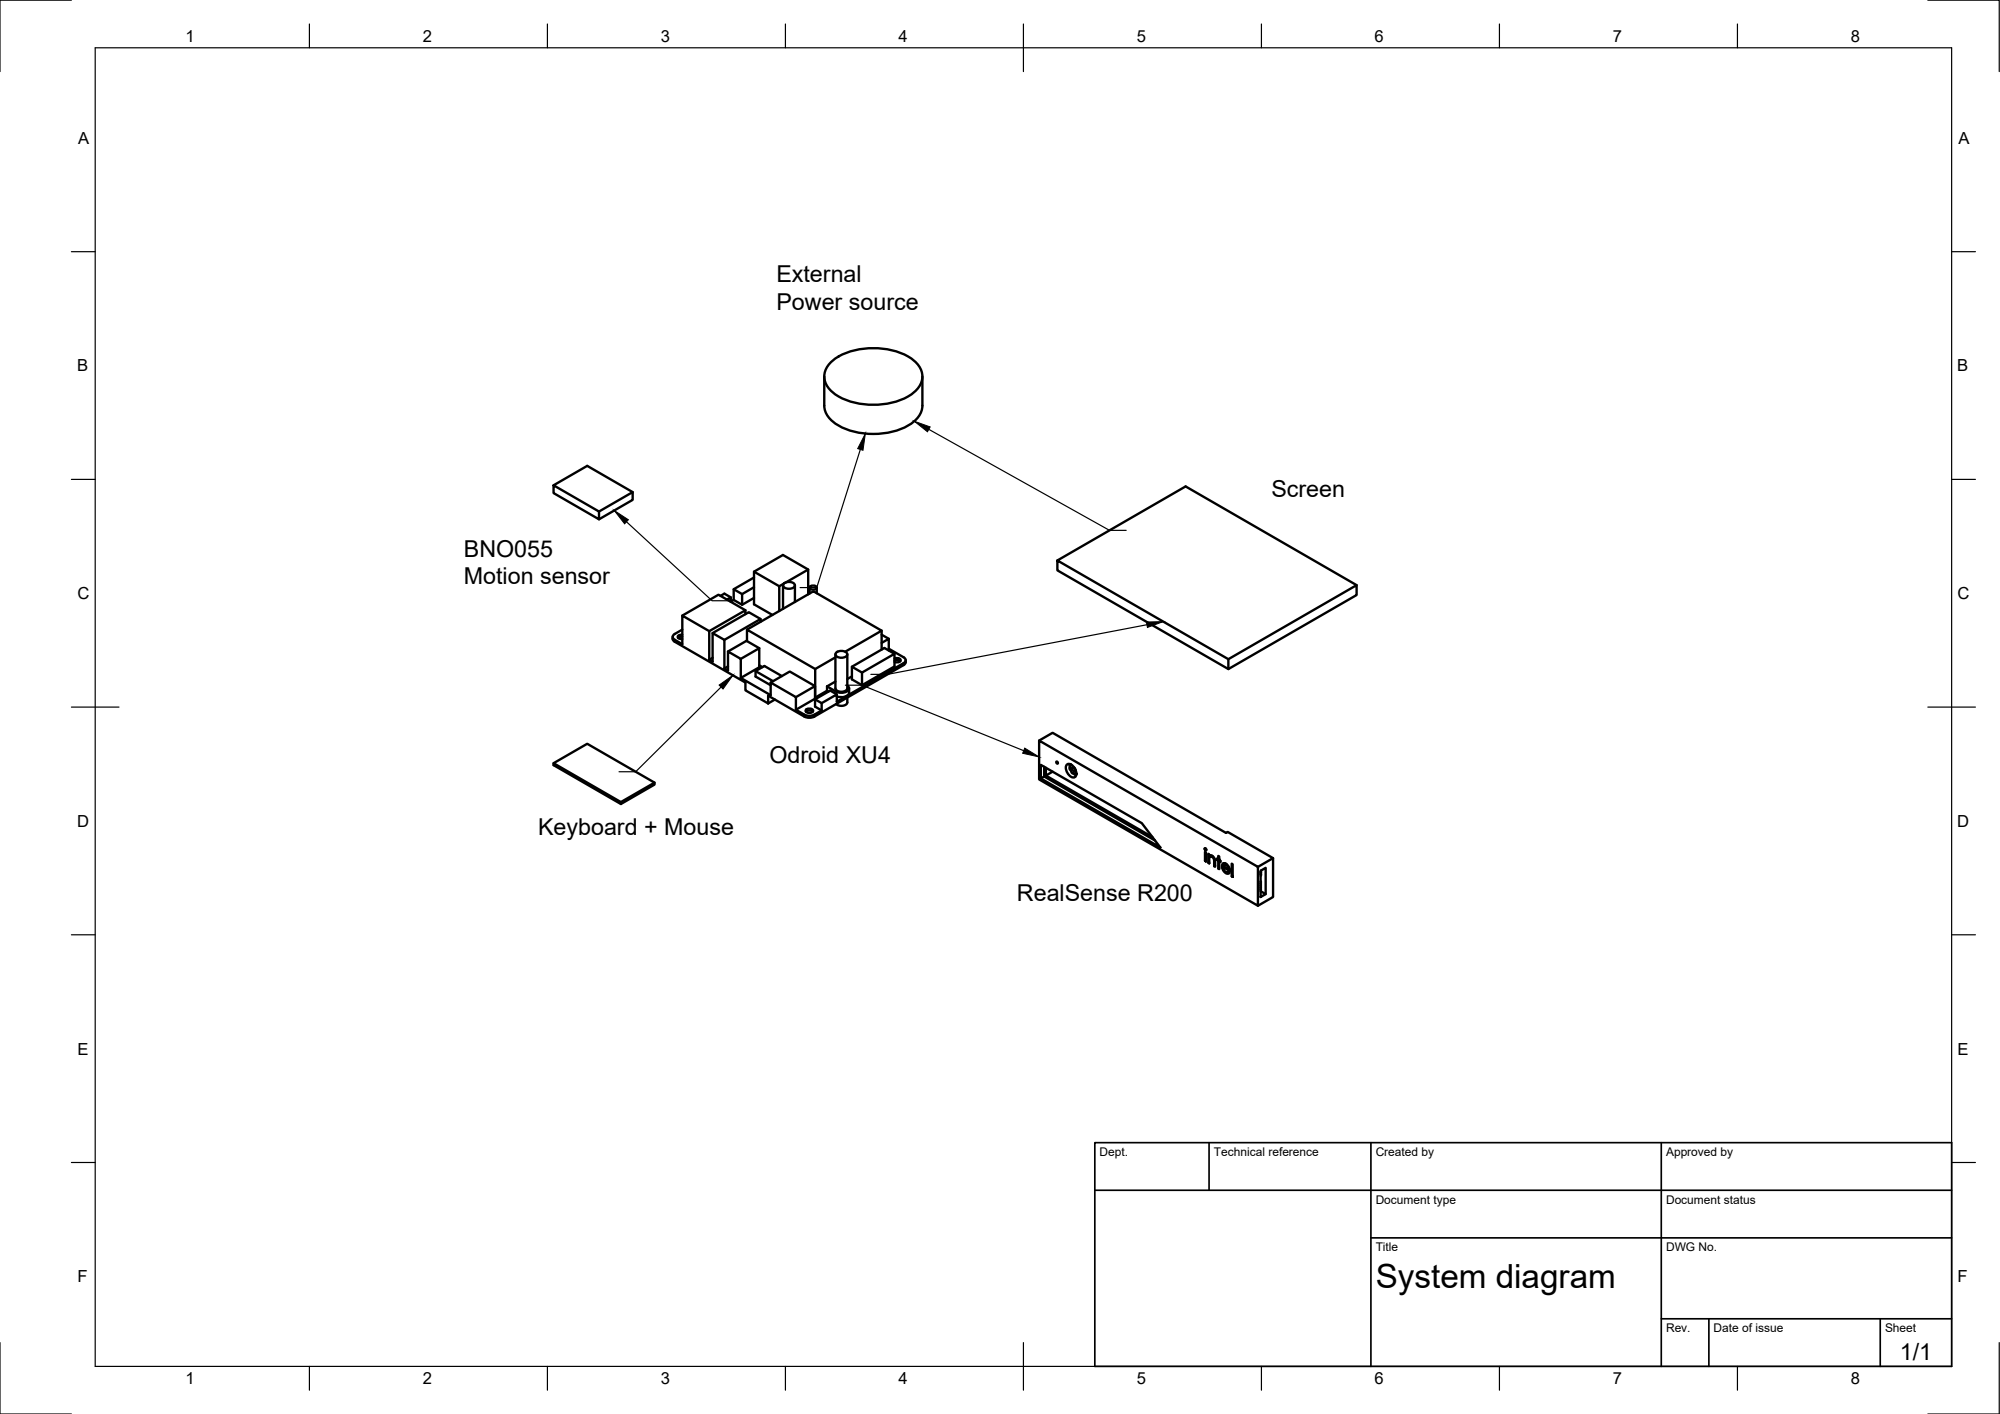
[picture p284: page 13]
Dept.; Technical reference; Created by; Approved by; Document type; Document status; Odroid XU4; BNO055 Motion sensor; Keyboard + Mouse; Screen; RealSense R200; External Power source

Title System diagram | DWG No.

Rev. | Date of issue | Sheet 1/1
