cbkiyanda/AR/Documents/Capstone 2017-18/Audit 2/System diagram Drawing v1.pdf

Odroid XU4; Motion sensor; Keyboard + Mouse; RealSense R200; Power source

Dept. | Technical reference | Created by | Approved by

Document type | Document status

Title System diagram | DWG No.

Rev. | Date of issue | Sheet 1/1
