cbkiyanda/AR/Documents/Capstone 2017-18/FDP/FDP-1718-9-AR_Headset.pdf

# FINAL DRAWING PACKAGE

### Michael-Angelo Yadao, 27415559

### Nicholas Cierson, 27318014

### Rahul Patel, 27199708

### Kostas Zoitakis, 27393741

### Muhammad Haseb Ellahi, 27437579

### Faraz Yunus, 27489994

### Amir Shawwa, 29271627

### MECH 490: Capstone Engineering Design Project

28/11/2017

1

Product Specifications

Overall dimensions of headset: 8.2 x 7.5 x 12.7 in

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

Processor

ODROID-XU4 chip

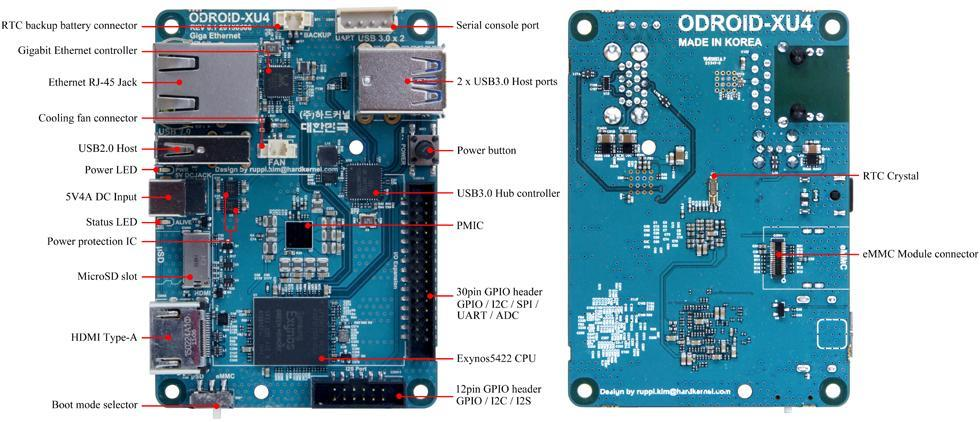
[picture p285: figure]

Figure 1: ODROID-XU4 board detail, adapted from [1]

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

2

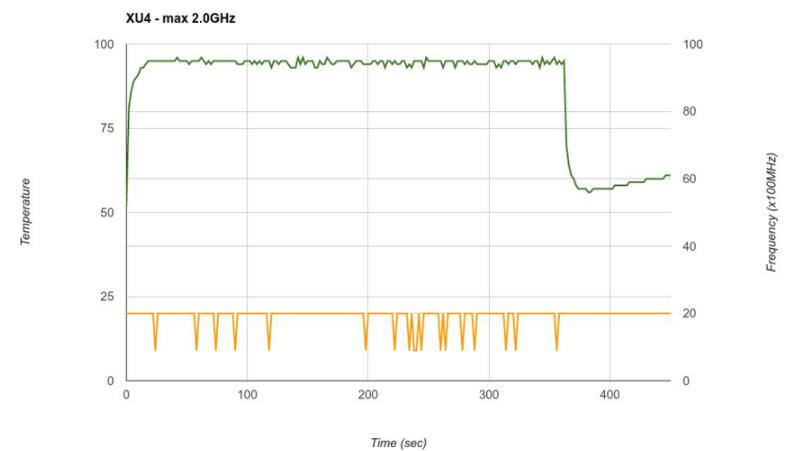
[picture p286: figure]

Figure 2: ODROID-XU4 operating temperature vs running time using active cooling, adapted from [1]

Sensors

Adafruit BNO055 9-DOF sensor

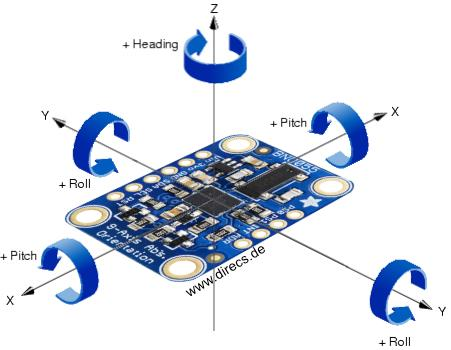
[picture p287: figure]

Figure 3: BNO055 axes of rotation, adapted from [2]

Data output [3]:

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

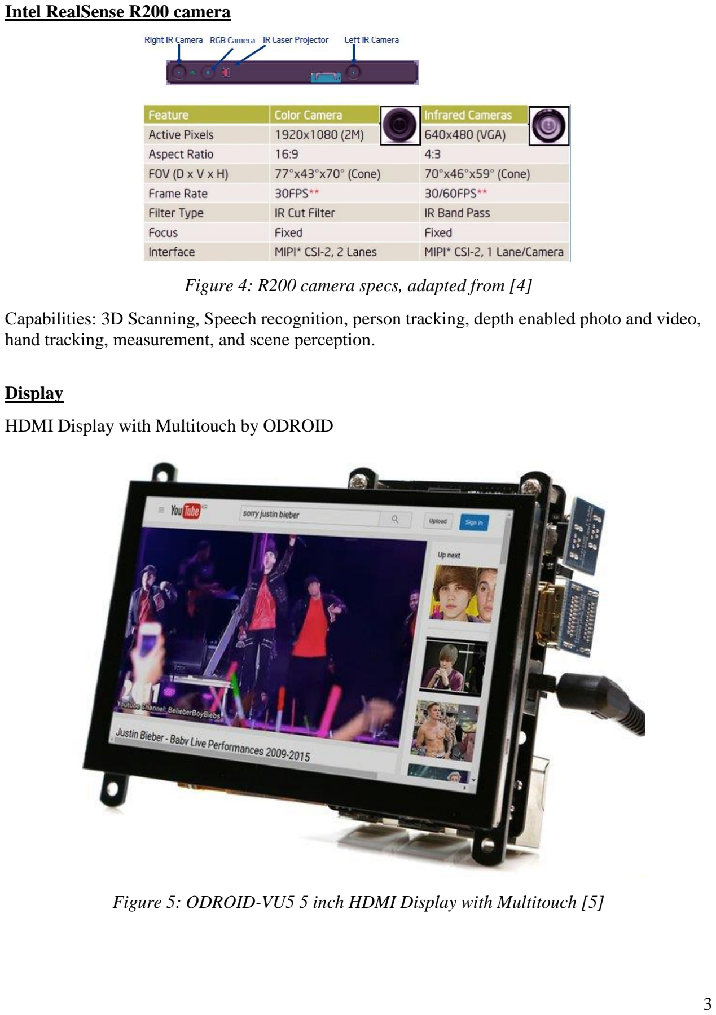
[picture p288: page 4]

3

Intel RealSense R200 camera

Figure 4: R200 camera specs, adapted from [4]

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

Display

HDMI Display with Multitouch by ODROID

Figure 5: ODROID-VU5 5 inch HDMI Display with Multitouch [5]

4

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

Also includes:

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

Optics

Clear acrylic sheet, thickness approximatively ¼ inch.

Optional: Semi-reflective, 1-way mirror film. (Inserted over the acrylic sheet)

Significant OEM Purchases

1. ODROID-VU5 5 inch HDMI Display with Multitouch (decided after FFF): ~55$
2. Intel RealSense R200 Camera (purchased): ~153$
3. ODROID-XU4 processor (purchased): ~120$
4. Breakout Board 9-DOF Motion Sensor BNO005 (purchased): ~63$
5. Right Angle USB 3.0 to Micro B Male cable (purchased): ~9$
6. Right Angle HDMI to HDMI cable (purchased): ~9$
7. SanDisk 32GB microSD Class UHS-I (purchased): ~20$

5

Test and Safety Procedures

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

Please note, these figures are for reference only. For more information please refer to the midterm

report for the complete test.

Drop Test

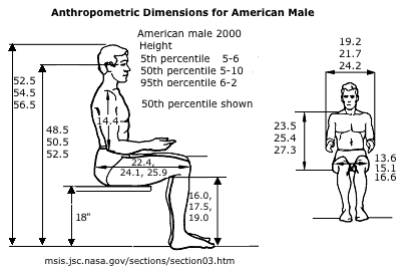
[picture p289: figure]

Figure 6: Heights of Males at Different Percentile [6]

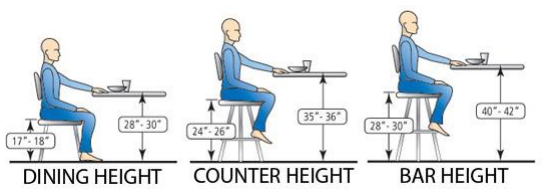
[picture p290: figure]

Figure 7: Average Height of Counters [7]

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

is dropped from different heights. We will be dropping the AR headset from a counter height,

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

will be replacing the hardware with test material to replicate the weight of the individual

6

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

For this test, we will be following standard UL 60950-1 Standard on Information Technology

Equipment Safety written by Underwriters Laboratories (UL). The drop test will show compliance

to section 4.2.6 of standard UL 60950-1 (Drop Test) [8].

Thermal Test

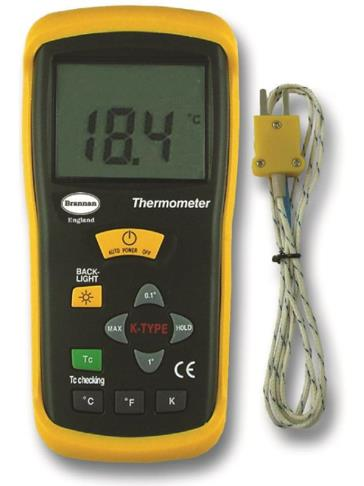
[picture p291: figure]

Figure 8: Thermocouple

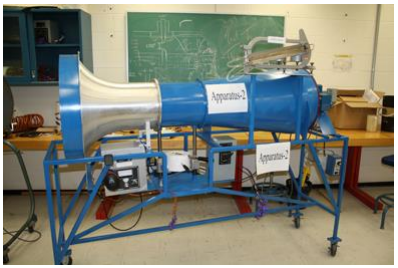
[picture p292: figure]

Figure 9: Small Wind tunnel

7

The objective of this test is to note the operating temperature of the Augmented Reality (AR)

headset. Additionally, we want to observe the air speed required to adequately bring down the

temperature of the AR headset to 30 °C.

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

limits of touchable surfaces for metals and non-metals over certain periods of time.

Vibration Test

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

vibration machine to see whether any of the hardware comes loose. The location and machine is

yet to be determined.

8

References

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

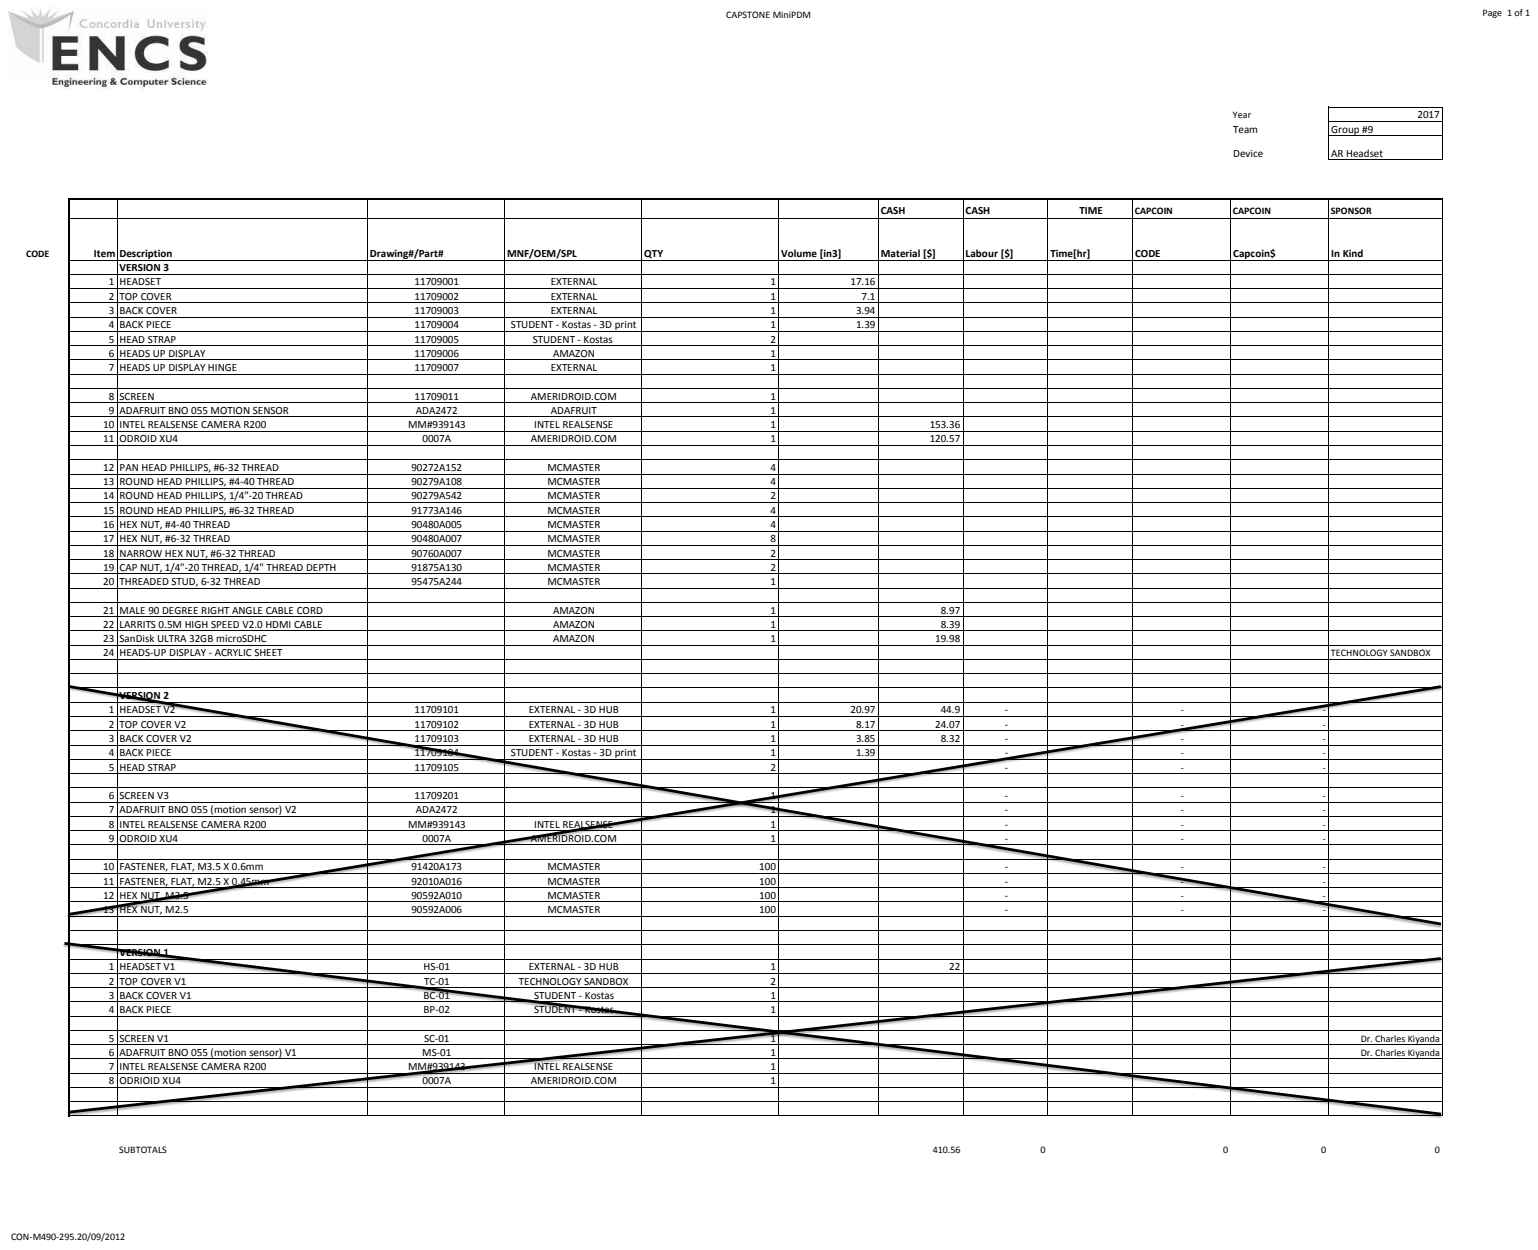
[picture p293: page 10]
CAPSTONE MiniPDM; Page 1 of 1; Year; Team; Group #9; Device; AR Headset; CASH; TIME; CAPCOIN; SPONSOR; CODE; Item; Description; Drawing#/Part#; MNF/OEM/SPL; QTY; Volume [in3]; Material [$]; Labour [$]; Time[hr]; Capcoin$; In Kind; SUBTOTALS; CON-M490-295.20/09/2012

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

Title System diagram | DWG No.

Rev. | Date of issue | Sheet 1/1

8.19

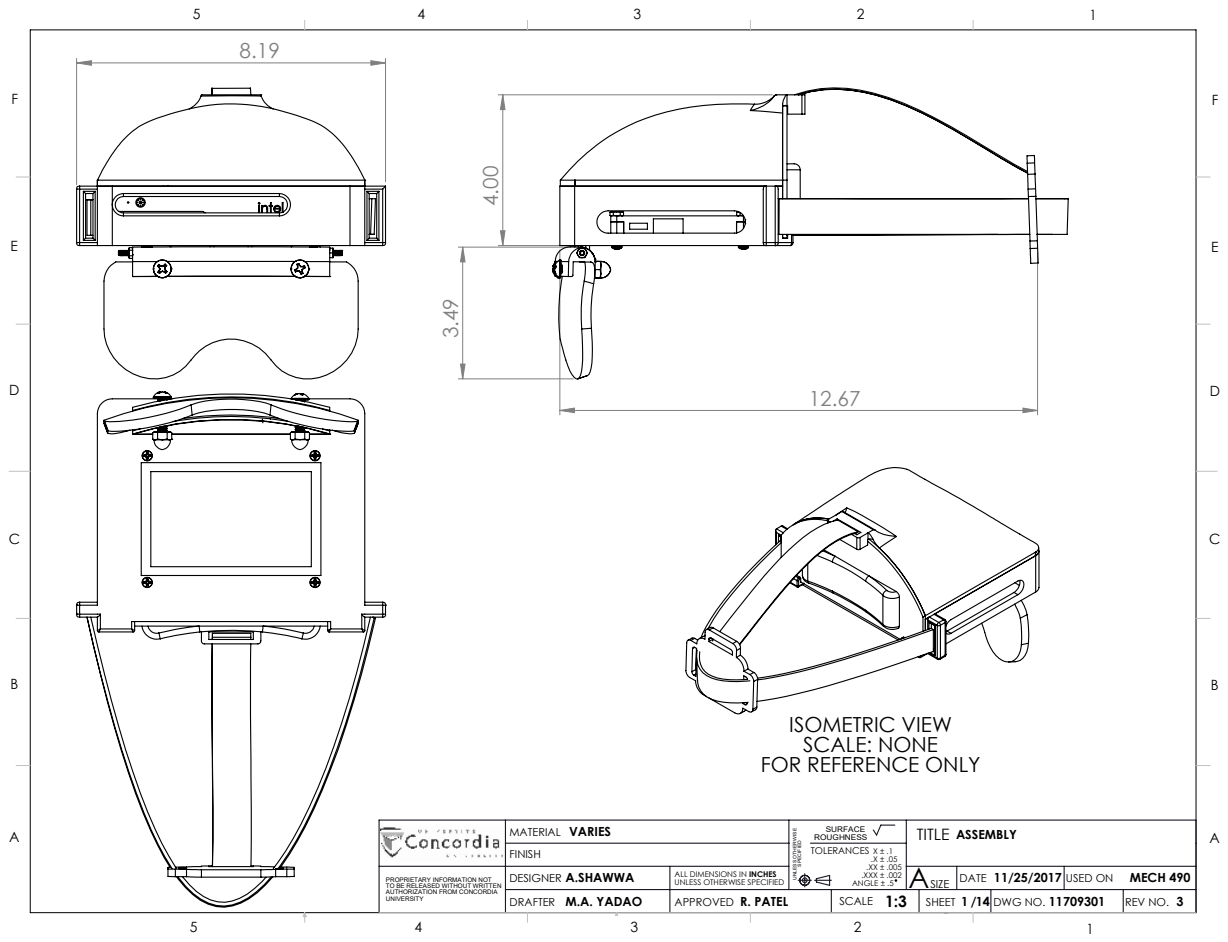
[picture p294: page 12]
M.A. YADAO; R. PATEL; PROPRIETARY INFORMATION NOT; A.SHAWWA TO BE RELEASED WITHOUT WRITTEN; VARIES; UNLESS OTHERWISE; SPECIFIED; SURFACE ROUGHNESS; DWG NO.; FINISH; ASIZE; TOLERANCES X ± .1 .X ± .05 .XX ± .005 .XXX ± .002 ANGLE ± .5; DRAFTER; APPROVED; SCALE 1:3; ASSEMBLY; SHEET 1 /14; REV NO.; DATE 11/25/2017; MATERIAL; DESIGNER; TITLE

ISOMETRIC VIEW
SCALE: NONE
FOR REFERENCE ONLY

ALL DIMENSIONS IN INCHES
UNLESS OTHERWISE SPECIFIED

USED ON MECH 490

AUTHORIZATION FROM CONCORDIA
UNIVERSITY

A

57

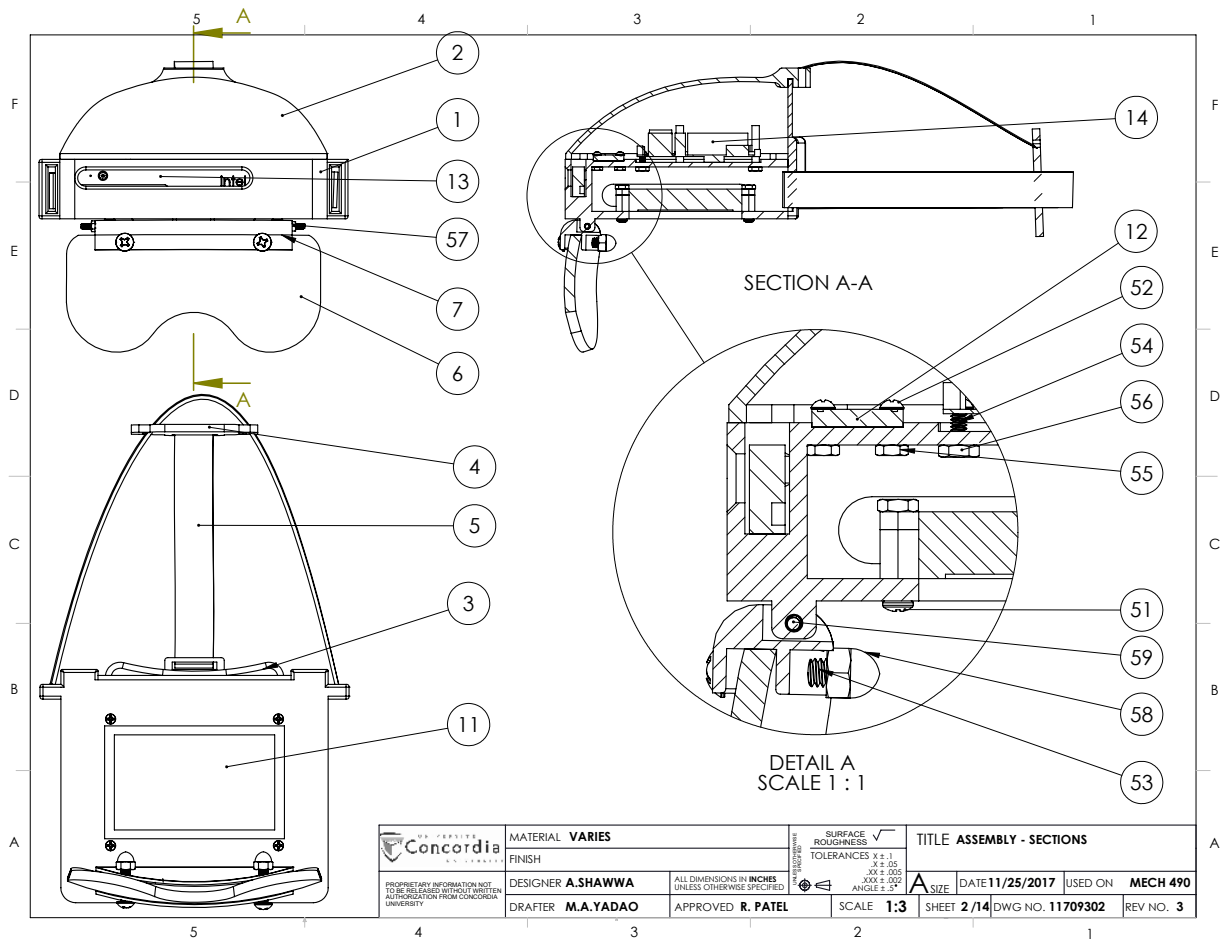
[picture p295: page 13]
SECTION A-A; DETAIL A SCALE 1 : 1; M.A.YADAO; R. PATEL; PROPRIETARY INFORMATION NOT; A.SHAWWA TO BE RELEASED WITHOUT WRITTEN; VARIES; UNLESS OTHERWISE; SPECIFIED; SURFACE ROUGHNESS; DWG NO.; FINISH; ASIZE; TOLERANCES X ± .1 .X ± .05 .XX ± .005 .XXX ± .002 ANGLE ± .5; DRAFTER; APPROVED; SCALE 1:3; ASSEMBLY - SECTIONS; SHEET 2 /14; REV NO.; DATE11/25/2017; MATERIAL; DESIGNER; TITLE

ALL DIMENSIONS IN INCHES
UNLESS OTHERWISE SPECIFIED

USED ON MECH 490

AUTHORIZATION FROM CONCORDIA
UNIVERSITY

ITEM NO. | PART NUMBER | DESCRIPTION | MNF/ OEM/ SPL | QTY.
1 | 11709001 | HEADSET | EXTERNAL | 1

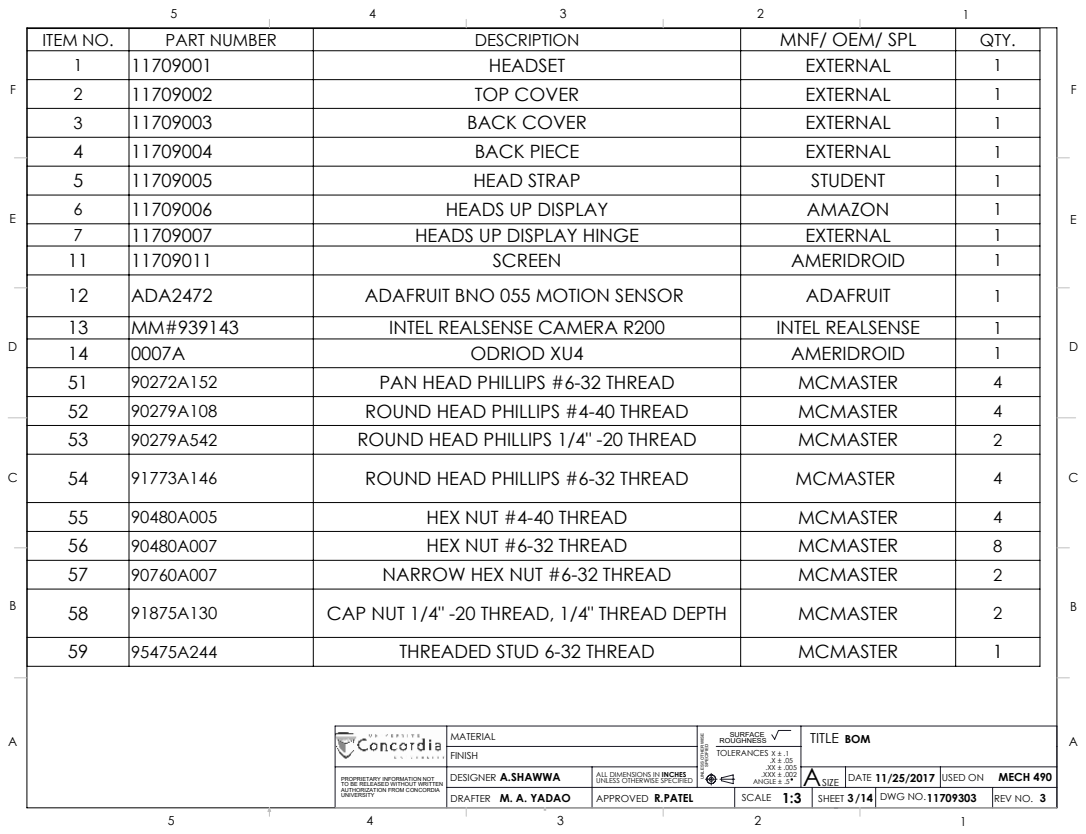
[picture p296: page 14]
M. A. YADAO; R.PATEL; PROPRIETARY INFORMATION NOT; A.SHAWWA TO BE RELEASED WITHOUT WRITTEN; UNLESS OTHERWISE; SPECIFIED; SURFACE ROUGHNESS; DWG NO.; FINISH; ASIZE; TOLERANCES X ± .1 .X ± .05 .XX ± .005 .XXX ± .002 ANGLE ± .5; DRAFTER; APPROVED; SCALE 1:3; BOM; SHEET 3/14; REV NO.; DATE 11/25/2017; MATERIAL; DESIGNER; TITLE

2 | 11709002 | TOP COVER | EXTERNAL | 1
3 | 11709003 | BACK COVER | EXTERNAL | 1
4 | 11709004 | BACK PIECE | EXTERNAL | 1
5 | 11709005 | HEAD STRAP | STUDENT | 1
6 | 11709006 | HEADS UP DISPLAY | AMAZON | 1
7 | 11709007 | HEADS UP DISPLAY HINGE | EXTERNAL | 1
11 | 11709011 | SCREEN | AMERIDROID | 1
12 | ADA2472 | ADAFRUIT BNO 055 MOTION SENSOR | ADAFRUIT | 1
13 | MM#939143 | INTEL REALSENSE CAMERA R200 | INTEL REALSENSE | 1
14 | 0007A | ODRIOD XU4 | AMERIDROID | 1
51 | 90272A152 | PAN HEAD PHILLIPS #6-32 THREAD | MCMASTER | 4
52 | 90279A108 | ROUND HEAD PHILLIPS #4-40 THREAD | MCMASTER | 4
53 | 90279A542 | ROUND HEAD PHILLIPS 1/4" -20 THREAD | MCMASTER | 2
54 | 91773A146 | ROUND HEAD PHILLIPS #6-32 THREAD | MCMASTER | 4
55 | 90480A005 | HEX NUT #4-40 THREAD | MCMASTER | 4
56 | 90480A007 | HEX NUT #6-32 THREAD | MCMASTER | 8
57 | 90760A007 | NARROW HEX NUT #6-32 THREAD | MCMASTER | 2
58 | 91875A130 | CAP NUT 1/4" -20 THREAD, 1/4" THREAD DEPTH | MCMASTER | 2
59 | 95475A244 | THREADED STUD 6-32 THREAD | MCMASTER | 1

ALL DIMENSIONS IN INCHES
UNLESS OTHERWISE SPECIFIED

USED ON MECH 490

AUTHORIZATION FROM CONCORDIA
UNIVERSITY

2.38

3.32

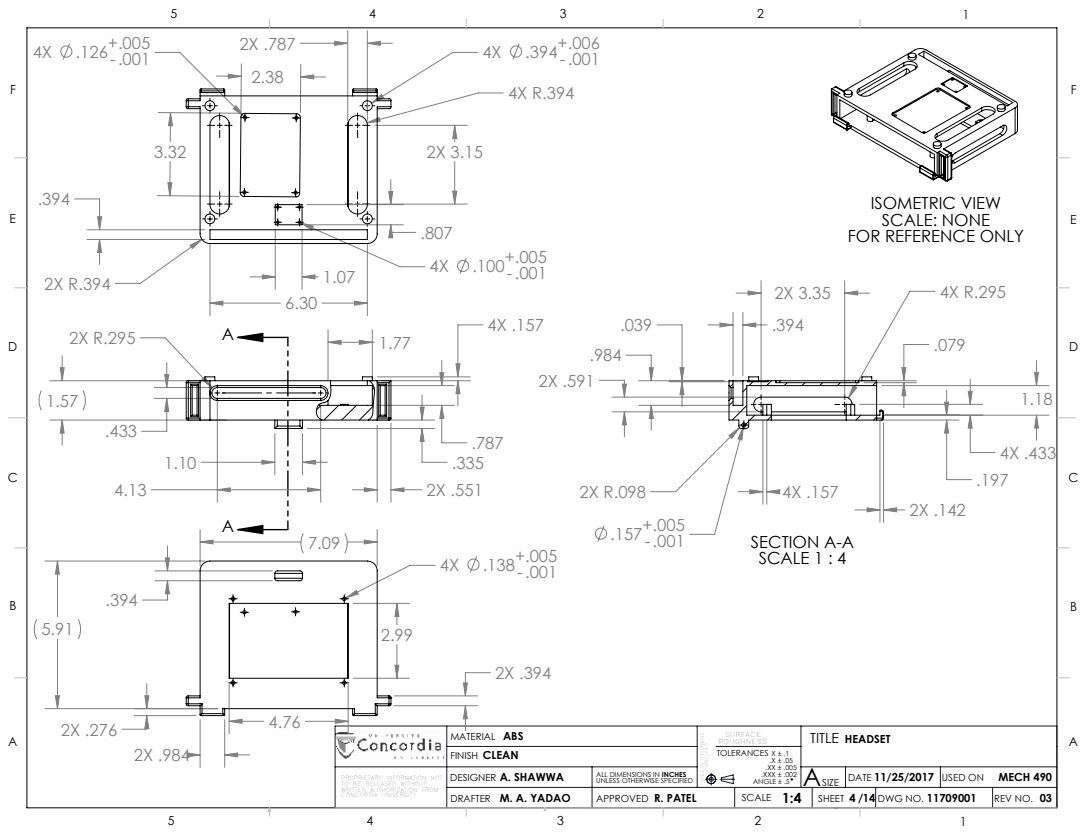
[picture p297: page 15]
SECTION A-A SCALE 1 : 4; M. A. YADAO; R. PATEL; PROPRIETARY INFORMATION NOT; A. SHAWWA TO BE RELEASED WITHOUT; CLEAN; ABS; UNLESS OTHERWISE; SPECIFIED; SURFACE ROUGHNESS; DWG NO.; FINISH; ASIZE; TOLERANCES X ± .1 .X ± .05 .XX ± .005 .XXX ± .002 ANGLE ± .5; DRAFTER; APPROVED; SCALE 1:4; HEADSET; SHEET 4 /14; REV NO.; DATE 11/25/2017; MATERIAL; DESIGNER; TITLE

ISOMETRIC VIEW
SCALE: NONE
FOR REFERENCE ONLY

ALL DIMENSIONS IN INCHES
UNLESS OTHERWISE SPECIFIED

USED ON MECH 490

WRITTEN AUTHORIZATION FROM
CONCORDIA UNIVERSITY

(2.42)

## ISOMETRIC VIEW

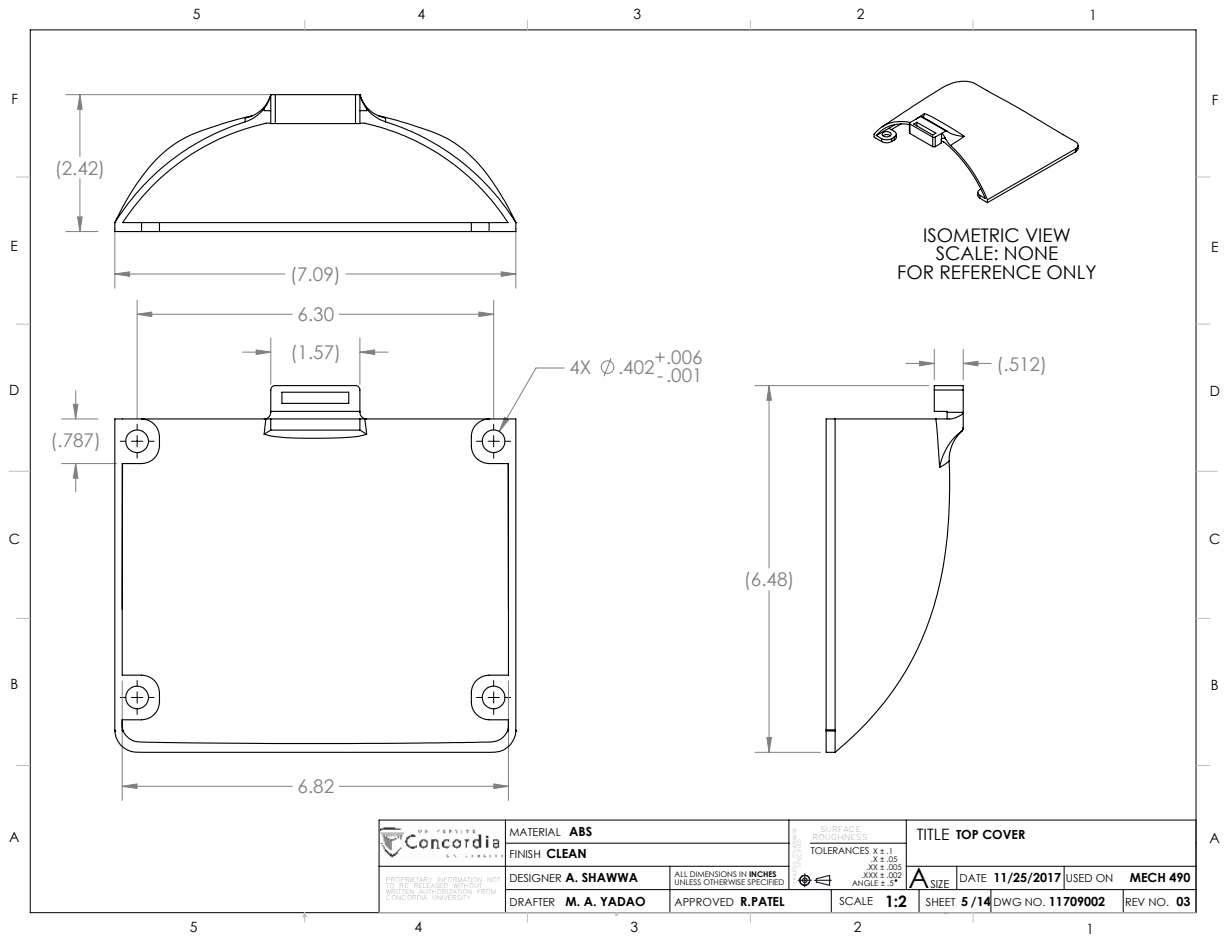
[picture p298: page 16]
M. A. YADAO; R.PATEL; PROPRIETARY INFORMATION NOT; A. SHAWWA TO BE RELEASED WITHOUT; CLEAN; ABS; UNLESS OTHERWISE; SPECIFIED; SURFACE ROUGHNESS; DWG NO.; FINISH; ASIZE; TOLERANCES X ± .1 .X ± .05 .XX ± .005 .XXX ± .002 ANGLE ± .5; DRAFTER; APPROVED; SCALE 1:2; TOP COVER; SHEET 5 /14; REV NO.; DATE 11/25/2017; MATERIAL; DESIGNER; TITLE

SCALE: NONE
FOR REFERENCE ONLY

ALL DIMENSIONS IN INCHES
UNLESS OTHERWISE SPECIFIED

USED ON MECH 490

WRITTEN AUTHORIZATION FROM
CONCORDIA UNIVERSITY

.118

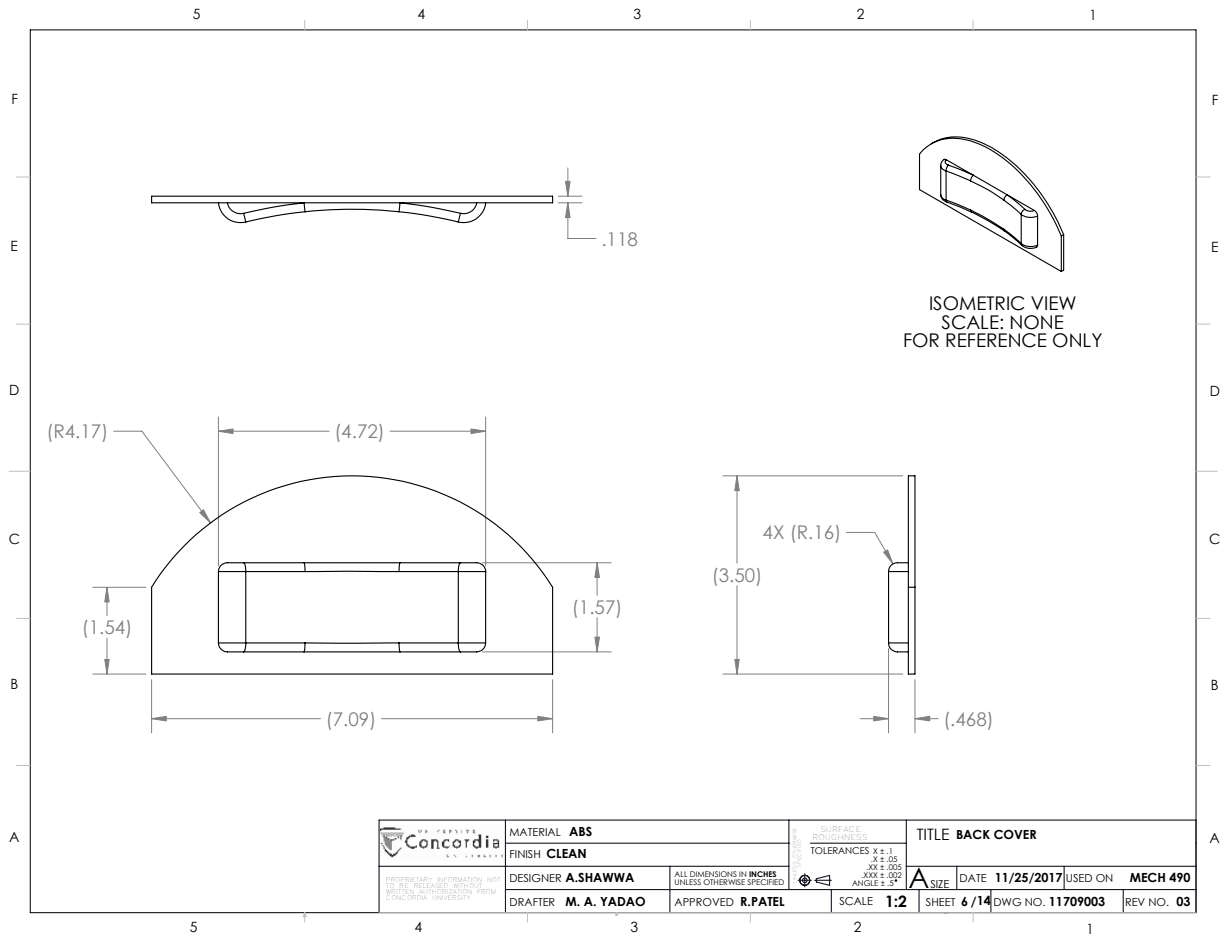
[picture p299: page 17]
M. A. YADAO; R.PATEL; PROPRIETARY INFORMATION NOT; A.SHAWWA TO BE RELEASED WITHOUT; CLEAN; ABS; UNLESS OTHERWISE; SPECIFIED; SURFACE ROUGHNESS; DWG NO.; FINISH; ASIZE; TOLERANCES X ± .1 .X ± .05 .XX ± .005 .XXX ± .002 ANGLE ± .5; DRAFTER; APPROVED; SCALE 1:2; BACK COVER; SHEET 6 /14; REV NO.; DATE 11/25/2017; MATERIAL; DESIGNER; TITLE

ISOMETRIC VIEW
SCALE: NONE
FOR REFERENCE ONLY

ALL DIMENSIONS IN INCHES
UNLESS OTHERWISE SPECIFIED

USED ON MECH 490

WRITTEN AUTHORIZATION FROM
CONCORDIA UNIVERSITY

3.35

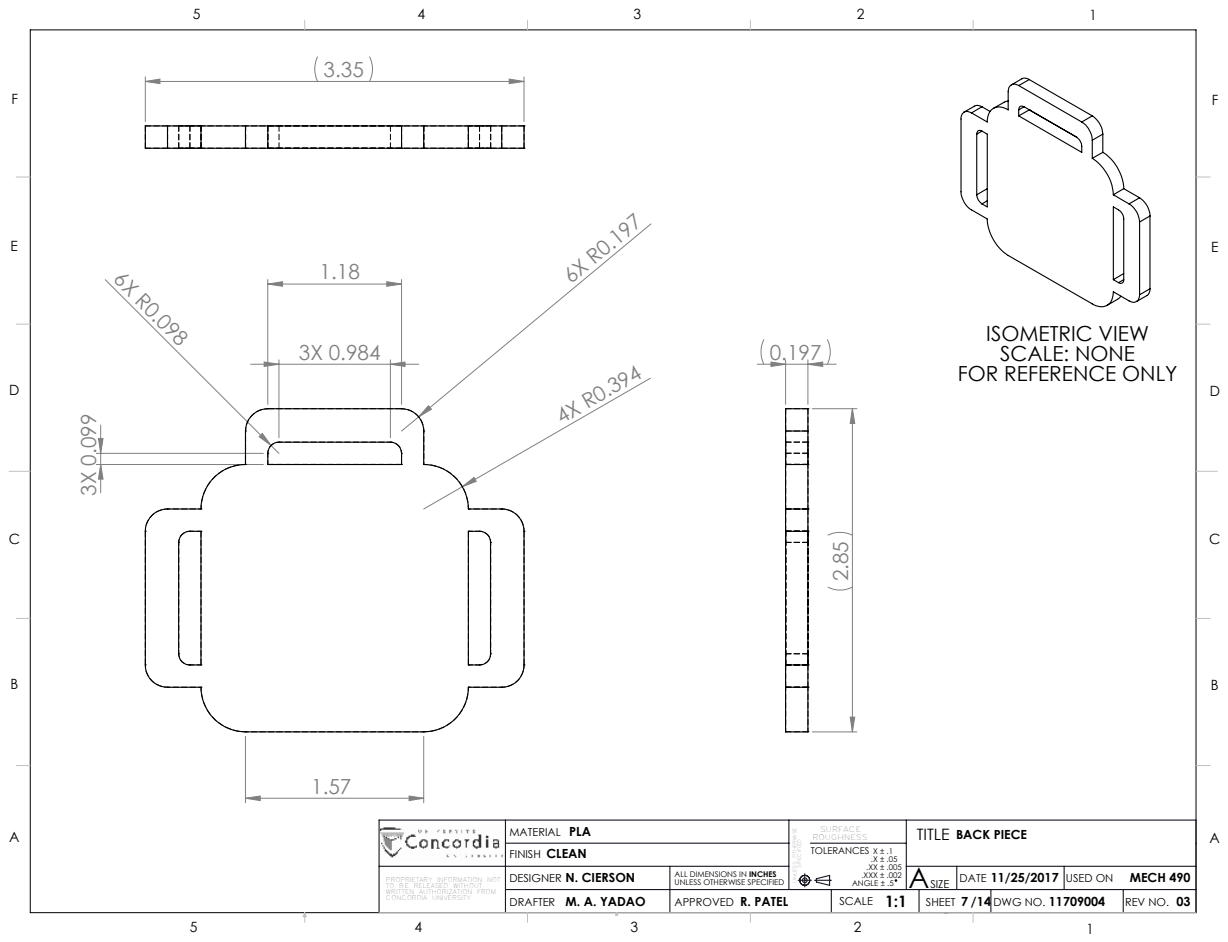
[picture p300: page 18]
M. A. YADAO; R. PATEL; PROPRIETARY INFORMATION NOT; N. CIERSON TO BE RELEASED WITHOUT; CLEAN; PLA; UNLESS OTHERWISE; SPECIFIED; SURFACE ROUGHNESS; DWG NO.; FINISH; ASIZE; TOLERANCES X ± .1 .X ± .05 .XX ± .005 .XXX ± .002 ANGLE ± .5; DRAFTER; APPROVED; SCALE 1:1; BACK PIECE; SHEET 7 /14; REV NO.; DATE 11/25/2017; MATERIAL; DESIGNER; TITLE

ISOMETRIC VIEW
SCALE: NONE
FOR REFERENCE ONLY

ALL DIMENSIONS IN INCHES
UNLESS OTHERWISE SPECIFIED

USED ON MECH 490

WRITTEN AUTHORIZATION FROM
CONCORDIA UNIVERSITY

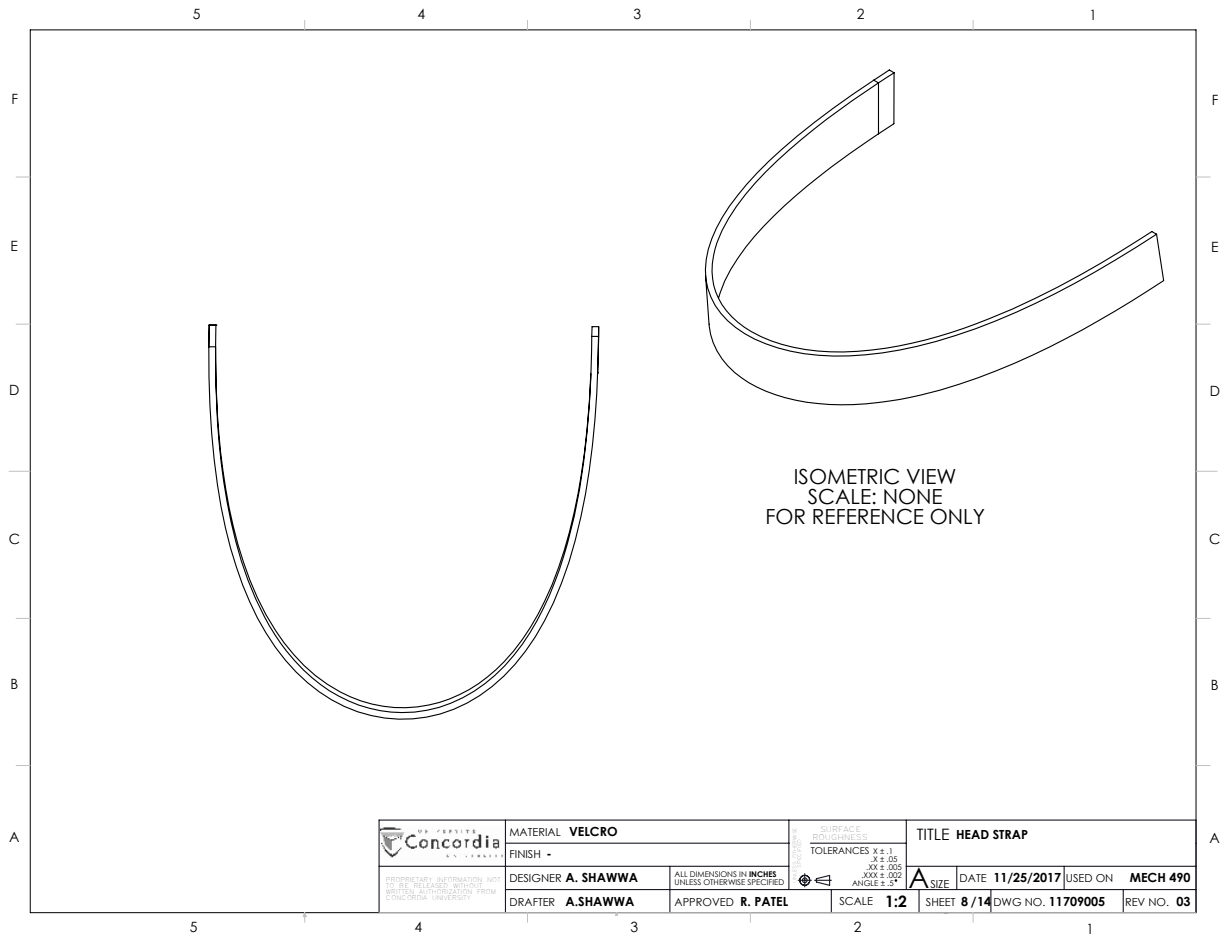
[picture p301: page 19]
A.SHAWWA; R. PATEL; PROPRIETARY INFORMATION NOT; A. SHAWWA TO BE RELEASED WITHOUT; VELCRO; UNLESS OTHERWISE; SPECIFIED; SURFACE ROUGHNESS; DWG NO.; FINISH; ASIZE; TOLERANCES X ± .1 .X ± .05 .XX ± .005 .XXX ± .002 ANGLE ± .5; DRAFTER; APPROVED; SCALE 1:2; HEAD STRAP; SHEET 8 /14; REV NO.; DATE 11/25/2017; MATERIAL; DESIGNER; TITLE

ISOMETRIC VIEW
SCALE: NONE
FOR REFERENCE ONLY

ALL DIMENSIONS IN INCHES
UNLESS OTHERWISE SPECIFIED

USED ON MECH 490

WRITTEN AUTHORIZATION FROM
CONCORDIA UNIVERSITY

.251

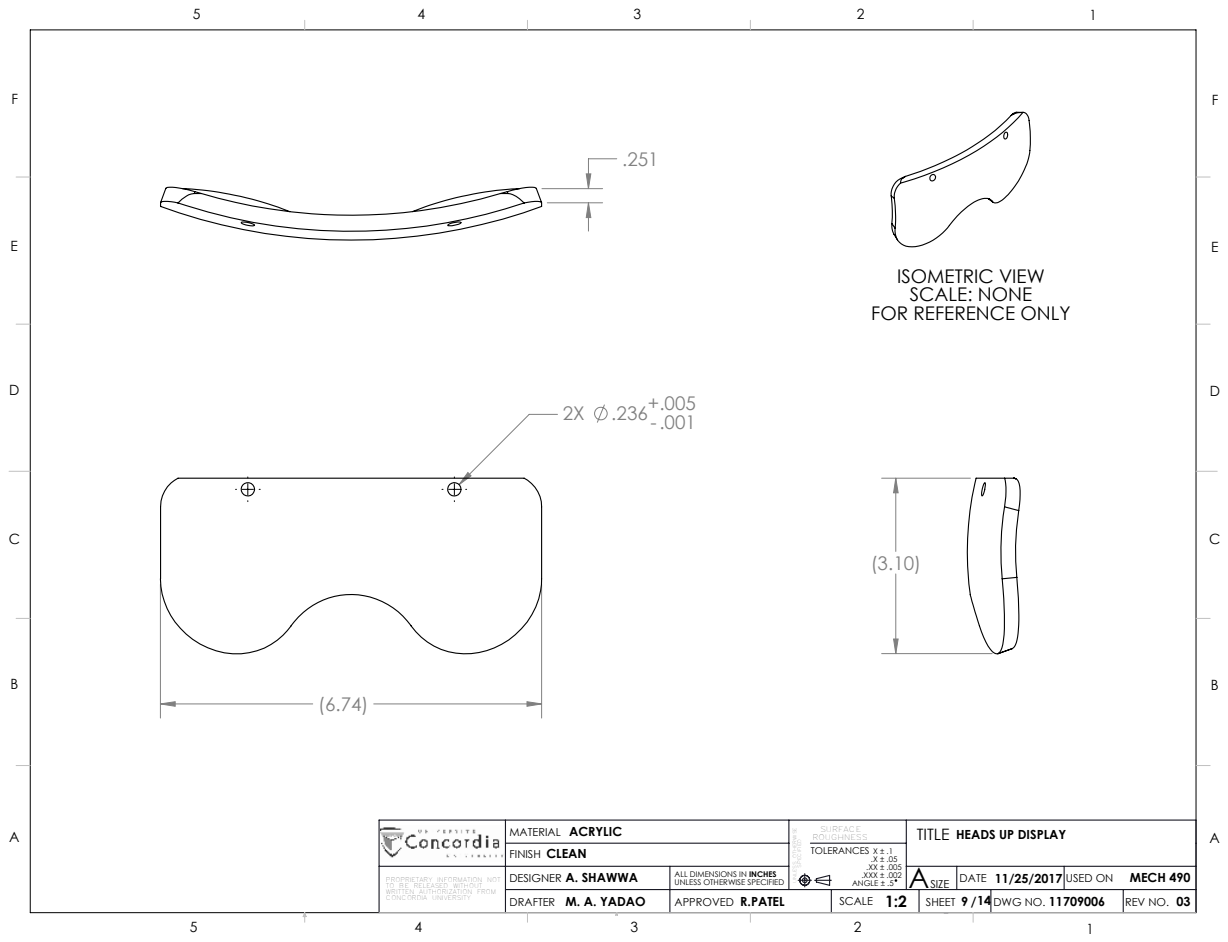
[picture p302: page 20]
M. A. YADAO; R.PATEL; PROPRIETARY INFORMATION NOT; A. SHAWWA TO BE RELEASED WITHOUT; CLEAN; ACRYLIC; UNLESS OTHERWISE; SPECIFIED; SURFACE ROUGHNESS; DWG NO.; FINISH; ASIZE; TOLERANCES X ± .1 .X ± .05 .XX ± .005 .XXX ± .002 ANGLE ± .5; DRAFTER; APPROVED; SCALE 1:2; SHEET 9 /14; REV NO.; DATE 11/25/2017; MATERIAL; DESIGNER

ISOMETRIC VIEW
SCALE: NONE
FOR REFERENCE ONLY

TITLE
HEADS UP DISPLAY

ALL DIMENSIONS IN INCHES
UNLESS OTHERWISE SPECIFIED

USED ON MECH 490

WRITTEN AUTHORIZATION FROM
CONCORDIA UNIVERSITY

(.706)

1.18

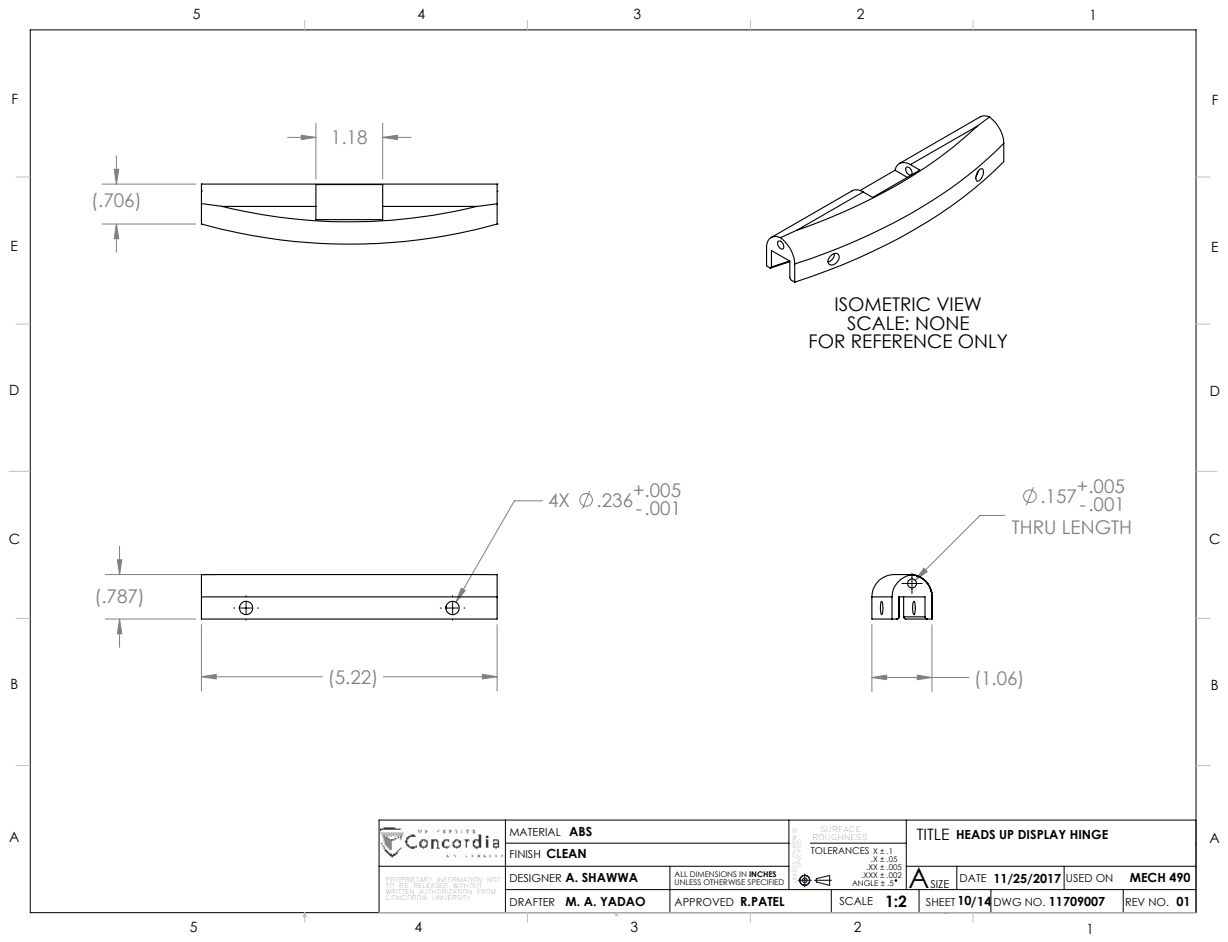
[picture p303: page 21]
.005 .001 THRU LENGTH; M. A. YADAO; R.PATEL; PROPRIETARY INFORMATION NOT; A. SHAWWA TO BE RELEASED WITHOUT; CLEAN; ABS; UNLESS OTHERWISE; SPECIFIED; SURFACE ROUGHNESS; DWG NO.; FINISH; ASIZE; TOLERANCES X ± .1 .X ± .05 .XX ± .005 .XXX ± .002 ANGLE ± .5; DRAFTER; APPROVED; SCALE 1:2; SHEET 10/14; REV NO.; DATE 11/25/2017; MATERIAL; DESIGNER

ISOMETRIC VIEW
SCALE: NONE
FOR REFERENCE ONLY

TITLE
HEADS UP DISPLAY HINGE

ALL DIMENSIONS IN INCHES
UNLESS OTHERWISE SPECIFIED

USED ON MECH 490

WRITTEN AUTHORIZATION FROM
CONCORDIA UNIVERSITY

4X .138+

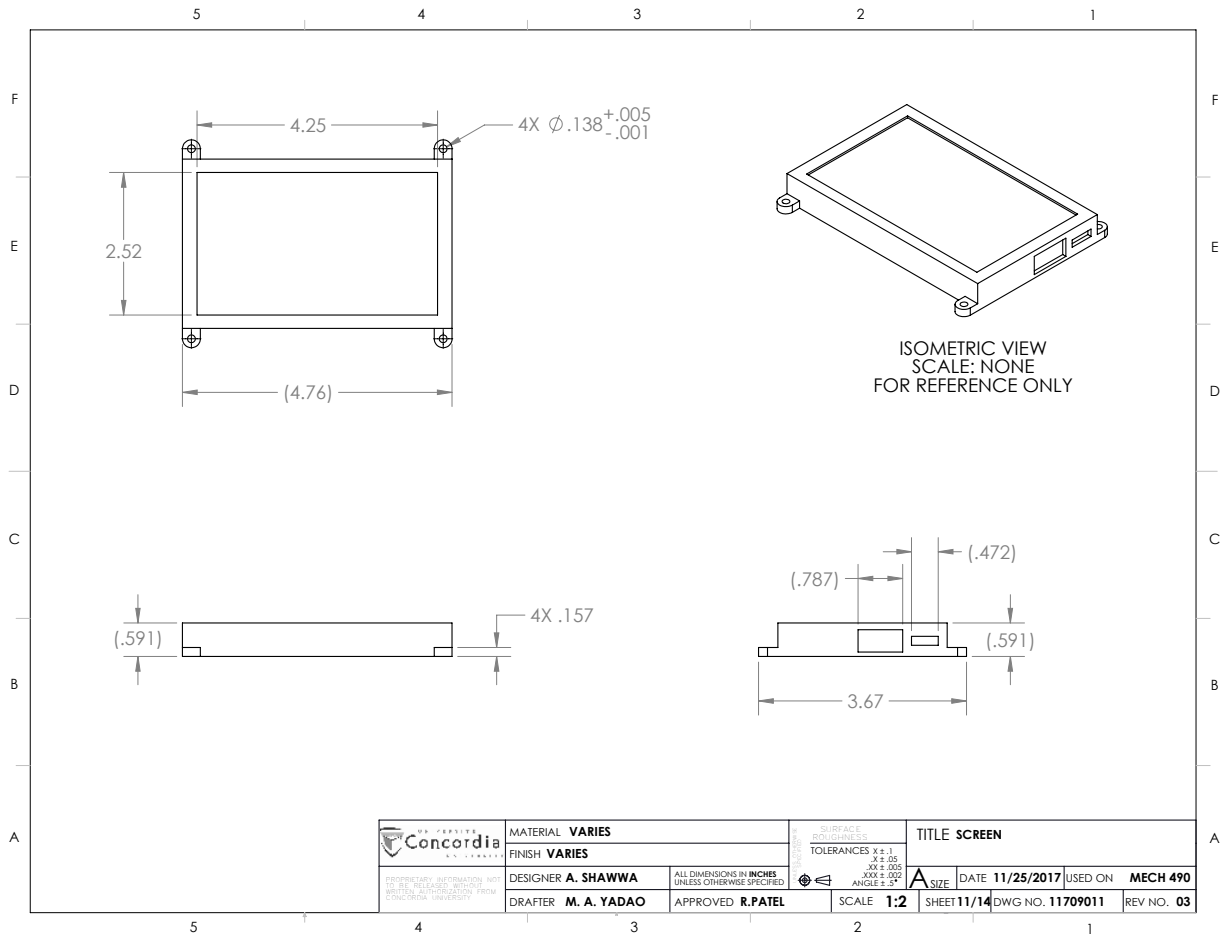
[picture p304: page 22]
M. A. YADAO; R.PATEL; PROPRIETARY INFORMATION NOT; A. SHAWWA TO BE RELEASED WITHOUT; VARIES; UNLESS OTHERWISE; SPECIFIED; SURFACE ROUGHNESS; DWG NO.; FINISH; ASIZE; TOLERANCES X ± .1 .X ± .05 .XX ± .005 .XXX ± .002 ANGLE ± .5; DRAFTER; APPROVED; SCALE 1:2; SCREEN; SHEET11/14; REV NO.; DATE 11/25/2017; MATERIAL; DESIGNER; TITLE

ISOMETRIC VIEW
SCALE: NONE
FOR REFERENCE ONLY

ALL DIMENSIONS IN INCHES
UNLESS OTHERWISE SPECIFIED

USED ON MECH 490

WRITTEN AUTHORIZATION FROM
CONCORDIA UNIVERSITY

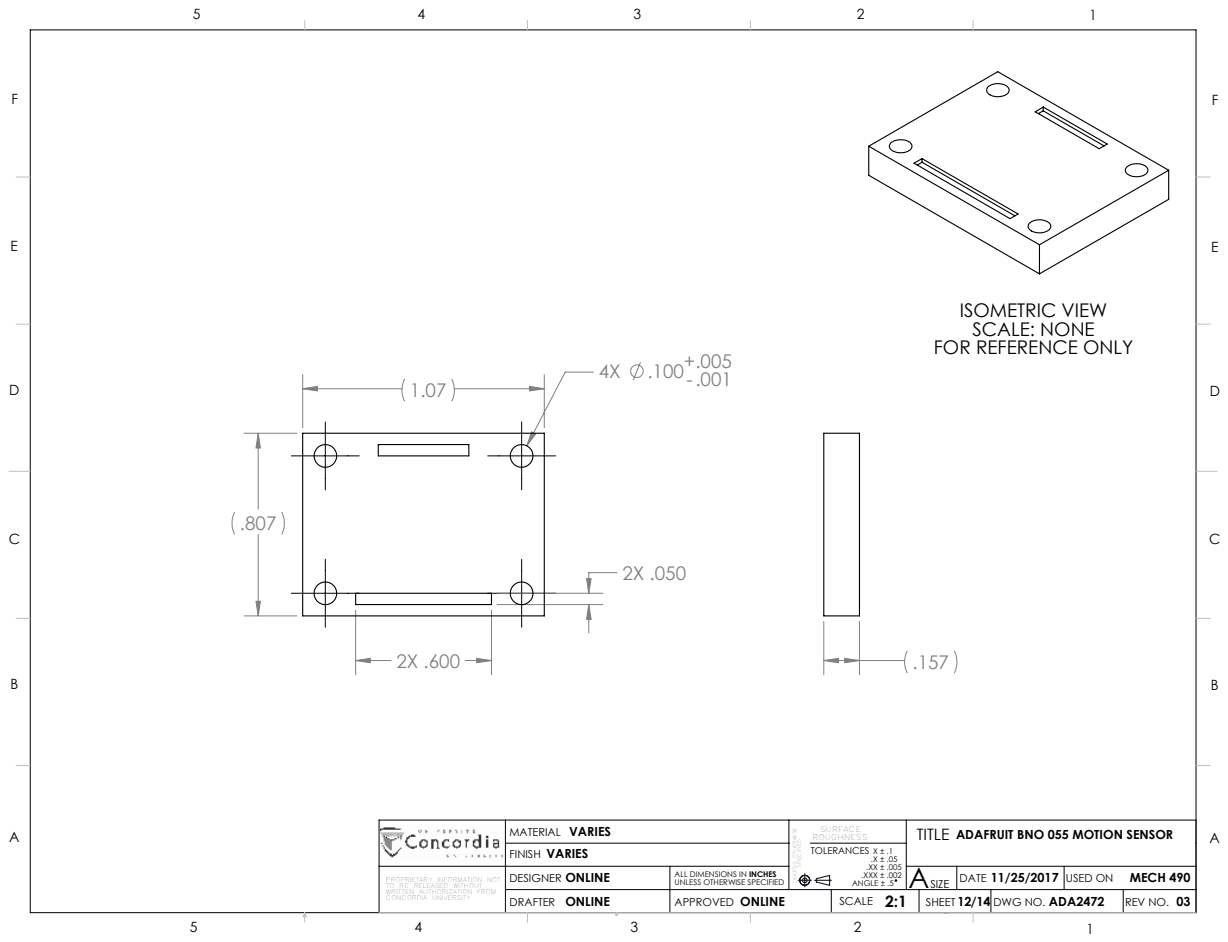
[picture p305: page 23]
ONLINE; ADA2472; PROPRIETARY INFORMATION NOT; ONLINE TO BE RELEASED WITHOUT; VARIES; UNLESS OTHERWISE; SPECIFIED; SURFACE ROUGHNESS; DWG NO.; FINISH; ASIZE; TOLERANCES X ± .1 .X ± .05 .XX ± .005 .XXX ± .002 ANGLE ± .5; DRAFTER; APPROVED; SCALE 2:1; SHEET 12/14; REV NO.; DATE 11/25/2017; MATERIAL; DESIGNER

ISOMETRIC VIEW
SCALE: NONE
FOR REFERENCE ONLY

TITLE
ADAFRUIT BNO 055 MOTION SENSOR

ALL DIMENSIONS IN INCHES
UNLESS OTHERWISE SPECIFIED

USED ON MECH 490

WRITTEN AUTHORIZATION FROM
CONCORDIA UNIVERSITY

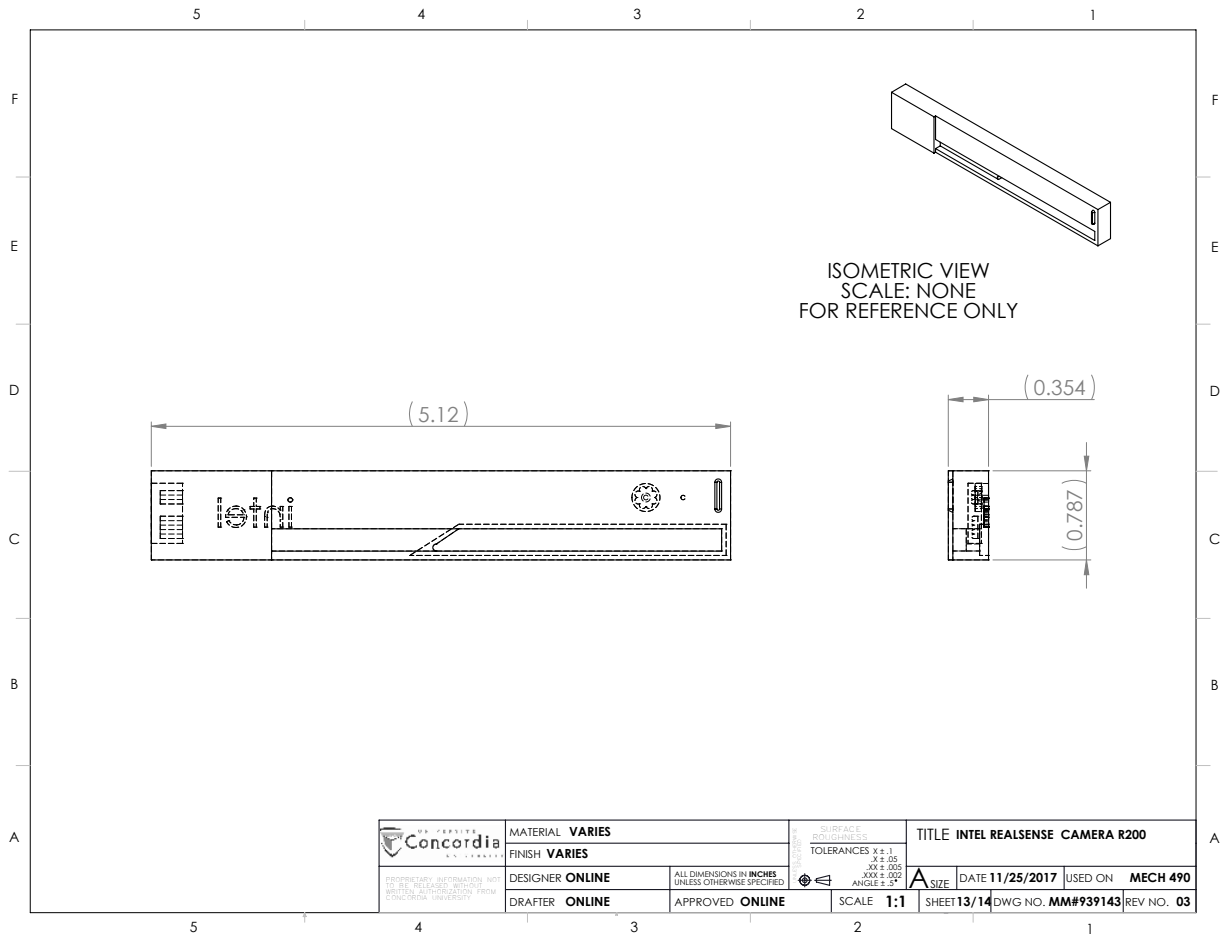
[picture p306: page 24]
ONLINE; PROPRIETARY INFORMATION NOT; ONLINE TO BE RELEASED WITHOUT; VARIES; UNLESS OTHERWISE; SPECIFIED; SURFACE ROUGHNESS; DWG NO.; FINISH; ASIZE; TOLERANCES X ± .1 .X ± .05 .XX ± .005 .XXX ± .002 ANGLE ± .5; DRAFTER; APPROVED; SCALE 1:1; SHEET13/14; REV NO.; DATE 11/25/2017; MATERIAL; DESIGNER

ISOMETRIC VIEW
SCALE: NONE
FOR REFERENCE ONLY

TITLE
INTEL REALSENSE CAMERA R200

ALL DIMENSIONS IN INCHES
UNLESS OTHERWISE SPECIFIED

USED ON MECH 490

WRITTEN AUTHORIZATION FROM
CONCORDIA UNIVERSITY

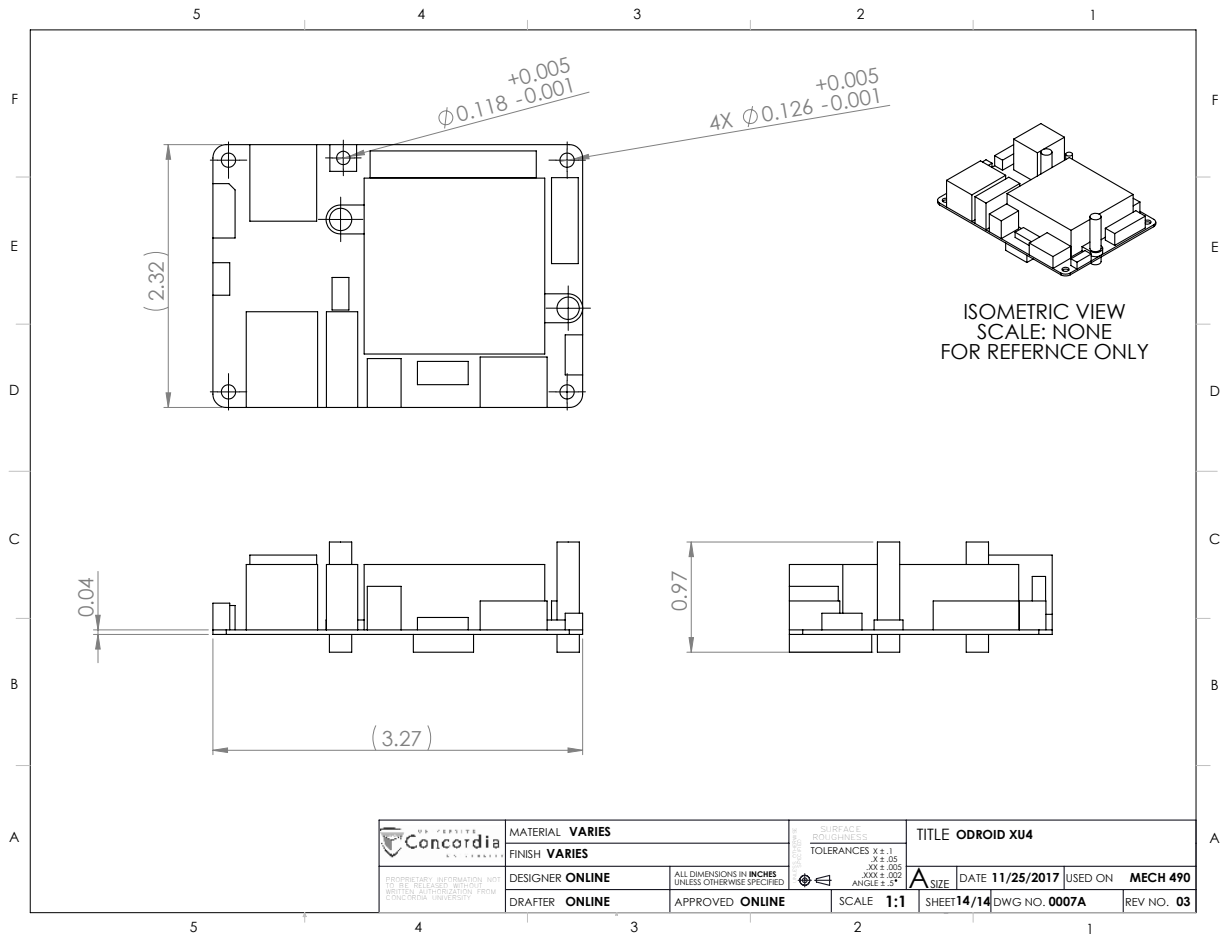
[picture p307: page 25]
ONLINE; PROPRIETARY INFORMATION NOT; ONLINE TO BE RELEASED WITHOUT; VARIES; UNLESS OTHERWISE; SPECIFIED; SURFACE ROUGHNESS; DWG NO.; FINISH; ASIZE; TOLERANCES X ± .1 .X ± .05 .XX ± .005 .XXX ± .002 ANGLE ± .5; DRAFTER; APPROVED; SCALE 1:1; ODROID XU4; SHEET14/14; REV NO.; DATE 11/25/2017; MATERIAL; DESIGNER; TITLE

ISOMETRIC VIEW
SCALE: NONE
FOR REFERNCE ONLY

ALL DIMENSIONS IN INCHES
UNLESS OTHERWISE SPECIFIED

USED ON MECH 490

WRITTEN AUTHORIZATION FROM
CONCORDIA UNIVERSITY

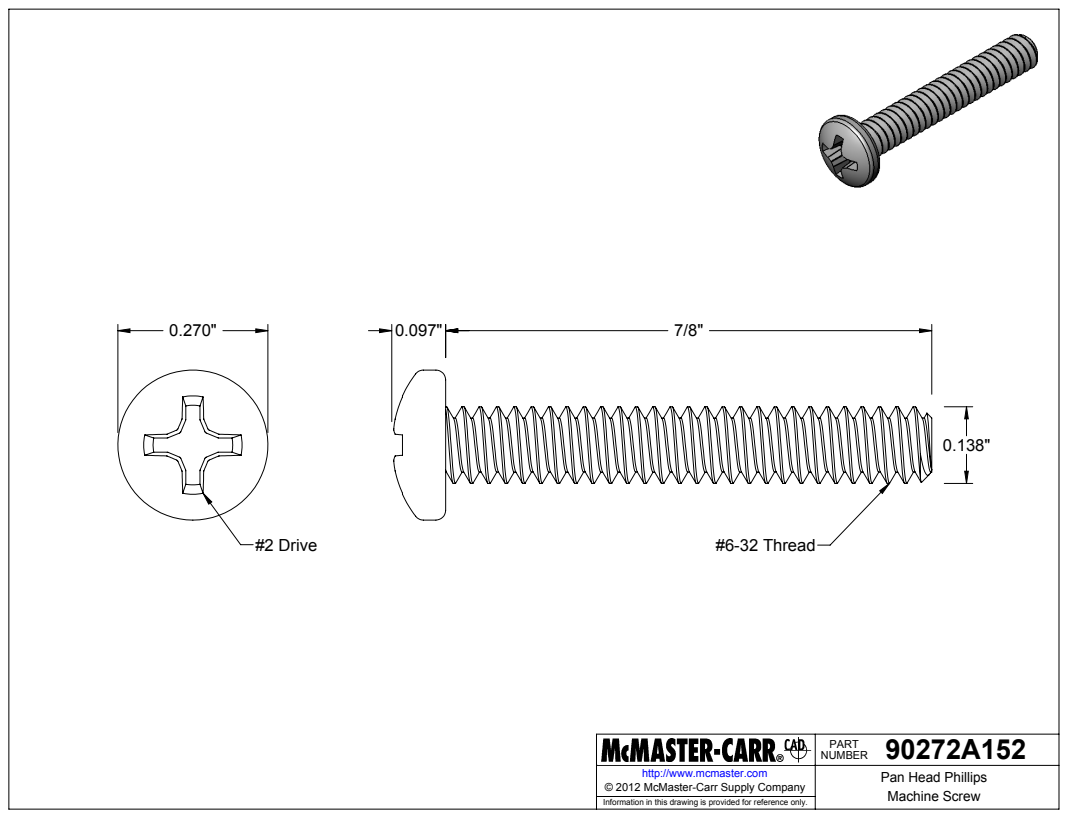
[picture p308: page 26]
#2 Drive; #6-32 Thread

90272A152 PART NUMBER

http://www.mcmaster.com | Pan Head Phillips Machine Screw © 2012 McMaster-Carr Supply Company

Information in this drawing is provided for reference only.

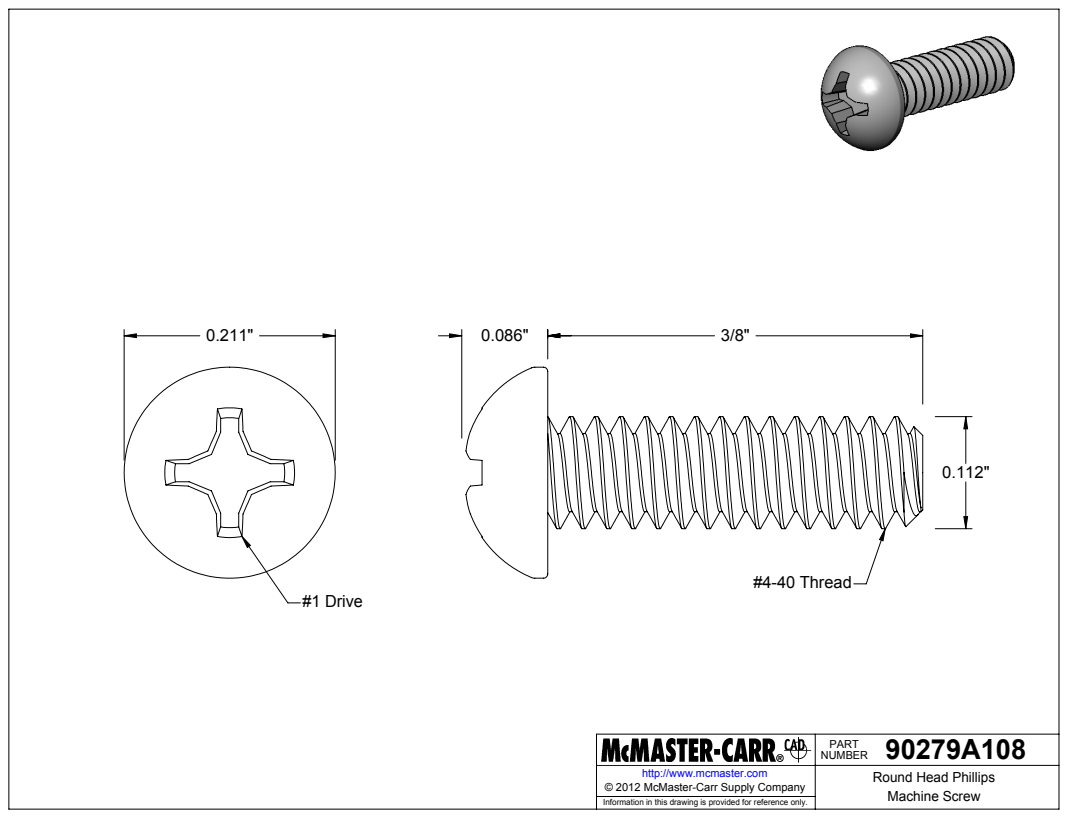
[picture p309: page 27]
#4-40 Thread; #1 Drive

90279A108 PART NUMBER

http://www.mcmaster.com | Round Head Phillips Machine Screw © 2012 McMaster-Carr Supply Company

Information in this drawing is provided for reference only.

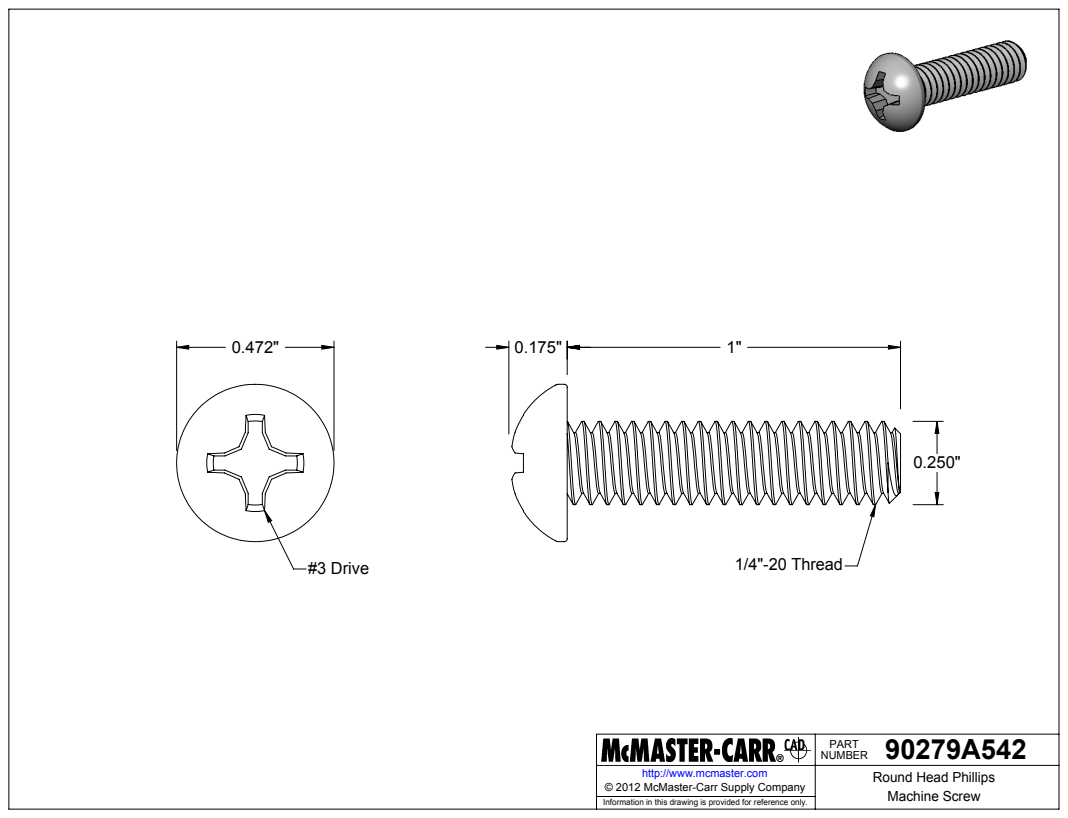
[picture p310: page 28]
1/4"-20 Thread; #3 Drive

90279A542 PART NUMBER

http://www.mcmaster.com | Round Head Phillips Machine Screw © 2012 McMaster-Carr Supply Company

Information in this drawing is provided for reference only.

## #4-40 Thread

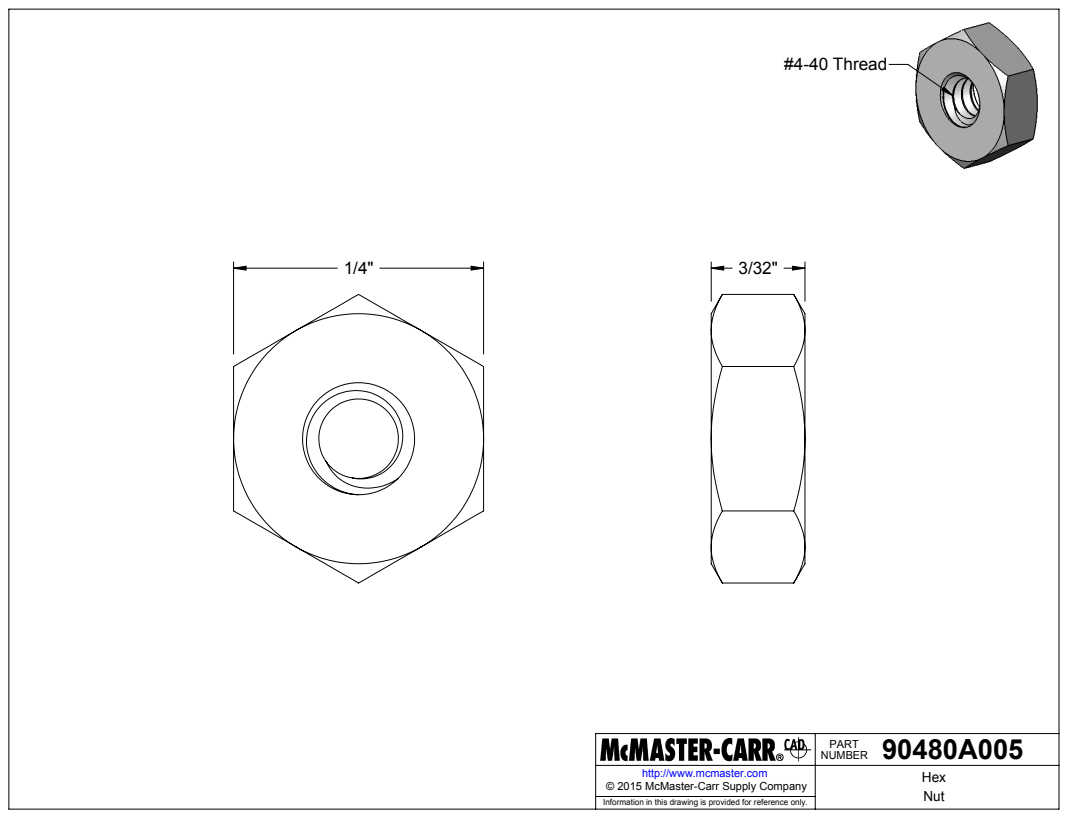
[picture p311: page 29]

90480A005 PART NUMBER

http://www.mcmaster.com | Hex Nut © 2015 McMaster-Carr Supply Company

Information in this drawing is provided for reference only.

## #6-32 Thread


90480A007 PART NUMBER

http://www.mcmaster.com | Hex Nut © 2015 McMaster-Carr Supply Company

Information in this drawing is provided for reference only.

## #6-32 Thread

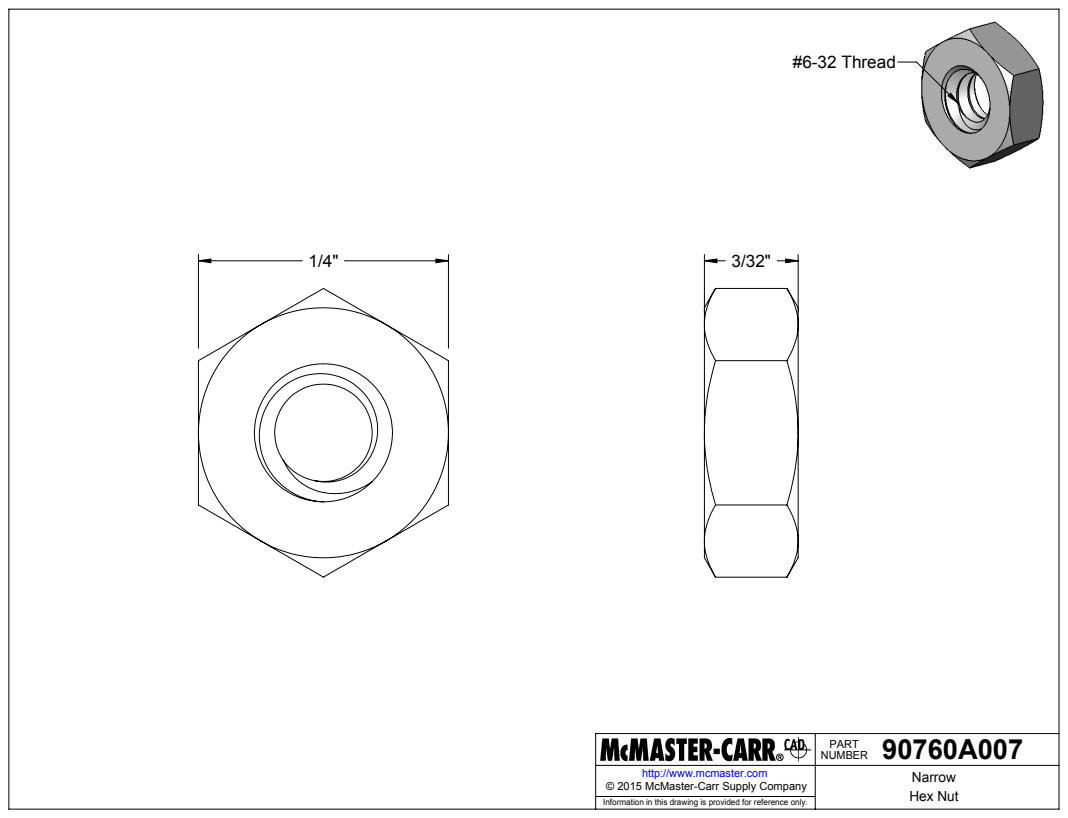
[picture p312: page 31]

90760A007 PART NUMBER

http://www.mcmaster.com | Narrow Hex Nut © 2015 McMaster-Carr Supply Company

Information in this drawing is provided for reference only.

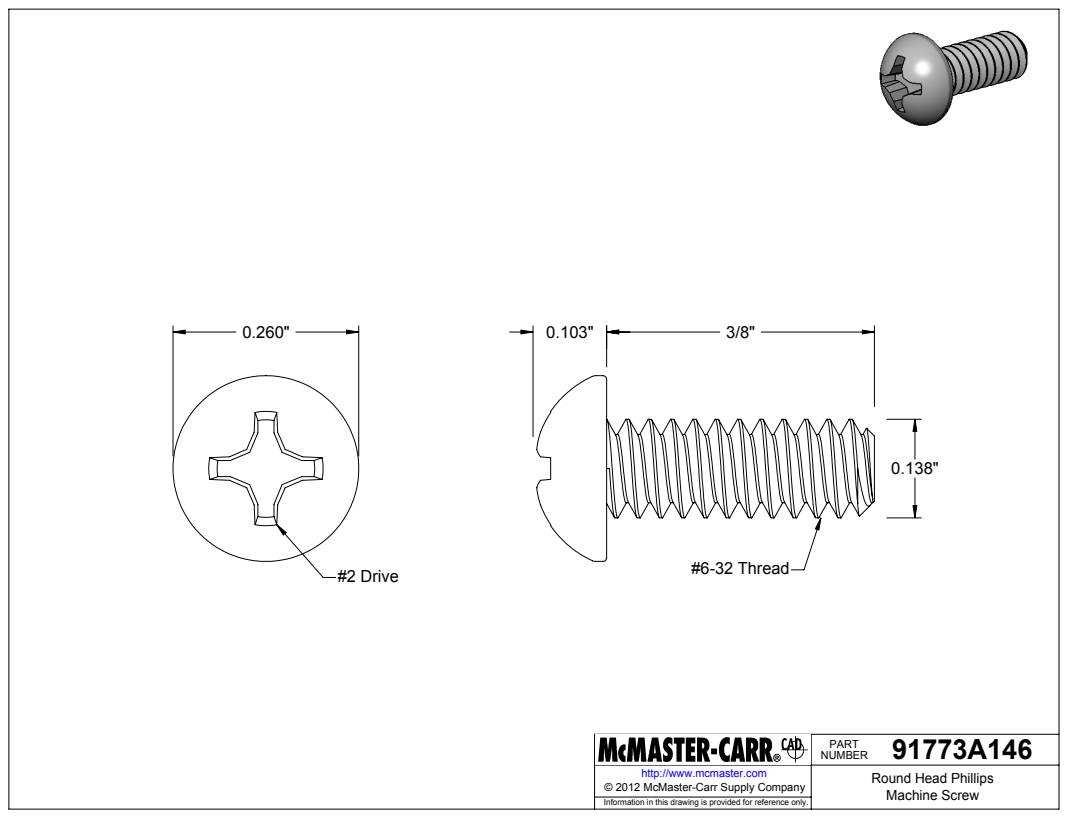
[picture p313: page 32]
#6-32 Thread; #2 Drive

91773A146 PART NUMBER

http://www.mcmaster.com | Round Head Phillips Machine Screw © 2012 McMaster-Carr Supply Company

Information in this drawing is provided for reference only.

## 1/4"-20 Thread 1/4" Thread Depth

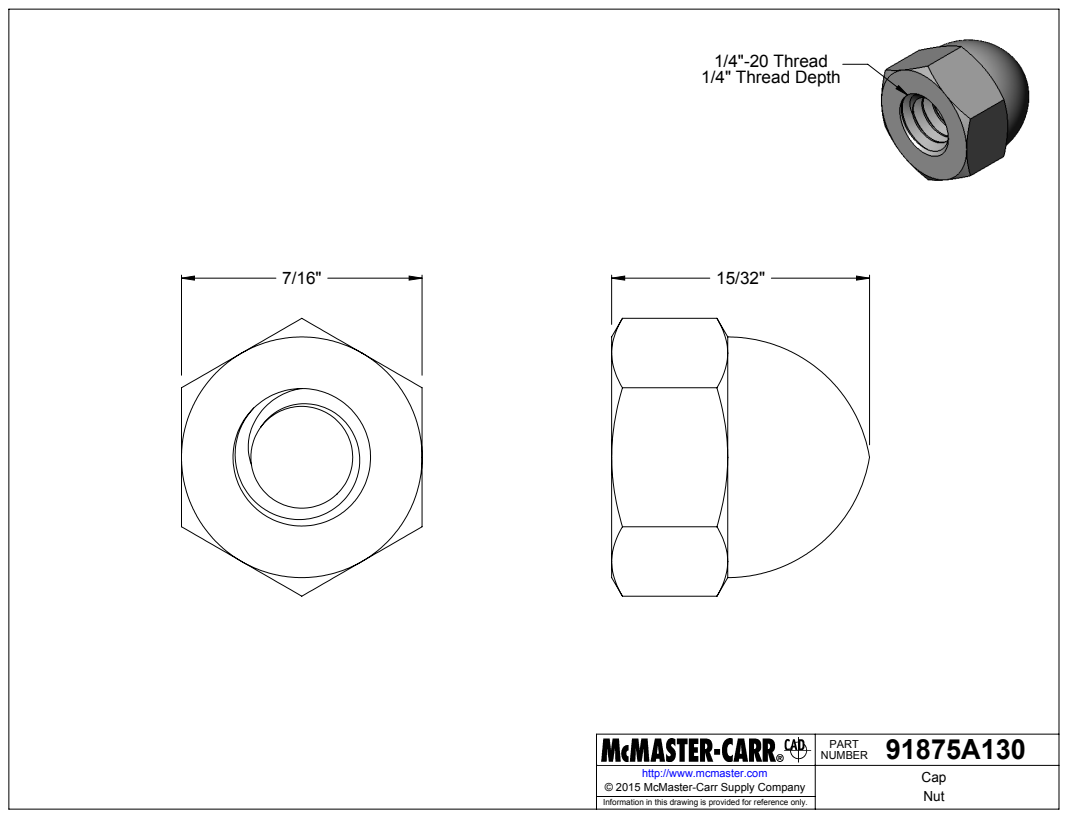
[picture p314: page 33]

91875A130 PART NUMBER

http://www.mcmaster.com | Cap Nut © 2015 McMaster-Carr Supply Company

Information in this drawing is provided for reference only.

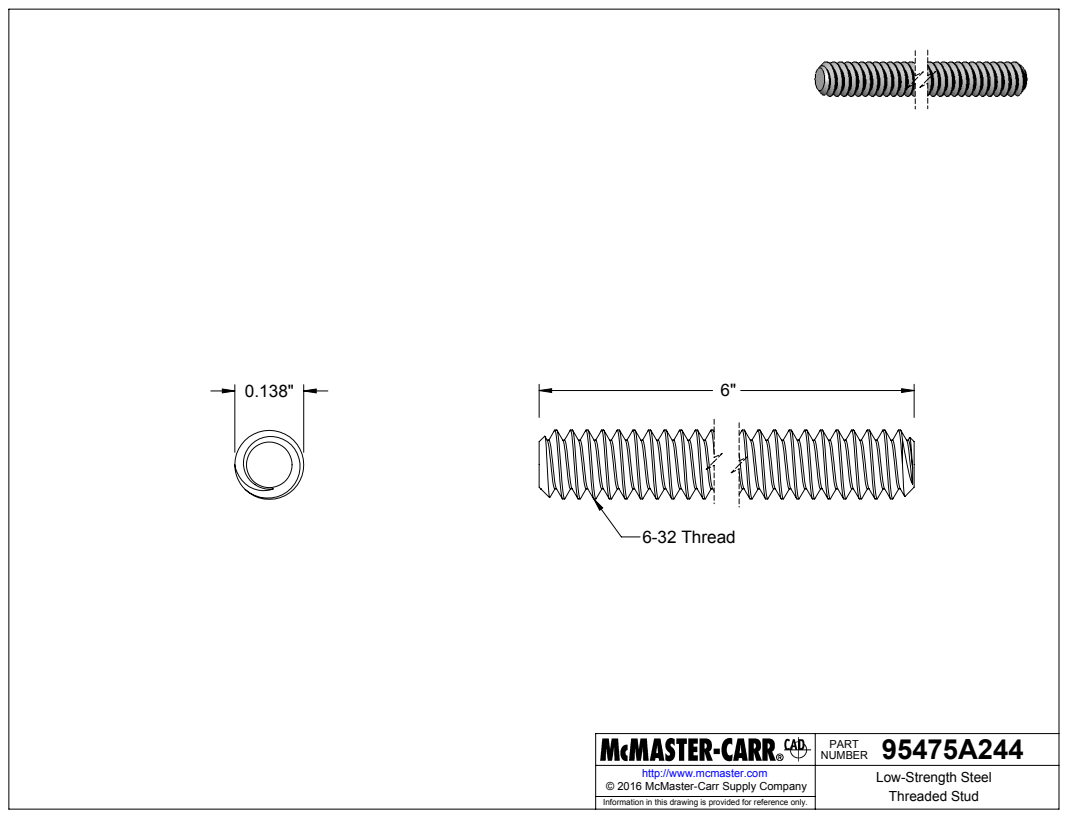
[picture p315: page 34]
6-32 Thread

95475A244 PART NUMBER

http://www.mcmaster.com | Low-Strength Steel Threaded Stud © 2016 McMaster-Carr Supply Company

Information in this drawing is provided for reference only.

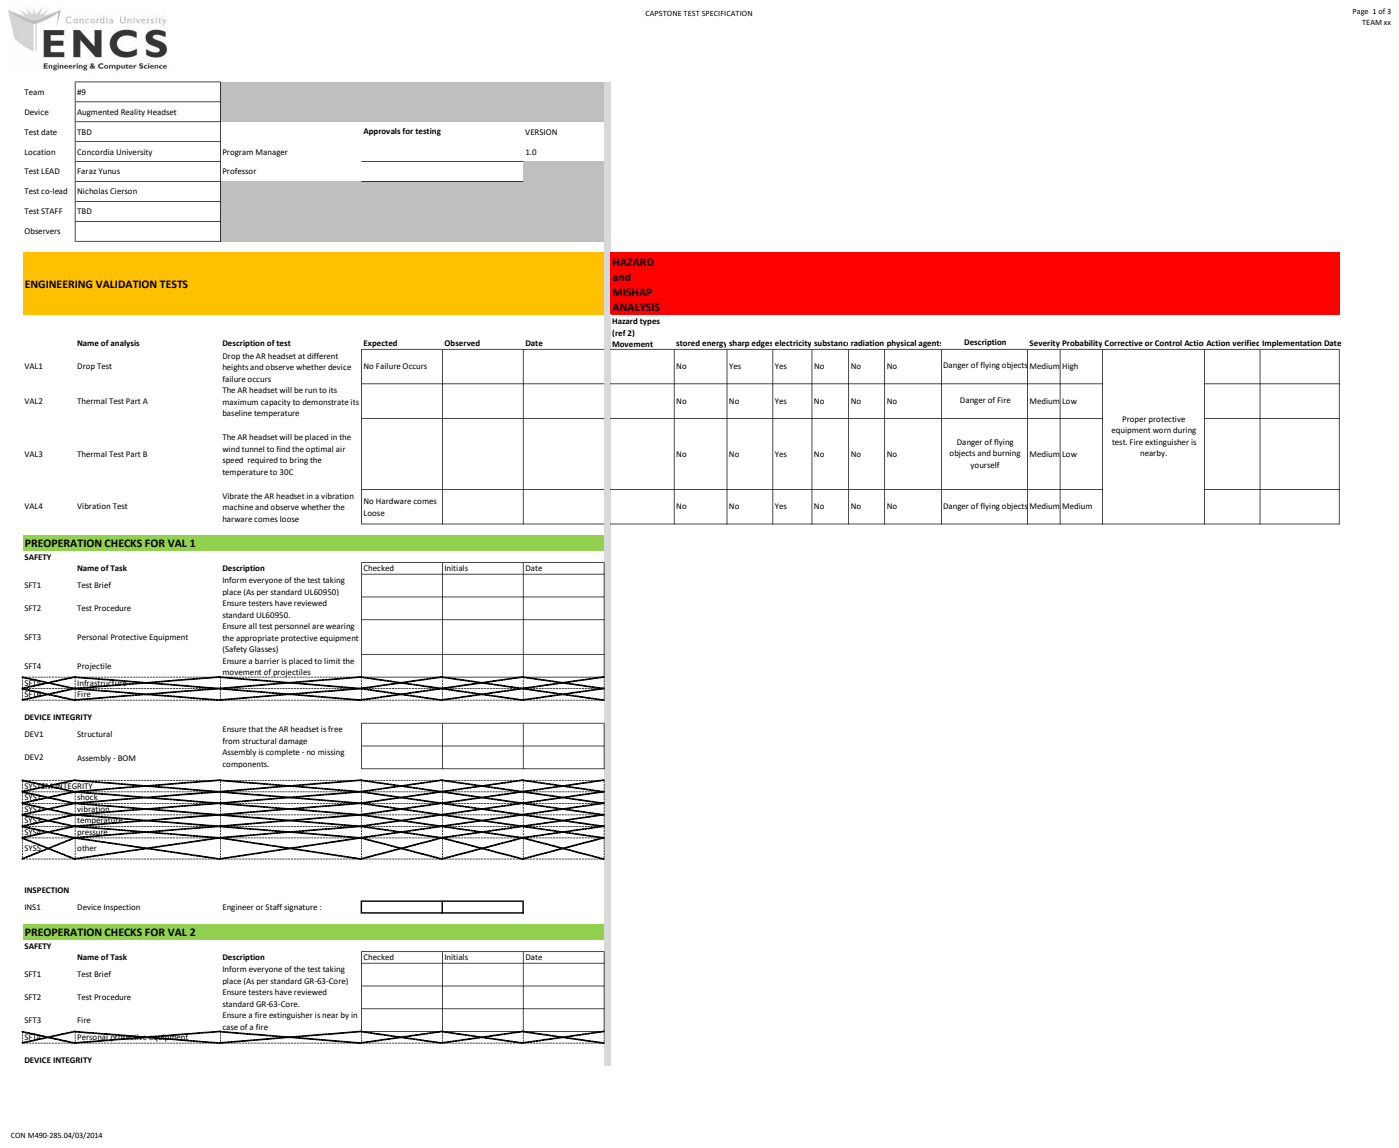
[picture p316: page 35]
CAPSTONE TEST SPECIFICATION; Page 1 of 3; TEAM xx; Team; Device; Augmented Reality Headset; Test date; TBD; VERSION; Location; Concordia University; Program Manager; Test LEAD; Faraz Yunus; Professor; Test STAFF; HAZARD and MISHAP ANALYSIS Hazard types (ref 2); Name of analysis; Description of test; Expected; Observed; Date; Movement; stored energy sharp edges electricity substancesradiation physical agents; Severity Probability Corrective or Control ActionAction verified Implementation Date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

Test co-lead Nicholas Cierson
Observers

Approvals for testing

ENGINEERING VALIDATION TESTS

Drop the AR headset at different
heights and observe whether device
failure occurs
The AR headset will be run to its
maximum capacity to demonstrate its
baseline temperature

Danger of flying objects

Danger of Fire

Proper protective
equipment worn during
test. Fire extinguisher is
nearby.

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

Danger of flying
objects and burning
yourself

Vibrate the AR headset in a vibration
machine and observe whether the
harware comes loose

No Hardware comes
Loose

PREOPERATION CHECKS FOR VAL 1
SAFETY

place (As per standard UL60950)

standard UL60950.
Ensure all test personnel are wearing
the appropriate protective equipment
(Safety Glasses)

movement of projectiles

from structural damage

INSPECTION
PREOPERATION CHECKS FOR VAL 2

place (As per standard GR-63-Core)

standard GR-63-Core.

case of a fire

CAPSTONE TEST SPECIFICATION | Page 2 of 3 TEAM xx
DEV1 | Structural | Ensure that the AR headset is free
from structural damage
DEV2 | Assembly - BOM | Assembly is complete - no missing
components.

SYSTEM INTEGRITY
SYS1 | Temperature | Ensure a thermocouple is placed
inside of the AR headset
SYS2 | vibration
SYS3 | shock
SYS4 | pressure
SYS5 | other

INSPECTION
INS1 | Device Inspection | Engineer or Staff signature :
PREOPERATION CHECKS FOR VAL 3
SAFETY
Name of Task | Description | Checked | Initials | Date
SFT1 | Test Brief | Inform everyone of the test taking
| place (As per standard JESD 51-6 )
SFT2 | Test Procedure | Ensure testers have reviewed
| standard JESD 51-6
SFT3 | Fire
SFT4 | Personal protective equipment

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

SYSTEM INTEGRITY
SYS1 | Temperature | Ensure a thermocouple is placed
| inside of the AR headset
SYS2 | Wind Tunnel | Ensure that the Wind tunnel is
| working
SYS3 | Kill Switch
| Ensure that the kill switch for the wind tunnel is free of obstruction and operational. TEST
SYS4 | vibration
SYS5 | shock
SYS6 | pressure
SYS7 | other

INSPECTION
INS1 | Device Inspection | Engineer or Staff signature :
PREOPERATION CHECKS FOR VAL 4 | | Checked | Initials | Date
SAFETY
Name of Task | Description
SFT1 | Test Brief | Inform everyone of the test taking
| place
SFT2 | Personal protective equipment
| Ensure all test personnel are wearing the appropriate protective equipment (Safety Glasses)
SFT3 | Fire

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

INSPECTION
INS1 | Device Inspection | Engineer or Staff signature :

CON M490-285.04/03/2014

CAPSTONE TEST SPECIFICATION | Page 3 of 3 TEAM xx
PRE-TEST | Checked | Initials | Date
Objective | Description of Test
OPS1 | Baseline Temperature

Bring the AR headset to its baseline temperature, required for "Thermal Test Part B"
References

### 1 MIL-STD-882D 2 Safey with Machinery, John Ridley and Dick Pearce, 2006

CON M490-285.04/03/2014
