cbkiyanda/AR/Documents/Capstone 2017-18/Design Proposal and Feasibility Study/3 Headset.PDF

4X 3.20 THRU; SECTION A-A SCALE 1 : 2; M. A. YADAO; R. PATEL; PROPRIETARY INFORMATION NOT; A. SHAWWA TO BE RELEASED WITHOUT WRITTEN; UNLESS OTHERWISE; SURFACE ROUGHNESS; DWG NO.; TOLERANCES X ± .1 .X ± .05 .XX ± .005 .XXX ± .002 ANGLE ± .5; DRAFTER; APPROVED; SCALE 1:2; SHEET 1 / 1; REV NO.; DATE 10/8/2017

POLYLACTIC ACID (PLA - 3D PRINT)
FINISH
DESIGNER

SOLIDWORKS Educational Product. For Instructional Use Only.

ALL DIMENSIONS IN METRIC
UNLESS OTHERWISE SPECIFIED

USED ON MECH 490

AUTHORIZATION FROM CONCORDIA
UNIVERSITY
