cbkiyanda/AR/Documents/Capstone 2017-18/Engineering Drawings/V5/V5 FINAL Assembly _Report/FINAL DRAWINGS/FINAL PDF/2.PDF

M. A. YADAO; R. PATEL; PROPRIETARY INFORMATION NOT; A. SHAWWA TO BE RELEASED WITHOUT; UNLESS OTHERWISE; DWG NO.; TOLERANCES X ± .1 .X ± .05 .XX ± .005 .XXX ± .002 ANGLE ± .5; DRAFTER; APPROVED; SCALE 1:4; SHEET 4 /12; REV NO.; DATE 3/19/2018

ISOMETRIC VIEW
SCALE: NONE
FOR REFERENCE ONLY

ALL DIMENSIONS IN INCHES
UNLESS OTHERWISE SPECIFIED

USED ON MECH 490

WRITTEN AUTHORIZATION FROM
CONCORDIA UNIVERSITY

SECTION A-A; M. A. YADAO; R. PATEL; PROPRIETARY INFORMATION NOT; A. SHAWWA TO BE RELEASED WITHOUT; UNLESS OTHERWISE; DWG NO.; TOLERANCES X ± .1 .X ± .05 .XX ± .005 .XXX ± .002 ANGLE ± .5; DRAFTER; APPROVED; SCALE 1:4; SHEET 5 /12; REV NO.; DATE 3/19/2018

ISOMETRIC VIEW
SCALE: NONE
FOR REFERENCE ONLY

ALL DIMENSIONS IN INCHES
UNLESS OTHERWISE SPECIFIED

USED ON MECH 490

WRITTEN AUTHORIZATION FROM
CONCORDIA UNIVERSITY
