cbkiyanda/AR/Documents/Capstone 2017-18/Engineering Drawings/V4/DRAWINGS/PDF/11809302-303_Assembly V4_UPDATED.PDF

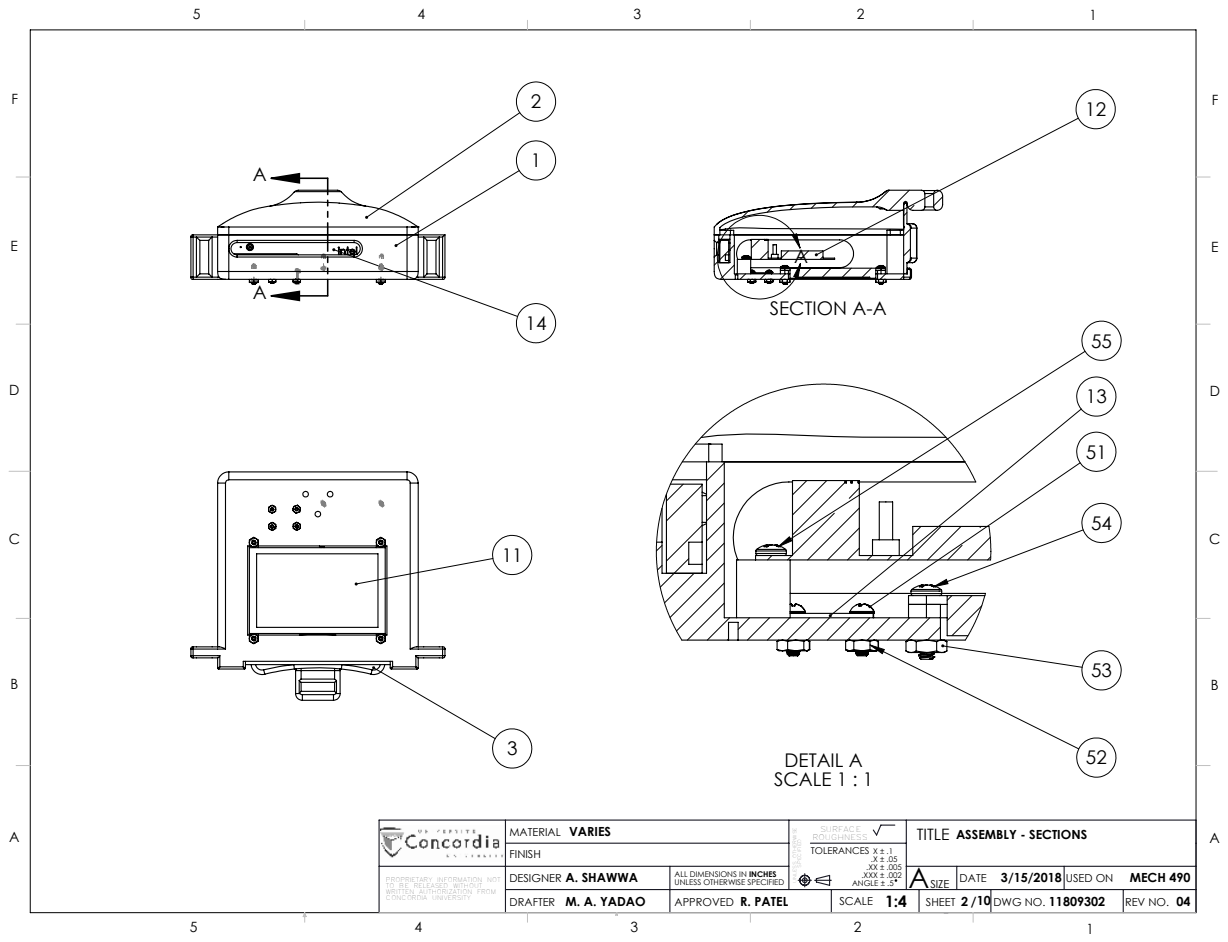
[picture p317: page 1]
SECTION A-A; DETAIL A SCALE 1 : 1; M. A. YADAO; R. PATEL; PROPRIETARY INFORMATION NOT; A. SHAWWA TO BE RELEASED WITHOUT; UNLESS OTHERWISE; DWG NO.; TOLERANCES X ± .1 .X ± .05 .XX ± .005 .XXX ± .002 ANGLE ± .5; DRAFTER; APPROVED; SCALE 1:4; ASSEMBLY - SECTIONS; SHEET 2 /10; REV NO.; DATE 3/15/2018

ALL DIMENSIONS IN INCHES
UNLESS OTHERWISE SPECIFIED

USED ON MECH 490

WRITTEN AUTHORIZATION FROM
CONCORDIA UNIVERSITY

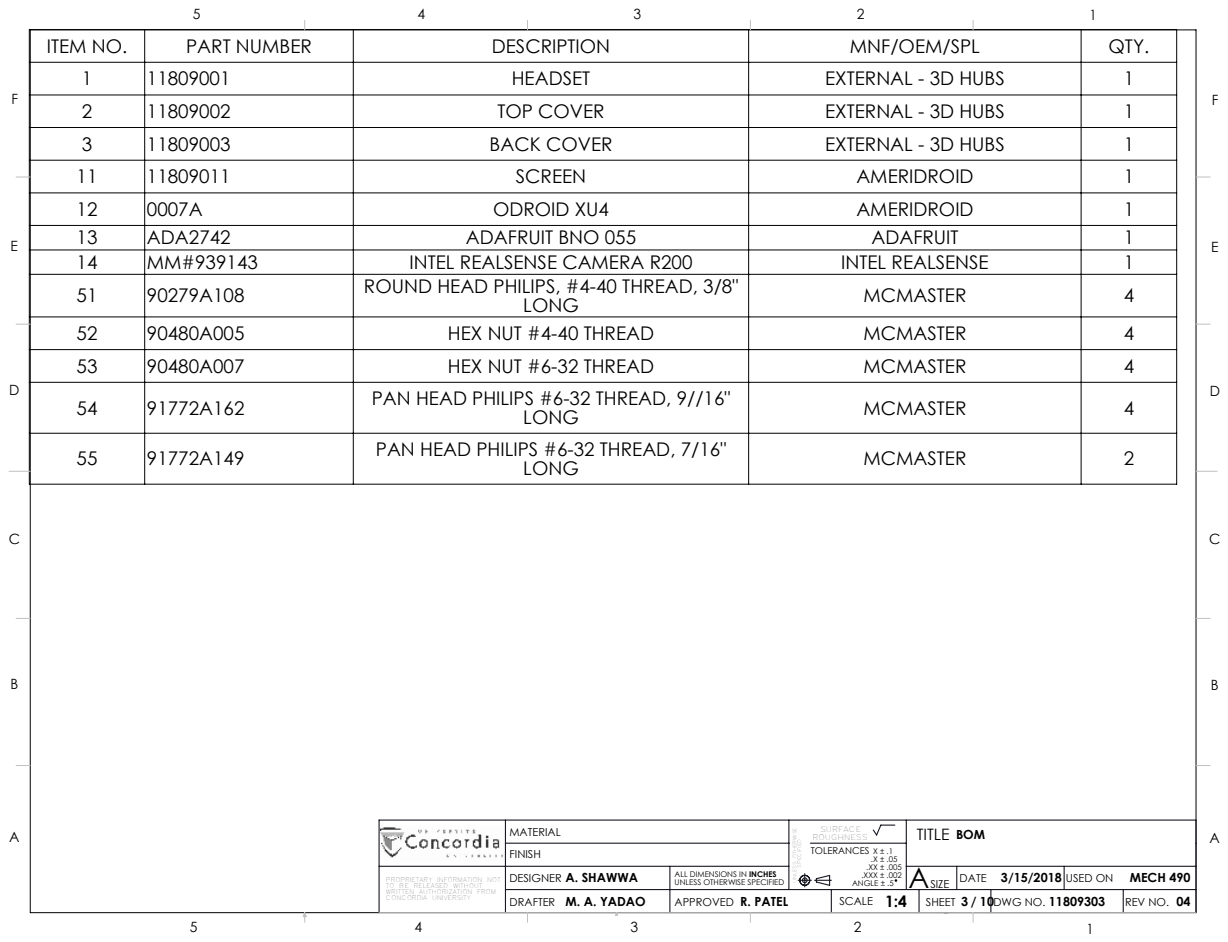
[picture p318: page 2]
M. A. YADAO; R. PATEL; PROPRIETARY INFORMATION NOT; A. SHAWWA TO BE RELEASED WITHOUT; UNLESS OTHERWISE; DWG NO.; TOLERANCES X ± .1 .X ± .05 .XX ± .005 .XXX ± .002 ANGLE ± .5; DRAFTER; APPROVED; SCALE 1:4; SHEET 3 / 10; REV NO.; DATE 3/15/2018

ITEM NO. | PART NUMBER | DESCRIPTION | MNF/OEM/SPL | QTY.
1 | 11809001 | HEADSET | EXTERNAL - 3D HUBS | 1
2 | 11809002 | TOP COVER | EXTERNAL - 3D HUBS | 1
3 | 11809003 | BACK COVER | EXTERNAL - 3D HUBS | 1
11 | 11809011 | SCREEN | AMERIDROID | 1
12 | 0007A | ODROID XU4 | AMERIDROID | 1
13 | ADA2742 | ADAFRUIT BNO 055 | ADAFRUIT | 1
14 | MM#939143 | INTEL REALSENSE CAMERA R200 | INTEL REALSENSE | 1
51 | 90279A108 | ROUND HEAD PHILIPS, #4-40 THREAD, 3/8" LONG | MCMASTER | 4
52 | 90480A005 | HEX NUT #4-40 THREAD | MCMASTER | 4
53 | 90480A007 | HEX NUT #6-32 THREAD | MCMASTER | 4
54 | 91772A162 | PAN HEAD PHILIPS #6-32 THREAD, 9//16" LONG | MCMASTER | 4

55 | 91772A149 | PAN HEAD PHILIPS #6-32 THREAD, 7/16" LONG | MCMASTER | 2

ALL DIMENSIONS IN INCHES
UNLESS OTHERWISE SPECIFIED

USED ON MECH 490

WRITTEN AUTHORIZATION FROM
CONCORDIA UNIVERSITY
