cbkiyanda/AR/BNO055.py

#The MIT License (MIT)
#
#Copyright (c) 2015 Gaurav Hirlekar

#Permission is hereby granted, free of charge, to any person obtaining a copy
#of this software and associated documentation files (the "Software"), to deal
#in the Software without restriction, including without limitation the rights
#to use, copy, modify, merge, publish, distribute, sublicense, and/or sell
#copies of the Software, and to permit persons to whom the Software is
#furnished to do so, subject to the following conditions:

#The above copyright notice and this permission notice shall be included in all
#copies or substantial portions of the Software.

#THE SOFTWARE IS PROVIDED "AS IS", WITHOUT WARRANTY OF ANY KIND, EXPRESS OR
#IMPLIED, INCLUDING BUT NOT LIMITED TO THE WARRANTIES OF MERCHANTABILITY,
#FITNESS FOR A PARTICULAR PURPOSE AND NONINFRINGEMENT. IN NO EVENT SHALL THE
#AUTHORS OR COPYRIGHT HOLDERS BE LIABLE FOR ANY CLAIM, DAMAGES OR OTHER
#LIABILITY, WHETHER IN AN ACTION OF CONTRACT, TORT OR OTHERWISE, ARISING FROM,
#OUT OF OR IN CONNECTION WITH THE SOFTWARE OR THE USE OR OTHER DEALINGS IN THE
#SOFTWARE.
#

import smbus
import time
import struct

class BNO055:
	BNO055_ADDRESS_A 				= 0x28
	BNO055_ADDRESS_B 				= 0x29
	BNO055_ID 		 			= 0xA0

	# Power mode settings
	POWER_MODE_NORMAL   				= 0X00
	POWER_MODE_LOWPOWER 				= 0X01
	POWER_MODE_SUSPEND  				= 0X02

	# Operation mode settings
	OPERATION_MODE_CONFIG 				= 0X00
	OPERATION_MODE_ACCONLY 				= 0X01
	OPERATION_MODE_MAGONLY 				= 0X02
	OPERATION_MODE_GYRONLY 				= 0X03
	OPERATION_MODE_ACCMAG 				= 0X04
	OPERATION_MODE_ACCGYRO 				= 0X05
	OPERATION_MODE_MAGGYRO 				= 0X06
	OPERATION_MODE_AMG 				= 0X07
	OPERATION_MODE_IMUPLUS 				= 0X08
	OPERATION_MODE_COMPASS 				= 0X09
	OPERATION_MODE_M4G 				= 0X0A
	OPERATION_MODE_NDOF_FMC_OFF 			= 0X0B
	OPERATION_MODE_NDOF 				= 0X0C

	# Output vector type
	VECTOR_ACCELEROMETER 				= 0x08
	VECTOR_MAGNETOMETER  				= 0x0E
	VECTOR_GYROSCOPE     				= 0x14
	VECTOR_EULER         				= 0x1A
	VECTOR_LINEARACCEL   				= 0x28
	VECTOR_GRAVITY       				= 0x2E

	# REGISTER DEFINITION START
	BNO055_PAGE_ID_ADDR 				= 0X07

	BNO055_CHIP_ID_ADDR 				= 0x00
	BNO055_ACCEL_REV_ID_ADDR 			= 0x01
	BNO055_MAG_REV_ID_ADDR 				= 0x02
	BNO055_GYRO_REV_ID_ADDR 			= 0x03
	BNO055_SW_REV_ID_LSB_ADDR 			= 0x04
	BNO055_SW_REV_ID_MSB_ADDR 			= 0x05
	BNO055_BL_REV_ID_ADDR 				= 0X06

	# Accel data register 
	BNO055_ACCEL_DATA_X_LSB_ADDR 			= 0X08
	BNO055_ACCEL_DATA_X_MSB_ADDR 			= 0X09
	BNO055_ACCEL_DATA_Y_LSB_ADDR 			= 0X0A
	BNO055_ACCEL_DATA_Y_MSB_ADDR 			= 0X0B
	BNO055_ACCEL_DATA_Z_LSB_ADDR 			= 0X0C
	BNO055_ACCEL_DATA_Z_MSB_ADDR 			= 0X0D

	# Mag data register 
	BNO055_MAG_DATA_X_LSB_ADDR 			= 0X0E
	BNO055_MAG_DATA_X_MSB_ADDR 			= 0X0F
	BNO055_MAG_DATA_Y_LSB_ADDR 			= 0X10
	BNO055_MAG_DATA_Y_MSB_ADDR 			= 0X11
	BNO055_MAG_DATA_Z_LSB_ADDR 			= 0X12
	BNO055_MAG_DATA_Z_MSB_ADDR			= 0X13

	# Gyro data registers 
	BNO055_GYRO_DATA_X_LSB_ADDR 			= 0X14
	BNO055_GYRO_DATA_X_MSB_ADDR 			= 0X15
	BNO055_GYRO_DATA_Y_LSB_ADDR 			= 0X16
	BNO055_GYRO_DATA_Y_MSB_ADDR 			= 0X17
	BNO055_GYRO_DATA_Z_LSB_ADDR 			= 0X18
	BNO055_GYRO_DATA_Z_MSB_ADDR 			= 0X19
	
	# Euler data registers 
	BNO055_EULER_H_LSB_ADDR 			= 0X1A
	BNO055_EULER_H_MSB_ADDR 			= 0X1B
	BNO055_EULER_R_LSB_ADDR 			= 0X1C
	BNO055_EULER_R_MSB_ADDR 			= 0X1D
	BNO055_EULER_P_LSB_ADDR 			= 0X1E
	BNO055_EULER_P_MSB_ADDR 			= 0X1F

	# Quaternion data registers 
	BNO055_QUATERNION_DATA_W_LSB_ADDR 		= 0X20
	BNO055_QUATERNION_DATA_W_MSB_ADDR 		= 0X21
	BNO055_QUATERNION_DATA_X_LSB_ADDR 		= 0X22
	BNO055_QUATERNION_DATA_X_MSB_ADDR 		= 0X23
	BNO055_QUATERNION_DATA_Y_LSB_ADDR 		= 0X24
	BNO055_QUATERNION_DATA_Y_MSB_ADDR 		= 0X25
	BNO055_QUATERNION_DATA_Z_LSB_ADDR 		= 0X26
	BNO055_QUATERNION_DATA_Z_MSB_ADDR 		= 0X27

	# Linear acceleration data registers 
	BNO055_LINEAR_ACCEL_DATA_X_LSB_ADDR 		= 0X28
	BNO055_LINEAR_ACCEL_DATA_X_MSB_ADDR 		= 0X29
	BNO055_LINEAR_ACCEL_DATA_Y_LSB_ADDR	 	= 0X2A
	BNO055_LINEAR_ACCEL_DATA_Y_MSB_ADDR		= 0X2B
	BNO055_LINEAR_ACCEL_DATA_Z_LSB_ADDR		= 0X2C
	BNO055_LINEAR_ACCEL_DATA_Z_MSB_ADDR		= 0X2D

	# Gravity data registers 
	BNO055_GRAVITY_DATA_X_LSB_ADDR 			= 0X2E
	BNO055_GRAVITY_DATA_X_MSB_ADDR	 		= 0X2F
	BNO055_GRAVITY_DATA_Y_LSB_ADDR 			= 0X30
	BNO055_GRAVITY_DATA_Y_MSB_ADDR 			= 0X31
	BNO055_GRAVITY_DATA_Z_LSB_ADDR 			= 0X32
	BNO055_GRAVITY_DATA_Z_MSB_ADDR 			= 0X33

	# Temperature data register 
	BNO055_TEMP_ADDR 				= 0X34

	# Status registers 
	BNO055_CALIB_STAT_ADDR 				= 0X35
	BNO055_SELFTEST_RESULT_ADDR	 		= 0X36
	BNO055_INTR_STAT_ADDR 				= 0X37

	BNO055_SYS_CLK_STAT_ADDR 			= 0X38
	BNO055_SYS_STAT_ADDR 				= 0X39
	BNO055_SYS_ERR_ADDR 				= 0X3A

	# Unit selection register 
	BNO055_UNIT_SEL_ADDR 				= 0X3B
	BNO055_DATA_SELECT_ADDR 			= 0X3C

	# Mode registers 
	BNO055_OPR_MODE_ADDR 				= 0X3D
	BNO055_PWR_MODE_ADDR 				= 0X3E

	BNO055_SYS_TRIGGER_ADDR 			= 0X3F
	BNO055_TEMP_SOURCE_ADDR 			= 0X40

	# Axis remap registers 
	BNO055_AXIS_MAP_CONFIG_ADDR 			= 0X41
	BNO055_AXIS_MAP_SIGN_ADDR 			= 0X42

	# SIC registers 
	BNO055_SIC_MATRIX_0_LSB_ADDR 			= 0X43
	BNO055_SIC_MATRIX_0_MSB_ADDR 			= 0X44
	BNO055_SIC_MATRIX_1_LSB_ADDR 			= 0X45
	BNO055_SIC_MATRIX_1_MSB_ADDR 			= 0X46
	BNO055_SIC_MATRIX_2_LSB_ADDR 			= 0X47
	BNO055_SIC_MATRIX_2_MSB_ADDR 			= 0X48
	BNO055_SIC_MATRIX_3_LSB_ADDR 			= 0X49
	BNO055_SIC_MATRIX_3_MSB_ADDR 			= 0X4A
	BNO055_SIC_MATRIX_4_LSB_ADDR 			= 0X4B
	BNO055_SIC_MATRIX_4_MSB_ADDR 			= 0X4C
	BNO055_SIC_MATRIX_5_LSB_ADDR 			= 0X4D
	BNO055_SIC_MATRIX_5_MSB_ADDR 			= 0X4E
	BNO055_SIC_MATRIX_6_LSB_ADDR 			= 0X4F
	BNO055_SIC_MATRIX_6_MSB_ADDR 			= 0X50
	BNO055_SIC_MATRIX_7_LSB_ADDR 			= 0X51
	BNO055_SIC_MATRIX_7_MSB_ADDR 			= 0X52
	BNO055_SIC_MATRIX_8_LSB_ADDR 			= 0X53
	BNO055_SIC_MATRIX_8_MSB_ADDR 			= 0X54
	
	# Accelerometer Offset registers	 
	ACCEL_OFFSET_X_LSB_ADDR 			= 0X55
	ACCEL_OFFSET_X_MSB_ADDR 			= 0X56
	ACCEL_OFFSET_Y_LSB_ADDR 			= 0X57
	ACCEL_OFFSET_Y_MSB_ADDR 			= 0X58
	ACCEL_OFFSET_Z_LSB_ADDR 			= 0X59
	ACCEL_OFFSET_Z_MSB_ADDR 			= 0X5A

	# Magnetometer Offset registers 
	MAG_OFFSET_X_LSB_ADDR 				= 0X5B
	MAG_OFFSET_X_MSB_ADDR 				= 0X5C
	MAG_OFFSET_Y_LSB_ADDR 				= 0X5D
	MAG_OFFSET_Y_MSB_ADDR 				= 0X5E
	MAG_OFFSET_Z_LSB_ADDR 				= 0X5F
	MAG_OFFSET_Z_MSB_ADDR 				= 0X60

	# Gyroscope Offset registers
	GYRO_OFFSET_X_LSB_ADDR 				= 0X61
	GYRO_OFFSET_X_MSB_ADDR 				= 0X62
	GYRO_OFFSET_Y_LSB_ADDR 				= 0X63
	GYRO_OFFSET_Y_MSB_ADDR 				= 0X64
	GYRO_OFFSET_Z_LSB_ADDR 				= 0X65
	GYRO_OFFSET_Z_MSB_ADDR 				= 0X66

	# Radius registers 
	ACCEL_RADIUS_LSB_ADDR 				= 0X67
	ACCEL_RADIUS_MSB_ADDR 				= 0X68
	MAG_RADIUS_LSB_ADDR 				= 0X69
	MAG_RADIUS_MSB_ADDR 				= 0X6A

	# REGISTER DEFINITION END


	def __init__(self, sensorId=-1, address=0x28):
		self._sensorId = sensorId
		self._address = address
		self._mode = BNO055.OPERATION_MODE_NDOF


	def begin(self, mode=None):
		if mode is None: mode = BNO055.OPERATION_MODE_NDOF
		# Open I2C bus
		self._bus = smbus.SMBus(1)

		# Make sure we have the right device
		if self.readBytes(BNO055.BNO055_CHIP_ID_ADDR)[0] != BNO055.BNO055_ID:
			time.sleep(1)	# Wait for the device to boot up
			if self.readBytes(BNO055.BNO055_CHIP_ID_ADDR)[0] != BNO055.BNO055_ID:
				return False

		# Switch to config mode
		self.setMode(BNO055.OPERATION_MODE_CONFIG)

		# Trigger a reset and wait for the device to boot up again
		self.writeBytes(BNO055.BNO055_SYS_TRIGGER_ADDR, [0x20])
		time.sleep(1)
		while self.readBytes(BNO055.BNO055_CHIP_ID_ADDR)[0] != BNO055.BNO055_ID:
			time.sleep(0.01)
		time.sleep(0.05)

		# Set to normal power mode
		self.writeBytes(BNO055.BNO055_PWR_MODE_ADDR, [BNO055.POWER_MODE_NORMAL])
		time.sleep(0.01)

		self.writeBytes(BNO055.BNO055_PAGE_ID_ADDR, [0])
		self.writeBytes(BNO055.BNO055_SYS_TRIGGER_ADDR, [0])
		time.sleep(0.01)

		# Set the requested mode
		self.setMode(mode)
		time.sleep(0.02)

		return True

	def setMode(self, mode):
		self._mode = mode
		self.writeBytes(BNO055.BNO055_OPR_MODE_ADDR, [self._mode])
		time.sleep(0.03)

	def setExternalCrystalUse(self, useExternalCrystal = True):
		prevMode = self._mode
		self.setMode(BNO055.OPERATION_MODE_CONFIG)
		time.sleep(0.025)
		self.writeBytes(BNO055.BNO055_PAGE_ID_ADDR, [0])
		self.writeBytes(BNO055.BNO055_SYS_TRIGGER_ADDR, [0x80] if useExternalCrystal else [0])
		time.sleep(0.01)
		self.setMode(prevMode)
		time.sleep(0.02)

	def getSystemStatus(self):
		self.writeBytes(BNO055.BNO055_PAGE_ID_ADDR, [0])
		(sys_stat, sys_err) = self.readBytes(BNO055.BNO055_SYS_STAT_ADDR, 2)
		self_test = self.readBytes(BNO055.BNO055_SELFTEST_RESULT_ADDR)[0]
		return (sys_stat, self_test, sys_err)

	def get_system_status(self):
		sys_stat, self_test, sys_err = self.getSystemStatus()
		return (sys_stat, self_test, sys_err)

	def getRevInfo(self):
		(accel_rev, mag_rev, gyro_rev) = self.readBytes(BNO055.BNO055_ACCEL_REV_ID_ADDR, 3)
		sw_rev = self.readBytes(BNO055.BNO055_SW_REV_ID_LSB_ADDR, 2)
		sw_rev = sw_rev[0] | sw_rev[1] << 8
		bl_rev = self.readBytes(BNO055.BNO055_BL_REV_ID_ADDR)[0]
		return (accel_rev, mag_rev, gyro_rev, sw_rev, bl_rev)

	def get_revision(self):
		accel_rev, mag_rev, gyro_rev, sw_rev, bl_rev = self.getRevInfo()
		return (sw_rev, bl_rev, accel_rev, mag_rev, gyro_rev)

	def getCalibration(self):
		calData = self.readBytes(BNO055.BNO055_CALIB_STAT_ADDR)[0]
		return (calData >> 6 & 0x03, calData >> 4 & 0x03, calData >> 2 & 0x03, calData & 0x03)

	def get_calibration_status(self):
		sys, gyro, accel, mag = self.getCalibration()
		return (sys,gyro,accel,mag)

	def getTemp(self):
		return self.readBytes(BNO055.BNO055_TEMP_ADDR)[0]

	def getVector(self, vectorType):
		buf = self.readBytes(vectorType, 6)
		xyz = (struct.unpack('hhh', ''.join(struct.pack('BBBBBB', buf[0], buf[1], buf[2], buf[3], buf[4], buf[5]))))
		if vectorType == BNO055.VECTOR_MAGNETOMETER:	scalingFactor = 16.0
		elif vectorType == BNO055.VECTOR_GYROSCOPE:	scalingFactor = 900.0
		elif vectorType == BNO055.VECTOR_EULER:		 scalingFactor = 16.0
		elif vectorType == BNO055.VECTOR_GRAVITY:	scalingFactor = 100.0
		else:											scalingFactor = 1.0
		return tuple([i/scalingFactor for i in xyz])

	def read_euler(self):
		a,b,c=self.getVector(BNO055.VECTOR_EULER)
		return (a,b,c)

	def read_linear_acceleration(self):
		a,b,c = self.getVector(BNO055.VECTOR_LINEARACCEL)
		return (a,b,c)

	def getQuat(self):
		buf = self.readBytes(BNO055.BNO055_QUATERNION_DATA_W_LSB_ADDR, 8)
		wxyz = (struct.unpack('hhhh', ''.join(struct.pack('BBBBBBBB', buf[0], buf[1], buf[2], buf[3], buf[4], buf[5], buf[6], buf[7]))))
		return tuple([i * (1.0 / (1 << 14)) for i in wxyz])

	def readBytes(self, register, numBytes=1):
		return self._bus.read_i2c_block_data(self._address, register, numBytes)

	def writeBytes(self, register, byteVals):
		return self._bus.write_i2c_block_data(self._address, register, byteVals)


if __name__ == '__main__':
	bno = BNO055()
	if bno.begin() is not True:
		print "Error initializing device"
		exit()
	time.sleep(1)
	bno.setExternalCrystalUse(True)
	while True:
		print bno.getVector(BNO055.VECTOR_EULER)
		time.sleep(0.01)
