cbkiyanda/AR/(commit log)

2018-01-24 Adding files from Sagar Dixit work
    [2d streamlines past a cylinder.py, streamlines in augmented reality.py]
2018-01-24 Updates to sensor data test --Cleaning up code and adding some comments --Removing unneeded configurations
2018-01-31 renaming cube_test.py
    Renamed cube_test.py to cube_test_withsensor.py to make
    it more obvious that this version uses the BNO055 sensor
2018-03-14 fixing tabbing vs spaces in BNO055.py
    [BNO055.py]
2018-03-28 Restoring cube test demo using only bno0055 sensor
2018-04-01 Engineering Drawings, Cads, Testing, FEA, Reports, Presentations & more from the 2017-18 Capstone team.
    [0007A_Odroid XU4.SLDDRW, 0007A_Odroid XU4.SLDPRT, 007A_Odroid XU4.SLDDRW, 11809001_Headset V4.SLDDRW, 11809001_Headset V4.SLDPRT, 11809001_Headset V5.SLDDRW, 11809001_Headset V5.SLDPRT, 11809002_Top Cover V4.SLDDRW]
