cbkiyanda/AR/Documents/Capstone 2017-18/Experiment Videos and Pictures/Drop Test/20180329_001701.jpg

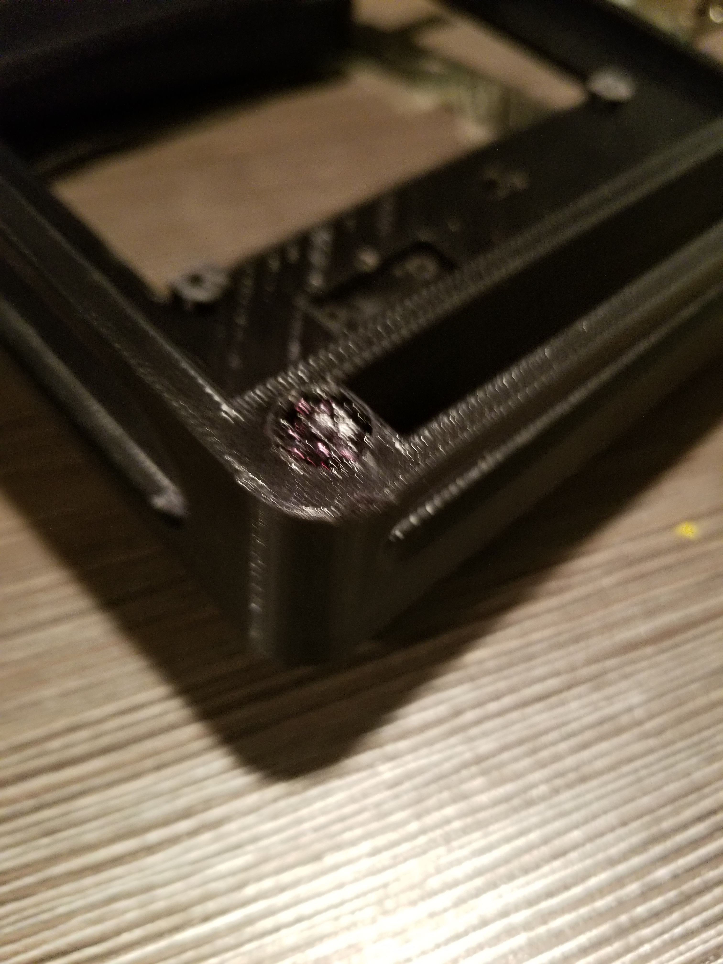
Documents/Capstone 2017-18/Experiment Videos and Pictures/Drop Test/20180329_001701.jpg
