cbkiyanda/AR/Documents/Capstone 2017-18/Experiment Videos and Pictures/Drop Test/20180329_003005.jpg

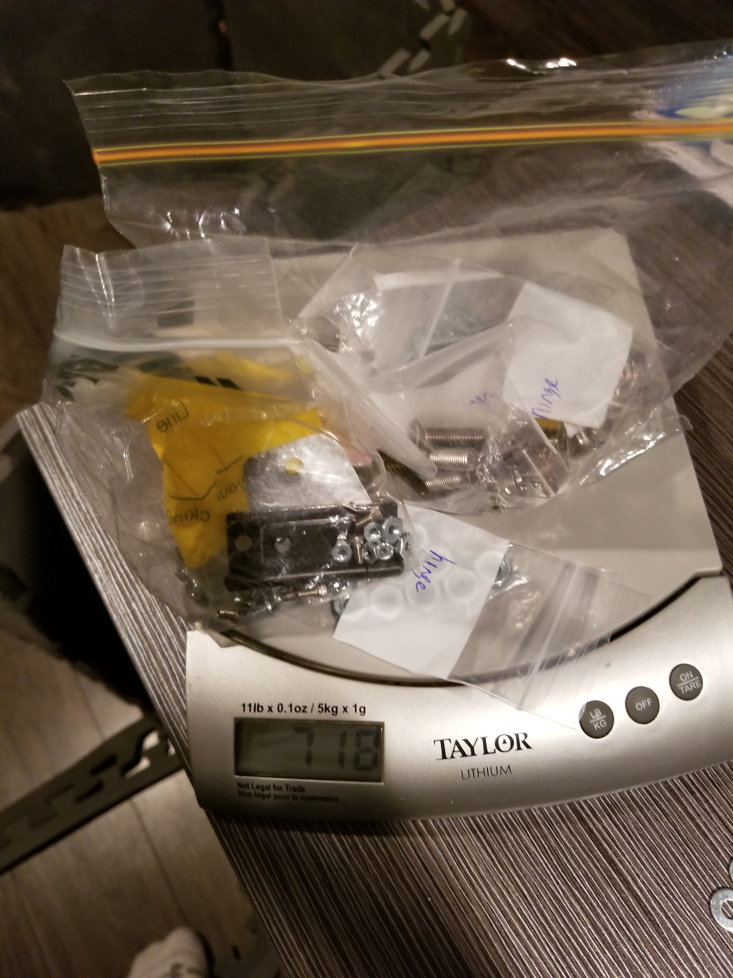
Documents/Capstone 2017-18/Experiment Videos and Pictures/Drop Test/20180329_003005.jpg
